liaojingwu20041031/electric-power-inspection-robot/docs/云平台连接运维.md

# Jetson 云平台连接运维

> Robot Platform Protocol v1 见 [协议文档](protocol/robot-platform-v1.md)。本文只覆盖 Jetson 部署、连接开关、观察、备份和回退，不授权任何实机运动。

## 1. 架构边界

网桥核心进程、本地 APP 服务和云平台连接是三个概念。核心进程同时承载 ROS、FastAPI
和 Cloud Client；本地 APP 开关只门控局域网手机接口；云平台开关只控制 Jetson 主动
发起的 HTTPS 连接。任一业务开关都不会停止核心进程。

Jetson 是公网连接的唯一发起方：

```text
Jetson mobile bridge -> HTTPS https://example.com/robot-api/v1
Robot Bridge          -X-> Jetson
```

Jetson 不需要公网 IP、端口映射或开放 8000。`/api/platform/v1` 只用于本机/可信局域网调试；配置 Cloud Link 后入站写控制默认关闭。

> 路由故障切换不等于 Wi-Fi 热点断线重连。`configure_dual_network.sh` 只管理有线/Wi-Fi
> 默认路由 metric；热点消失后重新关联和 DHCP 恢复由
> [热点断线自动重连运维](热点断线自动重连运维.md) 中的 NetworkManager 配置与 watchdog
> 负责。两套脚本互不修改对方字段。

### 1.1 单客户端双出口

本地 APP 的 Wi-Fi/有线地址是同时可访问的双入口；云平台不是双客户端并发。Cloud Link
只创建一个 `PlatformCloudClient`，保留唯一的 robotId、bootId、heartbeat、命令领取、
ACK 和事件上传状态，避免双客户端造成重复 heartbeat、重复 ACK、重复事件或重复命令。

公网出口由 Linux 系统路由决定，推荐 5G 有线默认路由 metric `100`，Wi-Fi 默认路由
metric `600`。有线接口 down、网线拔出或默认路由消失后，Cloud Client 的下一次正常
重试可由系统路由走 Wi-Fi。`cloud_status` 仅在本地增加 `networkMode=system-routing`、
`cloudEgress`、`alternateCloudRoutes`、`failoverAvailable` 和
`lastSuccessfulEgress` 诊断；这些字段不加入公网 heartbeat，平台协议无需同步修改。

接口断开和运营商 WAN 断开不同：若 5G CPE 网线仍连接、接口和默认路由仍存在，但 CPE
公网已经失效，单靠 route metric 不能保证主动切换。本轮不增加自动关网卡或动态改路由
守护程序。后续如需健康守护，应包含连续失败/成功阈值、最短保持时间、防抖和恢复逻辑。

### 1.2 NetworkManager 可逆配置

脚本只修改四个属性：IPv4/IPv6 的 `route-metric` 和 `never-default`，不修改地址、网关、
DNS、Wi-Fi 密码、自动连接、防火墙、SSH 或 NetworkManager 服务。

```bash
cd /home/nvidia/ros2_DL
YLHB_NETWORK_PRIMARY_CONNECTION='Wired connection 1' \
YLHB_NETWORK_SECONDARY_CONNECTION='xxfq1' \
./scripts/configure_dual_network.sh status

YLHB_NETWORK_PRIMARY_CONNECTION='Wired connection 1' \
YLHB_NETWORK_SECONDARY_CONNECTION='xxfq1' \
./scripts/configure_dual_network.sh dry-run
```

现场确认后才可执行 `apply`。脚本会先备份到
`~/.config/ylhb/dual_network_backup.json`，且不会自动 down/up 当前连接，以免立即中断
SSH；修改后由现场人员重新激活连接。恢复命令为：

```bash
./scripts/configure_dual_network.sh restore
```

若两个物理接口处于相同 IPv4 子网，脚本报告“网络子网冲突”并拒绝 apply；不要尝试自动
修复，应先调整热点或 5G CPE 的 LAN 网段。

## 2. `platform.env` 变量表

文件：`/home/nvidia/.config/ylhb/platform.env`，权限 `0600`。Token 不写 YAML、launch、仓库或日志。

| 变量 | 必填 | 示例 | 用途 | 敏感 | 修改后重启 |
| --- | --- | --- | --- | --- | --- |
| `YLHB_CLOUD_ENABLED` | 是 | `true` | systemd 启动后默认是否连接 | 否 | 是；UI override 可即时改变 |
| `YLHB_LOCAL_APP_ENABLED` | 否 | `true` | 本地 APP 服务默认是否开放 | 否 | 是；UI override 可即时改变 |
| `YLHB_CLOUD_BASE_URL` | 是 | `https://example.com` | 公网 Robot Bridge 根 URL；必须 HTTPS | 否 | 是 |
| `YLHB_CLOUD_ROBOT_TOKEN` | 是 | `token-placeholder` | robot-001 设备凭据 | 是 | 是 |
| `YLHB_CLOUD_CA_FILE` | 否 | `/etc/ssl/certs/private-ca.pem` | 私有 CA；公有 CA 留空 | 否 | 是 |
| `YLHB_CLOUD_REQUEST_TIMEOUT_SEC` | 否 | `10` | 单次 HTTP 超时 | 否 | 是 |
| `YLHB_CLOUD_IDLE_HEARTBEAT_SEC` | 否 | `3` | 空闲 fallback 心跳间隔 | 否 | 是 |
| `YLHB_CLOUD_ACTIVE_HEARTBEAT_SEC` | 否 | `1` | 活动 fallback 心跳间隔 | 否 | 是 |
| `YLHB_CLOUD_MAX_BACKOFF_SEC` | 否 | `30` | 最大退避 | 否 | 是 |
| `YLHB_MAP_UPLOAD_ENABLED` | 否 | `true` | 是否启动默认地图上传 worker | 否 | 是 |
| `YLHB_MAP_UPLOAD_CONNECT_TIMEOUT_SEC` | 否 | `10` | 地图上传连接超时 | 否 | 是 |
| `YLHB_MAP_UPLOAD_READ_TIMEOUT_SEC` | 否 | `60` | 地图上传响应读取超时 | 否 | 是 |
| `YLHB_MAP_UPLOAD_RETRY_BASE_SEC` | 否 | `2` | 地图上传指数退避初始秒数 | 否 | 是 |
| `YLHB_MAP_UPLOAD_RETRY_MAX_SEC` | 否 | `300` | 地图上传指数退避上限秒数 | 否 | 是 |
| `YLHB_MAP_UPLOAD_YAML_MAX_BYTES` | 否 | `1048576` | YAML 上限 1 MiB | 否 | 是 |
| `YLHB_MAP_UPLOAD_PGM_MAX_BYTES` | 否 | `104857600` | PGM 上限 100 MiB | 否 | 是 |
| `YLHB_MAP_UPLOAD_REQUEST_MAX_BYTES` | 否 | `115343360` | multipart 总上限 110 MiB | 否 | 是 |
| `YLHB_MAP_UPLOAD_SUCCESS_RETENTION_SEC` | 否 | `86400` | 成功快照保留时间 | 否 | 是 |
| `YLHB_MAP_UPLOAD_SUCCESS_KEEP` | 否 | `2` | 最多保留的成功快照数 | 否 | 是 |
| `YLHB_MAP_UPLOAD_SNAPSHOT_MAX_BYTES` | 否 | `1073741824` | 地图上传快照磁盘上限 | 否 | 是 |
| `YLHB_INSPECTION_IMAGE_UPLOAD_ENABLED` | 否 | `true` | 是否启用巡逻图片抓取和持久上传 | 否 | 是 |
| `YLHB_INSPECTION_IMAGE_UPLOAD_MAX_BYTES` | 否 | `20971520` | 单张图片上传上限 20 MiB | 否 | 是 |
| `YLHB_INSPECTION_IMAGE_UPLOAD_SNAPSHOT_MAX_BYTES` | 否 | `2147483648` | 图片快照磁盘上限 2 GiB | 否 | 是 |
| `YLHB_SOFTWARE_VERSION` | 否 | `79df249` | heartbeat 软件版本 | 否 | 是 |
| `YLHB_ROBOT_ID` | 是 | `robot-001` | 机器人身份 | 否 | 是 |
| `YLHB_PLATFORM_STORAGE_DIR` | 否 | `/home/nvidia/.local/share/ylhb/platform` | deployment、command、event SQLite 根目录 | 否 | 是 |
| `YLHB_PLATFORM_API_TOKEN` | 本地 API 启用时 | `token-placeholder` | `/api/platform/v1` 本地调试鉴权 | 是 | 是 |
| `YLHB_ALLOW_INBOUND_PLATFORM_CONTROL` | 否 | `false` | 是否允许本地入站写控制；生产保持 false | 否 | 是 |

受保护 env 示例仅使用占位值：

```dotenv
YLHB_CLOUD_ENABLED=true
YLHB_LOCAL_APP_ENABLED=true
YLHB_CLOUD_BASE_URL=https://example.com
YLHB_CLOUD_ROBOT_TOKEN=token-placeholder
YLHB_CLOUD_REQUEST_TIMEOUT_SEC=10
YLHB_CLOUD_IDLE_HEARTBEAT_SEC=3
YLHB_CLOUD_ACTIVE_HEARTBEAT_SEC=1
YLHB_CLOUD_MAX_BACKOFF_SEC=30
YLHB_MAP_UPLOAD_ENABLED=true
YLHB_MAP_UPLOAD_RETRY_BASE_SEC=2
YLHB_MAP_UPLOAD_RETRY_MAX_SEC=300
YLHB_INSPECTION_IMAGE_UPLOAD_ENABLED=true
YLHB_INSPECTION_IMAGE_UPLOAD_MAX_BYTES=20971520
YLHB_INSPECTION_IMAGE_UPLOAD_SNAPSHOT_MAX_BYTES=2147483648
YLHB_SOFTWARE_VERSION=79df249
YLHB_ROBOT_ID=robot-001
YLHB_PLATFORM_STORAGE_DIR=/home/nvidia/.local/share/ylhb/platform
YLHB_ALLOW_INBOUND_PLATFORM_CONTROL=false
```

不要提交该文件。公有 CA 场景不配置 `YLHB_CLOUD_CA_FILE`；禁止关闭 TLS 校验。

图片 worker 复用 Cloud URL、Token、CA、请求超时和最大退避。`401/403` 会停止新抓图；网络错误、`429/5xx` 使用原图片和原幂等键重试；最终失败图片保留作为证据，磁盘超限时只清理其中最旧的文件。

## 3. 安装与启动 systemd

```bash
cd /home/nvidia/ros2_DL
./scripts/install_platform_bridge_service.sh
sudo systemctl status ylhb-mobile-bridge --no-pager
sudo systemctl enable ylhb-mobile-bridge
sudo systemctl restart ylhb-mobile-bridge
```

生产 UI/Supervisor 必须传：

```text
mobile_bridge_managed_externally:=true
```

其配置语义是 `mobile_bridge_managed_externally=true`；ROS 2 launch 命令行使用 `:=true` 赋值语法。

仓库的 UI 自启动 wrapper 已传该参数。此时 Supervisor 不再启动、停止或重启 mobile bridge，只观察端口状态，避免双实例。

## 4. 确认只有一个 Mobile Bridge

```bash
systemctl is-active ylhb-mobile-bridge
pgrep -af 'ylhb_mobile_bridge mobile_bridge_server'
ros2 node list --no-daemon | grep mobile_bridge
ss -lntp | grep ':8000'
```

通过标准：

- systemd active；
- 只有一个 `mobile_bridge_server` 进程；
- 只有一个对应 ROS node；
- 8000 只有一个监听者。

若有第二个开发 launch，停止开发终端中的实例；不要 kill systemd 后让 Supervisor 接管生产进程。

## 5. Cloud status Topic

```bash
ros2 topic info /mobile_bridge/cloud_status -v --no-daemon
ros2 topic echo /mobile_bridge/cloud_status --once
```

主要字段：configured、desiredEnabled、connected、state、heartbeatInFlight、consecutiveFailures、serverBaseUrl、pendingEventCount、pendingCommandCount、lastReceivedCommandId、lastUploadedSequence、latestLocalEventSequence、activeExecutionId、activeDeploymentId、lastSuccessAt、lastError、nextHeartbeatSec、nextRetrySec。

`CONNECTED` 时下一轮 heartbeat 会保持连接状态，仅 `heartbeatInFlight=true`；`nextHeartbeatSec` 是正常心跳间隔。只有网络/HTTP 通信失败才进入 `BACKOFF`，此时 `nextRetrySec` 是退避重试时间。UI 主卡以 `connected=true` 为优先级，不把短暂 raw `CONNECTING` 显示为断线；raw state 保留在诊断区。

Topic 使用可靠、Transient Local QoS，UI 晚加入也能获得最近状态。

## 6. SetBool 连接开关

只控制 Cloud Link，不控制巡检：

```bash
ros2 service type /mobile_bridge/set_cloud_enabled
ros2 service call /mobile_bridge/set_cloud_enabled std_srvs/srv/SetBool '{data: false}'
ros2 service call /mobile_bridge/set_cloud_enabled std_srvs/srv/SetBool '{data: true}'
```

- false：持久化 override，进入 DISABLED，停止 heartbeat/领命令/上传事件。
- 关闭连接不会停止当前巡检，不会发布 pause/cancel/急停。
- true：进入 CONNECTING，成功后 CONNECTED，并从服务器连续游标补传积压事件。
- 配置缺失时开启返回失败，state 保持 UNCONFIGURED。

## 7. UI 开关与状态

本体 UI“连接与服务”页有两个独立 Switch：

- 本地 APP Switch 调用 `/mobile_bridge/set_local_app_enabled`；关闭不会改变
  `cloudStatus.desiredEnabled`，Cloud Client 继续 heartbeat 和事件补传。
- 云平台 Switch 调用 `/mobile_bridge/set_cloud_enabled`；关闭不会改变
  `localAppStatus.enabled`，手机仍可访问本地 API/WS。
- 两个 Switch 都不会调用 systemd、Shell 或核心进程启停命令。
- Service 成功只表示请求被接受；Switch 保持用户目标，直到状态 Topic 确认，5 秒无确认会提示而不伪造成功。

UI 不再用 Supervisor 的单个 process 字段全局锁死两张卡。每秒直接检查两个 SetBool Service 与两个状态 Topic publisher：本地 APP 开关只依赖本地 Service/状态，云开关只依赖 Cloud Service/状态和 `configured`。核心未启动、Topic 状态过期、Cloud 网络离线是三种不同状态；本地 APP 关闭也不会被解释为核心进程停止。兼容字段 `mobile_bridge_http` 实际是 8000 TCP 探测，新代码优先使用 `mobile_bridge_core_state` 与 `mobile_bridge_tcp`。

Cloud SetBool 成功或失败后都会立即发布一次 `/mobile_bridge/cloud_status`，无需等待 0.5 秒周期刷新；失败状态只记录脱敏异常类型。

云平台卡显示：

| 状态 | 含义 | 操作 |
| --- | --- | --- |
| `UNCONFIGURED` | URL/Token/CA 配置无效 | 修复 env，重启服务 |
| `DISABLED` | 用户或 env 关闭连接 | 可手动开启 |
| `CONNECTING` | 正在建立/恢复连接 | 等待或看日志 |
| `CONNECTED` | 最近心跳成功 | 正常 |
| `BACKOFF` | 网络/HTTP 失败，指数退避 | 看 lastError、TLS、DNS、服务状态 |

活动 execution 中关闭云开关必须确认，明确说明本地 APP 和当前巡检不会停止，积压事件
在重连后补传。关闭本地 APP 使用另一份确认文案，明确说明云平台连接和当前巡检不受影响。

本地 APP override 保存在 `bridge_settings.local_app_enabled_override`；云平台 override
仍保存在 `cloud_state.cloud_enabled_override`，两者不共享字段。

## 8. 入站控制默认关闭

生产保持：

```text
YLHB_ALLOW_INBOUND_PLATFORM_CONTROL=false
```

配置 Cloud Link 后，Jetson `/api/platform/v1` 的 deploy/start/pause/resume/takeover/cancel 写接口返回 `409 INBOUND_CONTROL_DISABLED`。暂停 Cloud Link 不会自动开放入站控制。

## 9. 日志与脱敏检查

```bash
sudo journalctl -u ylhb-mobile-bridge -n 200 --no-pager
sudo journalctl -u ylhb-mobile-bridge -f
```

Cloud Client 只应记录 HTTP 状态、异常类型和脱敏 URL。验证 Token 未打印时，不输出 Token 本身：

```bash
sudo journalctl -u ylhb-mobile-bridge --since today --no-pager \
  | grep -E 'Authorization:|Bearer |YLHB_CLOUD_ROBOT_TOKEN|token=' && echo '发现疑似敏感日志' || echo '未发现常见敏感模式'
```

还应人工确认 serverBaseUrl 不含 userinfo、query 或 fragment。

## 10. 备份 Robot 平台 SQLite

默认目录：

```text
~/.local/share/ylhb/platform/platform.db
~/.local/share/ylhb/platform/deployments/
```

在线备份：

```bash
mkdir -p /home/nvidia/backups/ylhb-platform
sqlite3 /home/nvidia/.local/share/ylhb/platform/platform.db \
  ".backup '/home/nvidia/backups/ylhb-platform/platform.db.backup'"
tar -C /home/nvidia/.local/share/ylhb/platform -czf \
  /home/nvidia/backups/ylhb-platform/deployments.backup.tgz deployments
```

备份文件必须限制权限，不上传公共位置。恢复前停止 systemd，保留故障副本，再同时恢复数据库和 deployment 文件。

## 11. 无运动连接验收

云连接显示 `CONNECTED` 只证明 Jetson 能持续 heartbeat；`READY_FOR_ROBOT` 只证明路线和地图已缓存。控制闭环还必须依次确认：Bridge command 出现并被 heartbeat 领取、Jetson 提交 ACK、ROS 收到命令、真实事件上传、Spring 消费事件并通过 STOMP 更新前端。

开发人员可执行只读检查：查看 cloud status、Bridge command/execution/event 表、ROS topic/node 信息和日志；不得据此代替现场路线运动验收。任何 START、恢复、Nav2 goal 或可能驱动底盘的操作均由现场用户确认安全后执行。

```bash
ros2 topic echo /mobile_bridge/cloud_status --once
sudo systemctl status ylhb-mobile-bridge --no-pager
```

通过标准：CONNECTED、pendingCommandCount=0、服务器 robot online=true、日志无 Token、只有一个 bridge。此步骤不创建 START，也不启动巡逻。

## 12. 回退到本地 auto 巡逻

回退只改变云连接来源，不代表授权机器人运动：

1. 通过 SetBool 关闭 Cloud Link，确认 DISABLED。
2. 保留 platform SQLite 与 pending event，不删除，便于恢复后补传。
3. 如需停止 systemd，仅在确认本地调试模式会单独启动 mobile bridge 时执行。
4. 本地路线使用仓库既有 `auto` 解析和正式路线文件，不使用云 deployment 路径。
5. 由现场用户确认急停、清场、传感器、TF、Nav2、地图和路线后，执行既有本地巡逻入口。

现场命令参考（仅用户授权后执行）：

```bash
./scripts/run_on_jetson.sh inspection
```

恢复云连接时重新启用 systemd/SetBool，等待 CONNECTED 和事件补传完成；不要在本地巡逻仍活动时领取新的 START。

## 13. 常见故障

| 症状 | 检查 |
| --- | --- |
| UNCONFIGURED | HTTPS URL、robot token、CA 文件、robotId |
| BACKOFF HTTP 401 | token 与服务器 robotId 映射；按轮换流程更新 |
| BACKOFF TLS | 域名、证书链、时间、CA 文件；禁止关闭校验 |
| CONNECTED 但 server offline | 对比服务器 lastSeen、代理路径、时间同步 |
| pendingEventCount 不下降 | accepted sequence、事件缺口、events batch 409 |
| command 长期 ACKED | ROS publish/Patrol event、system supervisor、commandId 绑定 |
| 双实例 | systemd + 开发 launch；确保 external managed=true |
| 入站接口 409 | 生产预期；不要为方便而打开入站控制 |
