liaojingwu20041031/electric-power-inspection-robot/docs/protocol/机器人平台协议-v1.md

# 协议文档路径已迁移

Robot Platform Protocol v1 的规范副本已迁移到 [robot-platform-v1.md](robot-platform-v1.md)。

平台仓库 `docs/protocol/robot-platform-v1.md` 是单一协议源；本仓库同名文件通过平台脚本同步并要求字节一致。请勿在此兼容入口继续维护协议正文。
