liaojingwu20041031/electric-power-inspection-robot/UI_sc/UI图标.png

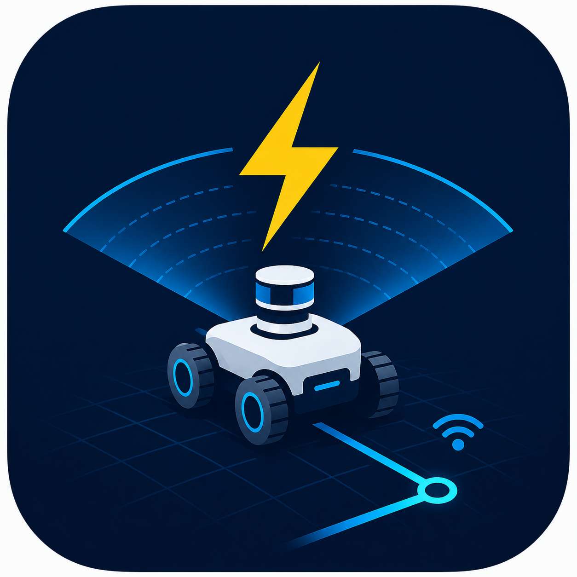
UI_sc/UI图标.png
