liaojingwu20041031/electric-power-inspection-robot/UI_sc/UI背景图1.png

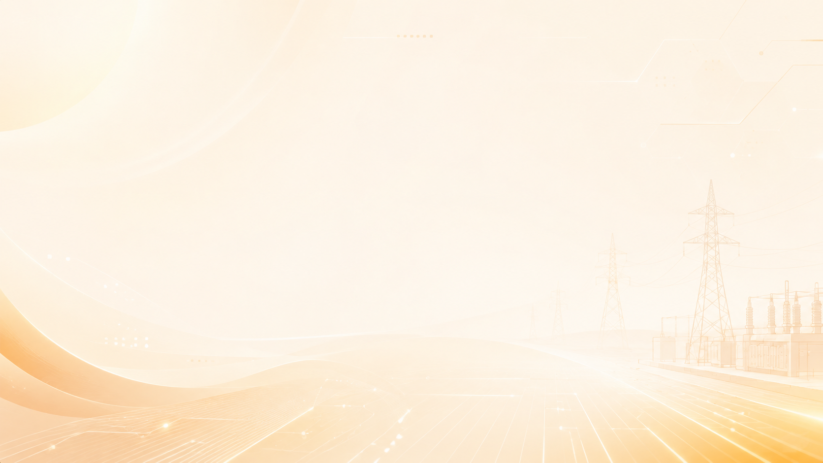
UI_sc/UI背景图1.png
