liaojingwu20041031/electric-power-inspection-robot/UI_sc/背景图2 (1).png

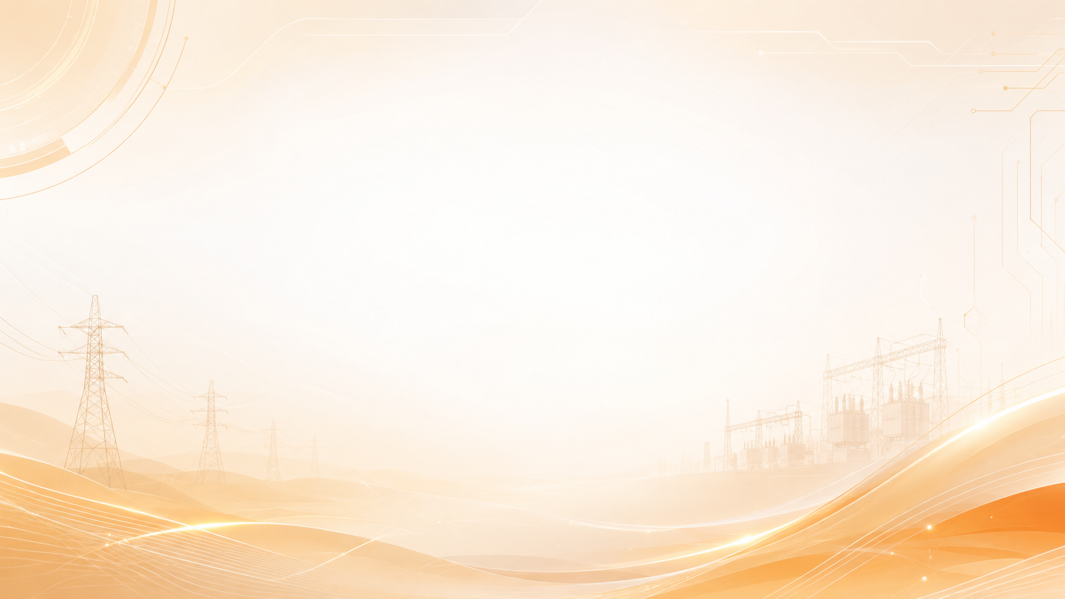
UI_sc/背景图2 (1).png
