liaojingwu20041031/electric-power-inspection-robot/UI_sc/背景图2 (4).png

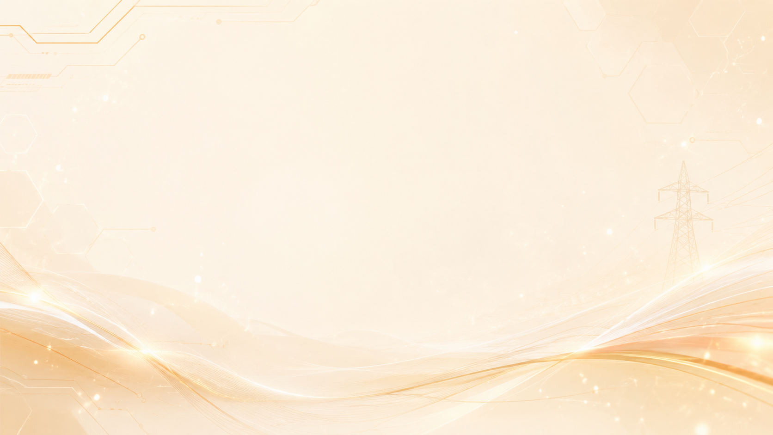
UI_sc/背景图2 (4).png
