liaojingwu20041031/electric-power-inspection-robot/记录照片/5D8596298CAE2FFCB6F57D26CB58A5C1.png

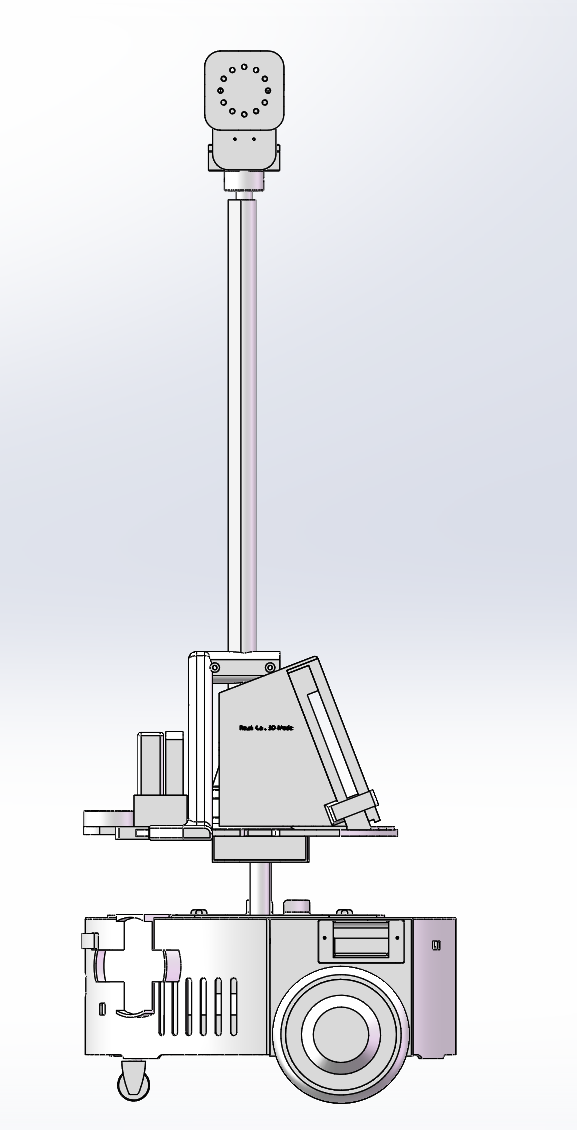
记录照片/5D8596298CAE2FFCB6F57D26CB58A5C1.png
