liaojingwu20041031/electric-power-inspection-robot/记录照片/23B6CF8AAC715B70C368A7C031887BE1.png

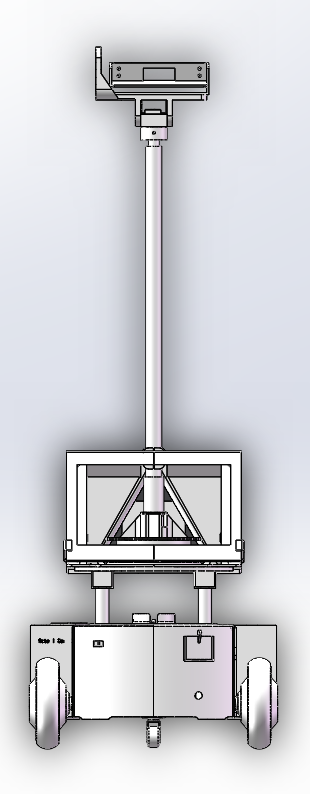
记录照片/23B6CF8AAC715B70C368A7C031887BE1.png
