liaojingwu20041031/electric-power-inspection-robot/记录照片/DE87C7969D653431019BBF287BD9881B.png

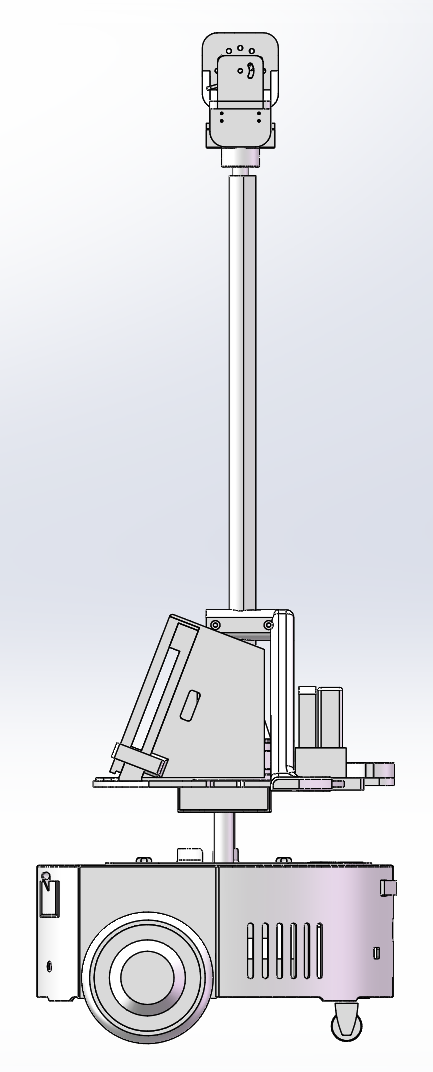
记录照片/DE87C7969D653431019BBF287BD9881B.png
