liaojingwu20041031/electric-power-inspection-robot/CAD/Retail-Cart-3D-Model/sldasm/万向轮.SLDASM

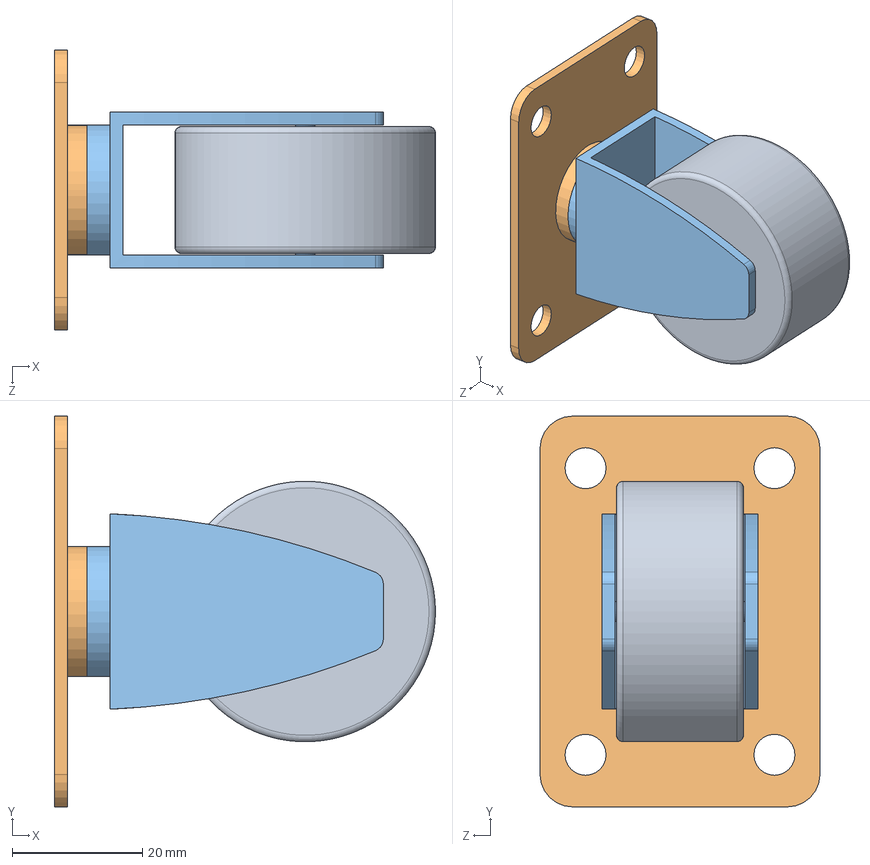
[picture p11: CAD file, 2026-06-11]
CAD/Retail-Cart-3D-Model/sldasm/万向轮.SLDASM
58.5 x 60.0 x 43.0 mm
万向轮
万向轮底座
万向轮支架
