liaojingwu20041031/electric-power-inspection-robot/CAD/Retail-Cart-3D-Model/sldasm/小车底盘.SLDASM

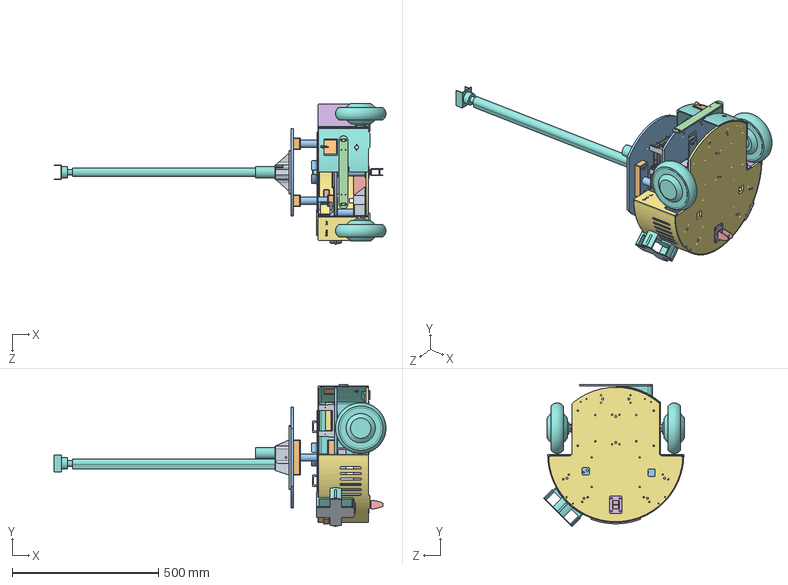
[picture p12: CAD file, 2026-06-11]
CAD/Retail-Cart-3D-Model/sldasm/小车底盘.SLDASM
1136.5 x 487.1 x 482.1 mm
底盘连接处支架X x 2
电机轮 x 2
人工智能小车底盘
万向轮底座
万向轮支架
固定盖 x 2
上底盘
螺母 x 2
驱动器
前半圆X
后半圆
后半圆X
电池
英伟达固定板X
工形柱 x 5
支架垫片 x 4
语音播报模块固定盖
语音播报模块外挂支架
电池固定
模块固定
后半圆固定架
双目垫板
第三层板
伸缩杆支架盖子
伸缩杆固定底座
伸缩杆
连接-固定件
前后半圆连接件 x 2
后半圆连接-固定件
盖板
激光雷达固定架
电池门
稳压板底座
