liaojingwu20041031/electric-power-inspection-robot/CAD/Retail-Cart-3D-Model/stp/伸缩柱.SLDPRT

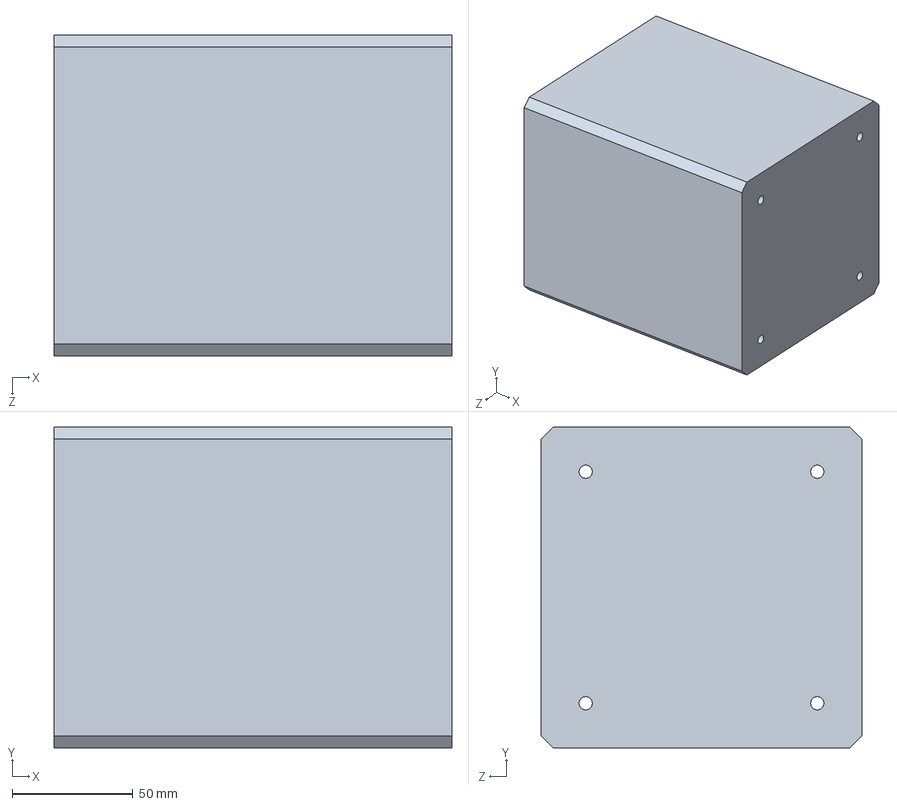
[picture p13: CAD file, 2026-06-11]
CAD/Retail-Cart-3D-Model/stp/伸缩柱.SLDPRT
165.0 x 133.0 x 133.0 mm
