liaojingwu20041031/electric-power-inspection-robot/CAD/Retail-Cart-3D-Model/stp/后半圆X.SLDPRT

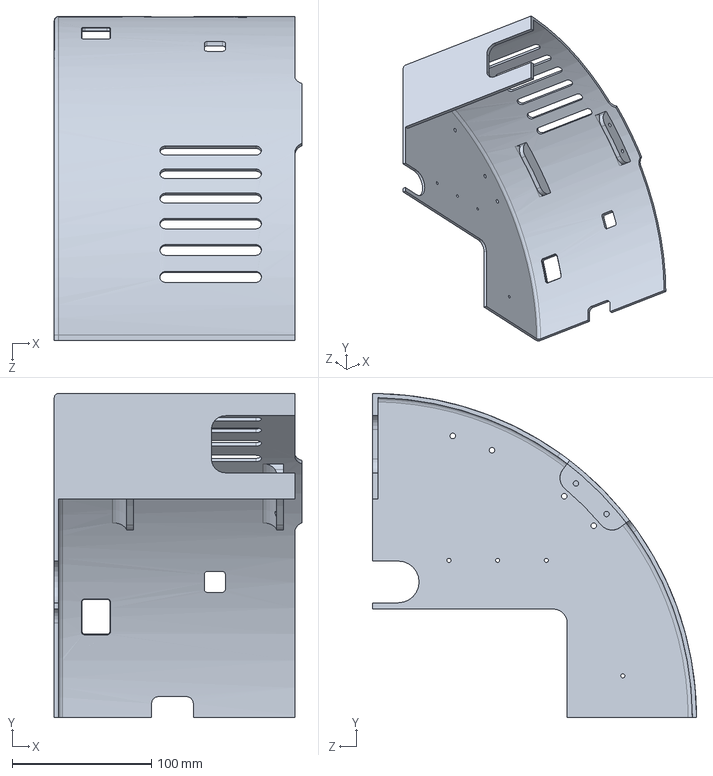
[picture p14: CAD file, 2026-06-11]
CAD/Retail-Cart-3D-Model/stp/后半圆X.SLDPRT
178.0 x 233.0 x 233.0 mm
