liaojingwu20041031/electric-power-inspection-robot/CAD/Retail-Cart-3D-Model/stp/万向轮支架.SLDPRT

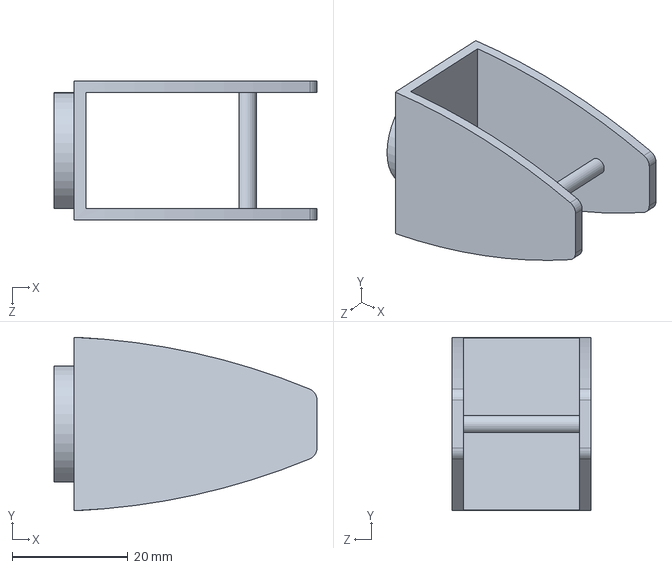
[picture p15: CAD file, 2026-06-11]
CAD/Retail-Cart-3D-Model/stp/万向轮支架.SLDPRT
45.5 x 30.0 x 24.0 mm
