liaojingwu20041031/electric-power-inspection-robot/CAD/Retail-Cart-3D-Model/stp/电池.SLDPRT

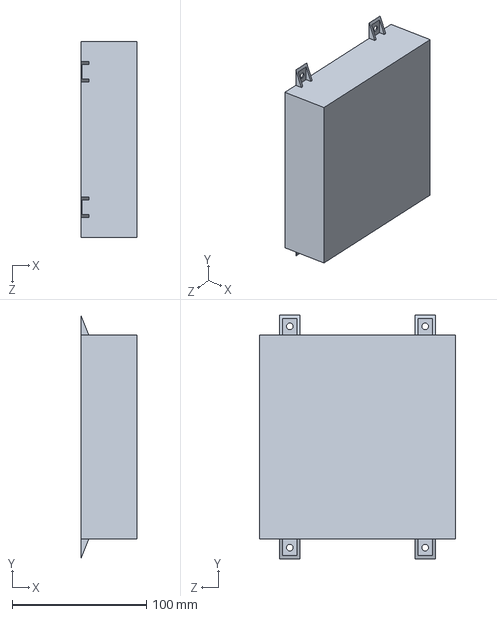
[picture p16: CAD file, 2026-06-11]
CAD/Retail-Cart-3D-Model/stp/电池.SLDPRT
42.0 x 182.0 x 146.0 mm
