liaojingwu20041031/electric-power-inspection-robot/CAD/Retail-Cart-3D-Model/stp/万向轮底座.SLDPRT

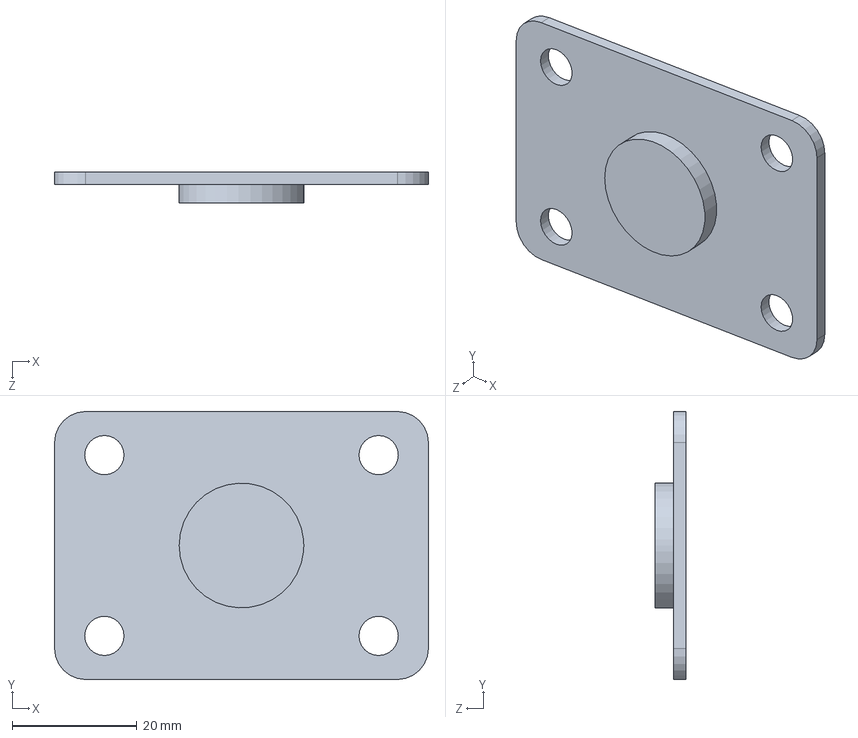
[picture p17: CAD file, 2026-06-11]
CAD/Retail-Cart-3D-Model/stp/万向轮底座.SLDPRT
60.0 x 43.0 x 5.00 mm
