liaojingwu20041031/electric-power-inspection-robot/CAD/Retail-Cart-3D-Model/stp/前半圆.SLDPRT

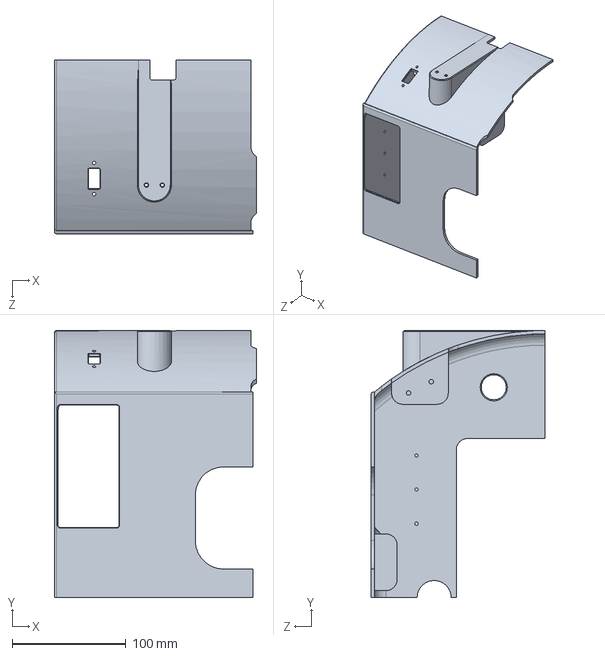
[picture p18: CAD file, 2026-06-11]
CAD/Retail-Cart-3D-Model/stp/前半圆.SLDPRT
178.0 x 235.0 x 153.0 mm
