liaojingwu20041031/electric-power-inspection-robot/CAD/Retail-Cart-3D-Model/stp/稳压板底座.SLDPRT

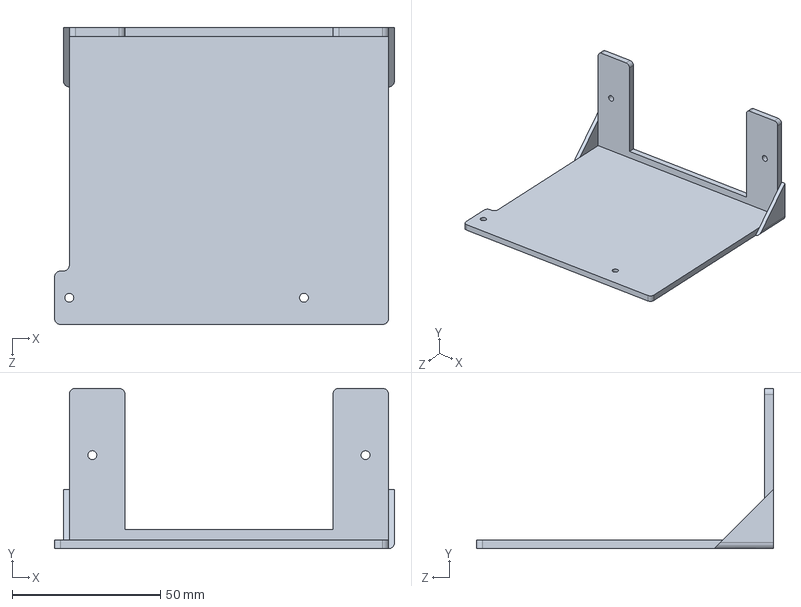
[picture p19: CAD file, 2026-06-11]
CAD/Retail-Cart-3D-Model/stp/稳压板底座.SLDPRT
114.5 x 54.0 x 100.0 mm
