liaojingwu20041031/electric-power-inspection-robot/CAD/Retail-Cart-3D-Model/stp/电机轮.SLDPRT

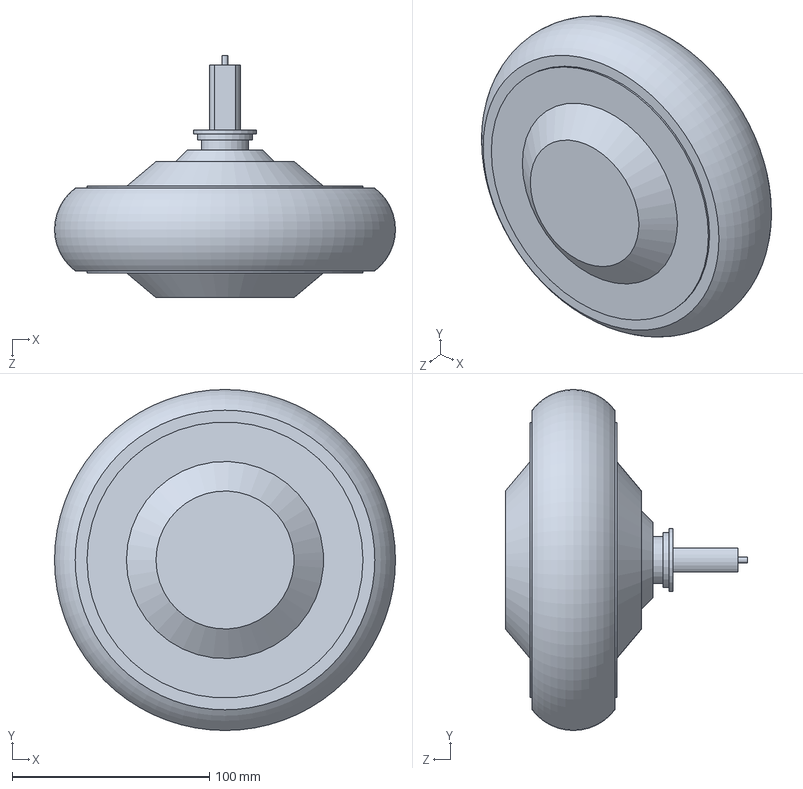
[picture p20: CAD file, 2026-06-11]
CAD/Retail-Cart-3D-Model/stp/电机轮.SLDPRT
173.0 x 173.0 x 123.0 mm
