liaojingwu20041031/electric-power-inspection-robot/CAD/Retail-Cart-3D-Model/stp/工形柱.SLDPRT

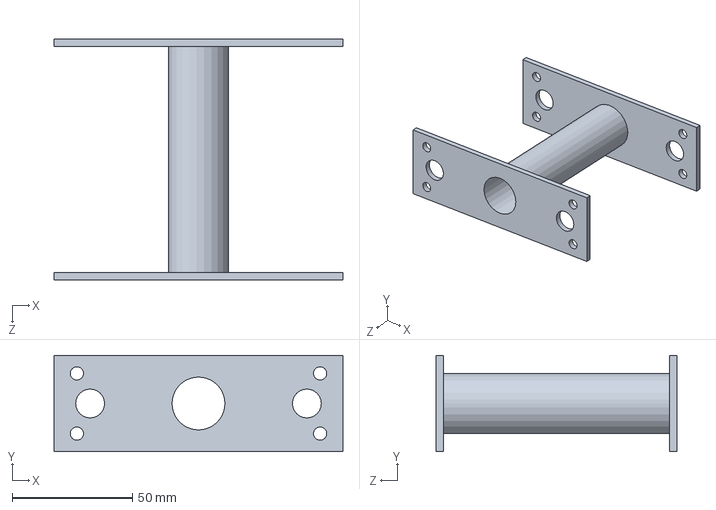
[picture p21: CAD file, 2026-06-11]
CAD/Retail-Cart-3D-Model/stp/工形柱.SLDPRT
120.0 x 40.0 x 100.0 mm
