liaojingwu20041031/electric-power-inspection-robot/CAD/Retail-Cart-3D-Model/stp/激光雷达支架.SLDPRT

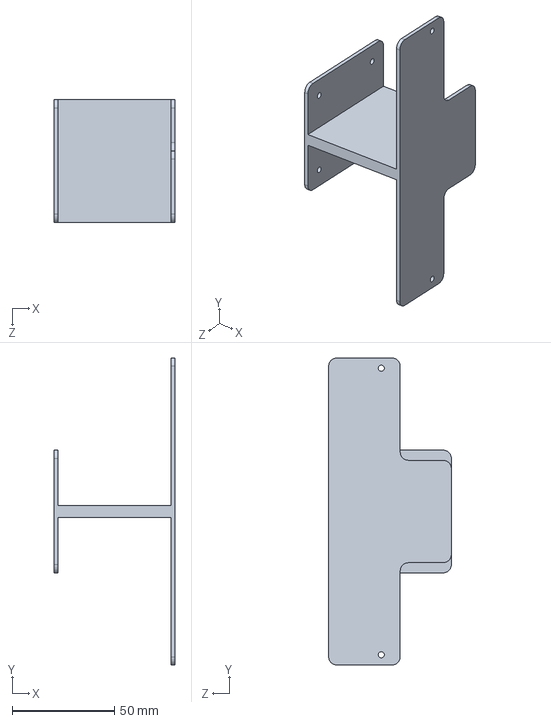
[picture p22: CAD file, 2026-06-11]
CAD/Retail-Cart-3D-Model/stp/激光雷达支架.SLDPRT
59.0 x 150.0 x 60.0 mm
