liaojingwu20041031/electric-power-inspection-robot/CAD/Retail-Cart-3D-Model/stp/英伟达固定板X.SLDPRT

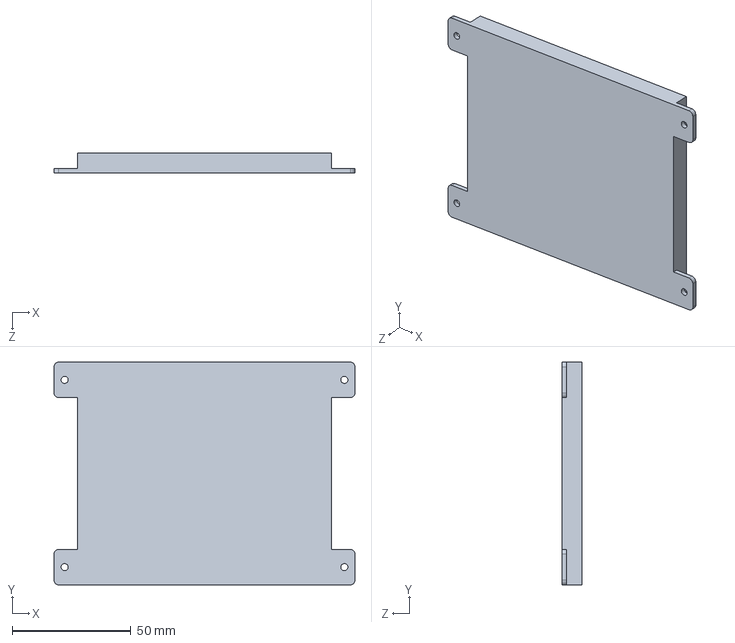
[picture p23: CAD file, 2026-06-11]
CAD/Retail-Cart-3D-Model/stp/英伟达固定板X.SLDPRT
127.0 x 94.0 x 8.50 mm
