liaojingwu20041031/electric-power-inspection-robot/CAD/Retail-Cart-3D-Model/stp/语音播报模块外挂支架.SLDPRT

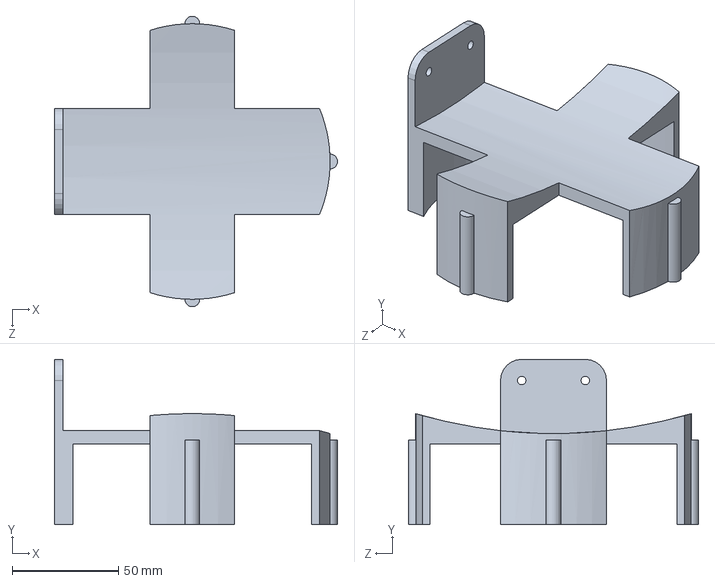
[picture p24: CAD file, 2026-06-11]
CAD/Retail-Cart-3D-Model/stp/语音播报模块外挂支架.SLDPRT
133.5 x 78.0 x 136.9 mm
