liaojingwu20041031/electric-power-inspection-robot/CAD/Retail-Cart-3D-Model/stp/前后半圆连接件.SLDPRT

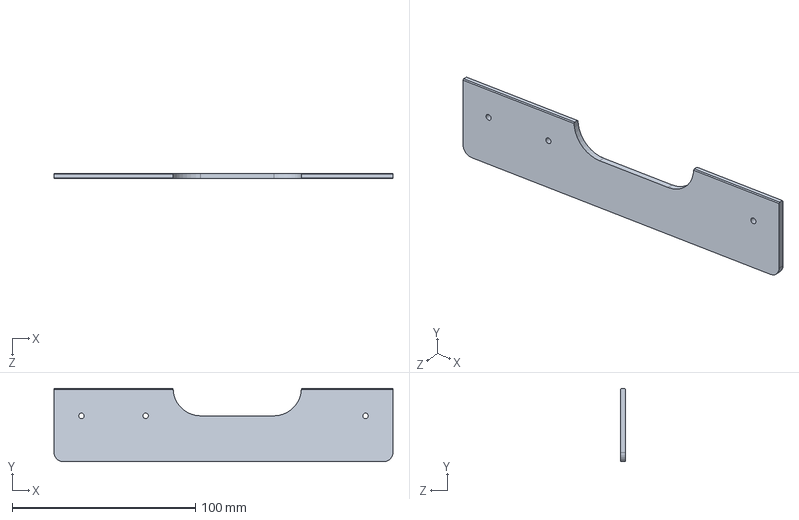
[picture p25: CAD file, 2026-06-11]
CAD/Retail-Cart-3D-Model/stp/前后半圆连接件.SLDPRT
185.0 x 40.0 x 3.00 mm
