liaojingwu20041031/electric-power-inspection-robot/CAD/Retail-Cart-3D-Model/stp/后半圆固定架.SLDPRT

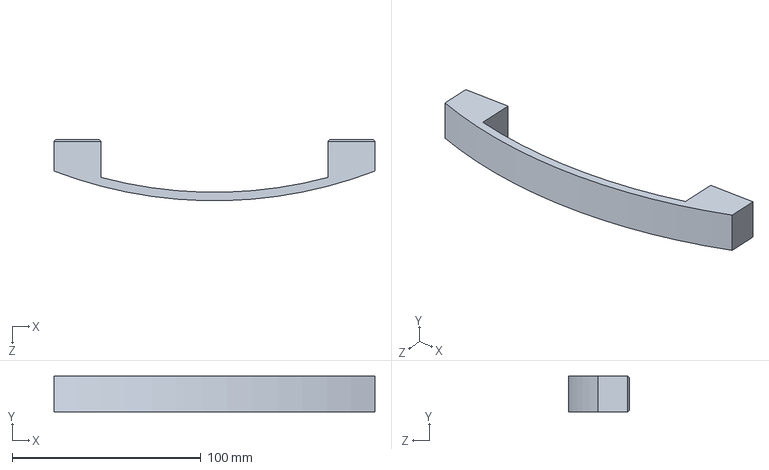
[picture p26: CAD file, 2026-06-11]
CAD/Retail-Cart-3D-Model/stp/后半圆固定架.SLDPRT
170.0 x 19.0 x 32.4 mm
