liaojingwu20041031/electric-power-inspection-robot/CAD/Retail-Cart-3D-Model/stp/第三层板.SLDPRT

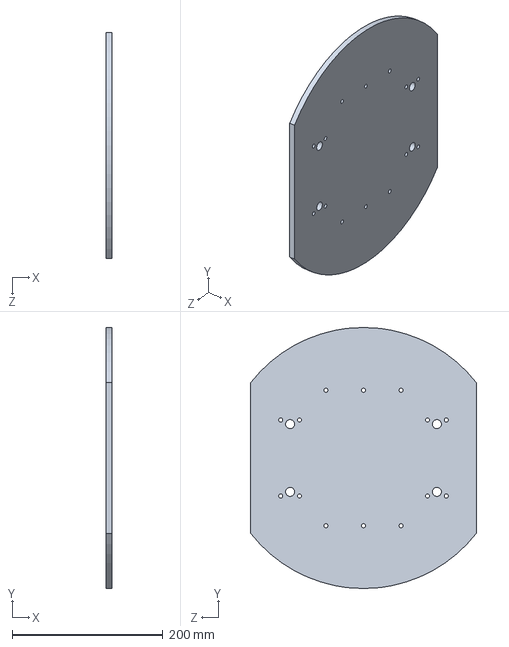
[picture p27: CAD file, 2026-06-11]
CAD/Retail-Cart-3D-Model/stp/第三层板.SLDPRT
8.00 x 346.8 x 300.0 mm
