liaojingwu20041031/electric-power-inspection-robot/CAD/Retail-Cart-3D-Model/stp/模块固定.SLDPRT

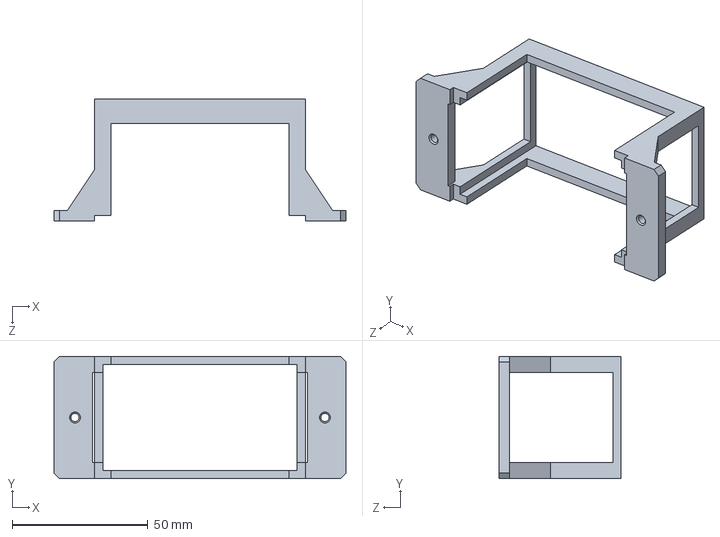
[picture p28: CAD file, 2026-06-11]
CAD/Retail-Cart-3D-Model/stp/模块固定.SLDPRT
107.5 x 45.0 x 45.0 mm
