liaojingwu20041031/electric-power-inspection-robot/CAD/Retail-Cart-3D-Model/stp/连接-固定件.SLDPRT

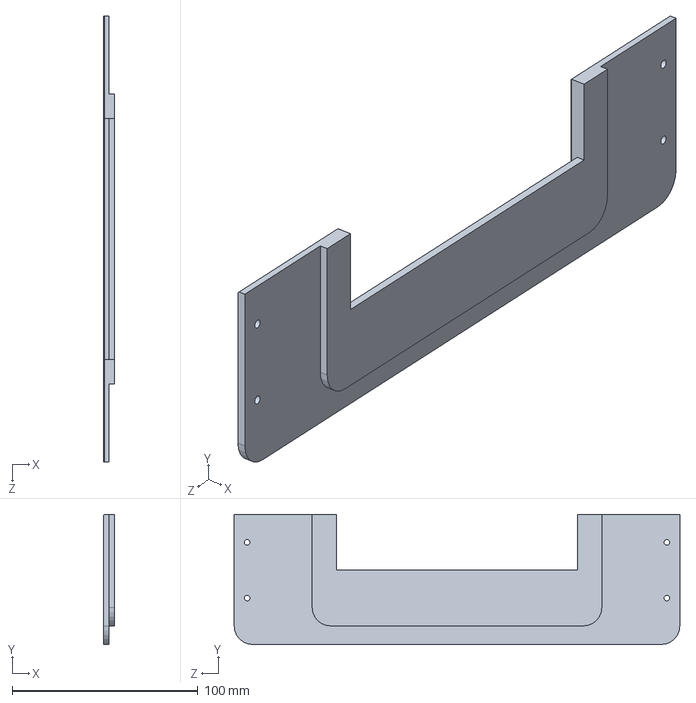
[picture p29: CAD file, 2026-06-11]
CAD/Retail-Cart-3D-Model/stp/连接-固定件.SLDPRT
6.00 x 70.0 x 240.0 mm
