liaojingwu20041031/electric-power-inspection-robot/CAD/Retail-Cart-3D-Model/stp/前半圆X.SLDPRT

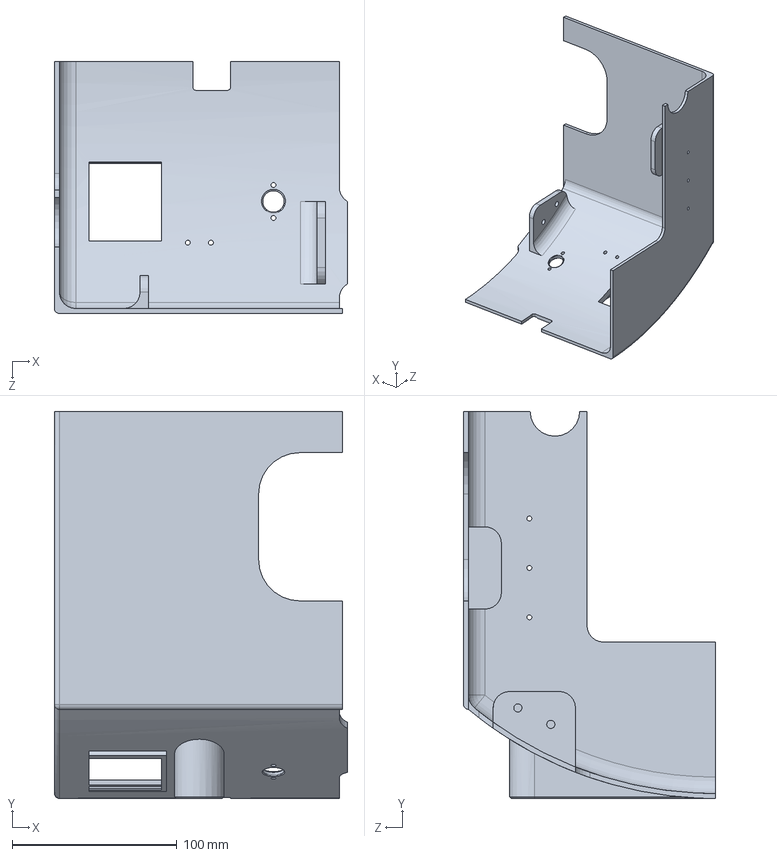
[picture p30: CAD file, 2026-06-11]
CAD/Retail-Cart-3D-Model/stp/前半圆X.SLDPRT
178.0 x 235.0 x 153.0 mm
