liaojingwu20041031/electric-power-inspection-robot/CAD/Retail-Cart-3D-Model/stp/电池门.SLDPRT

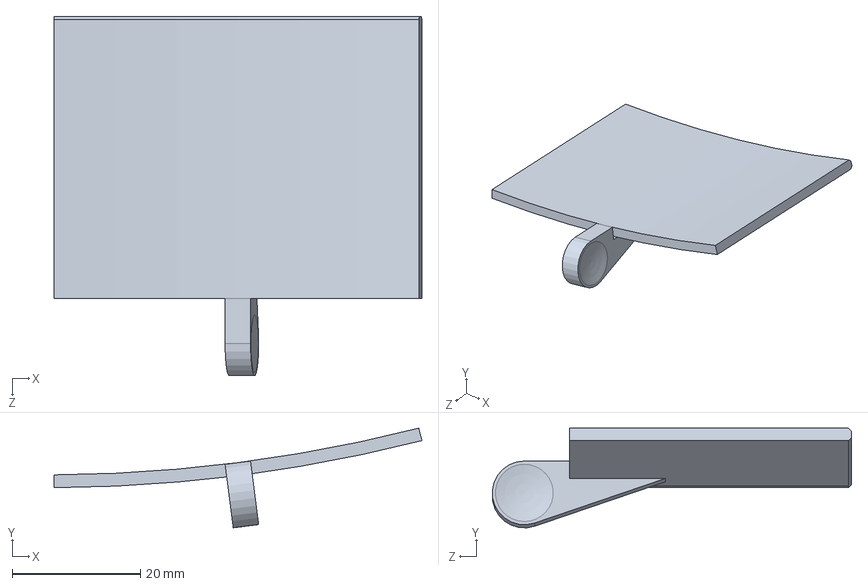
[picture p31: CAD file, 2026-06-11]
CAD/Retail-Cart-3D-Model/stp/电池门.SLDPRT
57.3 x 15.5 x 56.0 mm
