liaojingwu20041031/electric-power-inspection-robot/CAD/Retail-Cart-3D-Model/stp/驱动器.SLDPRT

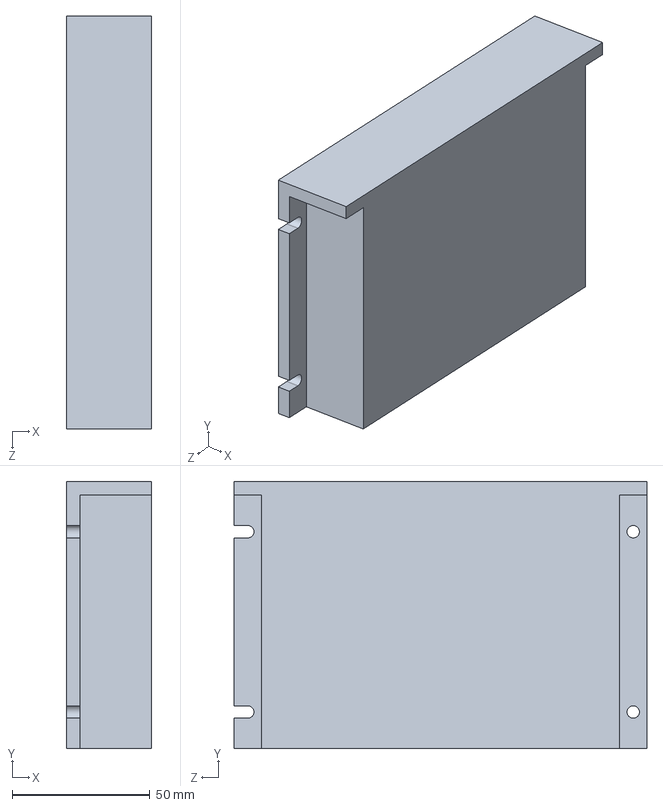
[picture p32: CAD file, 2026-06-11]
CAD/Retail-Cart-3D-Model/stp/驱动器.SLDPRT
31.0 x 97.0 x 150.0 mm
