liaojingwu20041031/electric-power-inspection-robot/CAD/Retail-Cart-3D-Model/stp/伸缩杆.SLDPRT

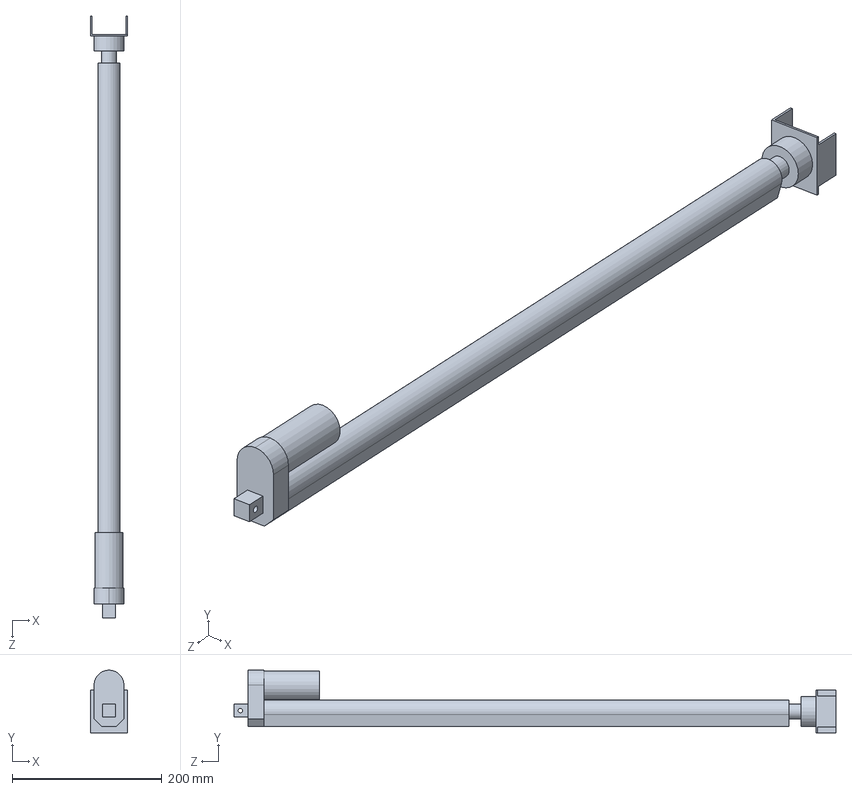
[picture p33: CAD file, 2026-06-11]
CAD/Retail-Cart-3D-Model/stp/伸缩杆.SLDPRT
50.0 x 83.8 x 803.0 mm
