liaojingwu20041031/electric-power-inspection-robot/CAD/Retail-Cart-3D-Model/stp/激光雷达固定架.SLDPRT

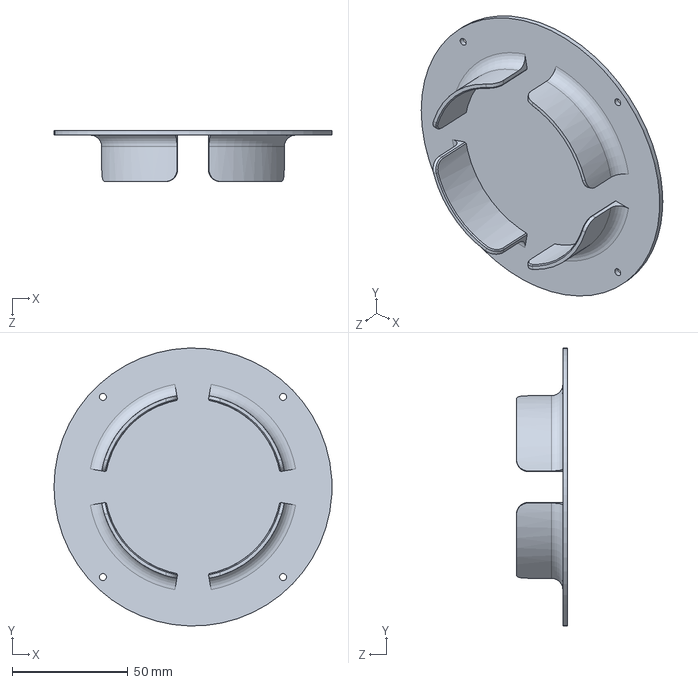
[picture p34: CAD file, 2026-06-11]
CAD/Retail-Cart-3D-Model/stp/激光雷达固定架.SLDPRT
120.0 x 119.9 x 22.0 mm
