liaojingwu20041031/electric-power-inspection-robot/CAD/Retail-Cart-3D-Model/stp/支架垫片.SLDPRT

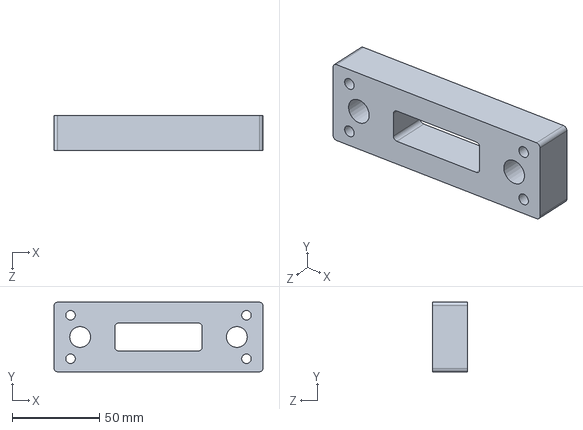
[picture p35: CAD file, 2026-06-11]
CAD/Retail-Cart-3D-Model/stp/支架垫片.SLDPRT
120.0 x 40.0 x 20.0 mm
