liaojingwu20041031/electric-power-inspection-robot/CAD/Retail-Cart-3D-Model/stp/电池固定.SLDPRT

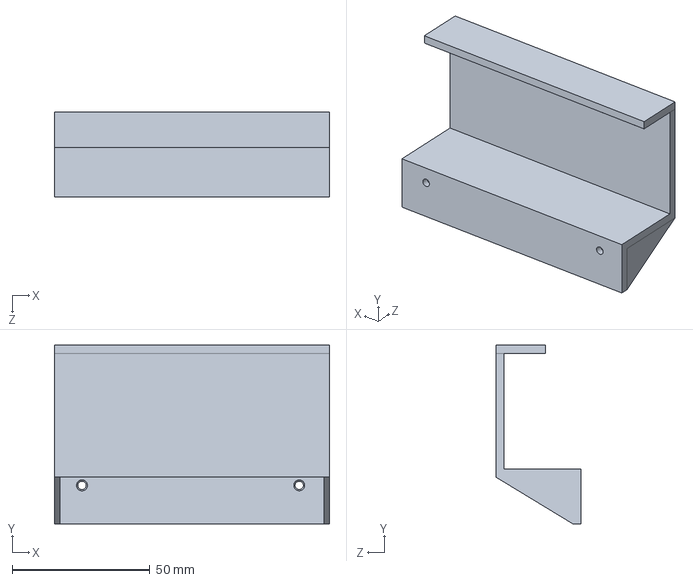
[picture p36: CAD file, 2026-06-11]
CAD/Retail-Cart-3D-Model/stp/电池固定.SLDPRT
100.0 x 65.0 x 31.0 mm
