liaojingwu20041031/electric-power-inspection-robot/CAD/Retail-Cart-3D-Model/stp/底盘连接处支架X.SLDPRT

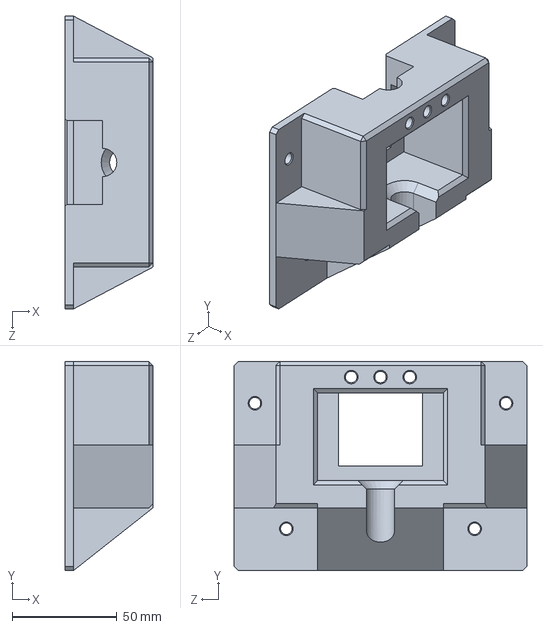
[picture p37: CAD file, 2026-06-11]
CAD/Retail-Cart-3D-Model/stp/底盘连接处支架X.SLDPRT
42.0 x 100.0 x 140.0 mm
