liaojingwu20041031/electric-power-inspection-robot/CAD/Retail-Cart-3D-Model/stp/模块固定盖.SLDPRT

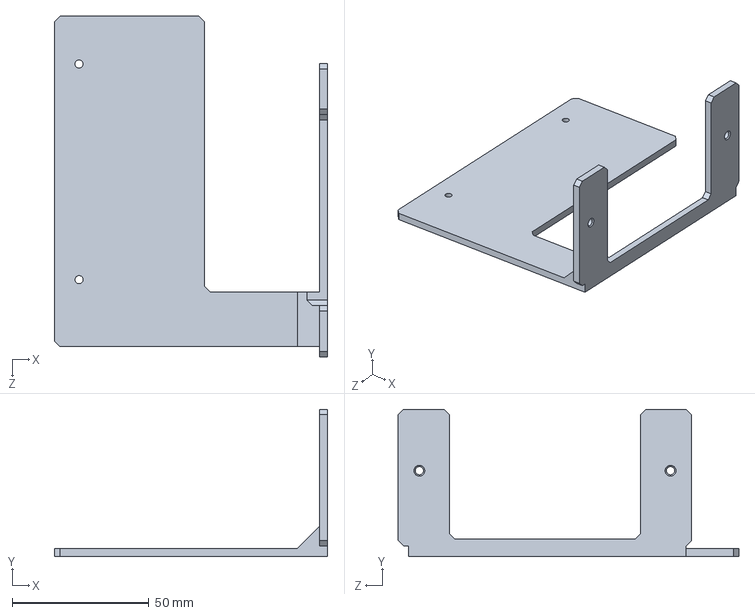
[picture p38: CAD file, 2026-06-11]
CAD/Retail-Cart-3D-Model/stp/模块固定盖.SLDPRT
100.0 x 54.0 x 124.8 mm
