liaojingwu20041031/electric-power-inspection-robot/CAD/Retail-Cart-3D-Model/stp/伸缩柱底座.SLDPRT

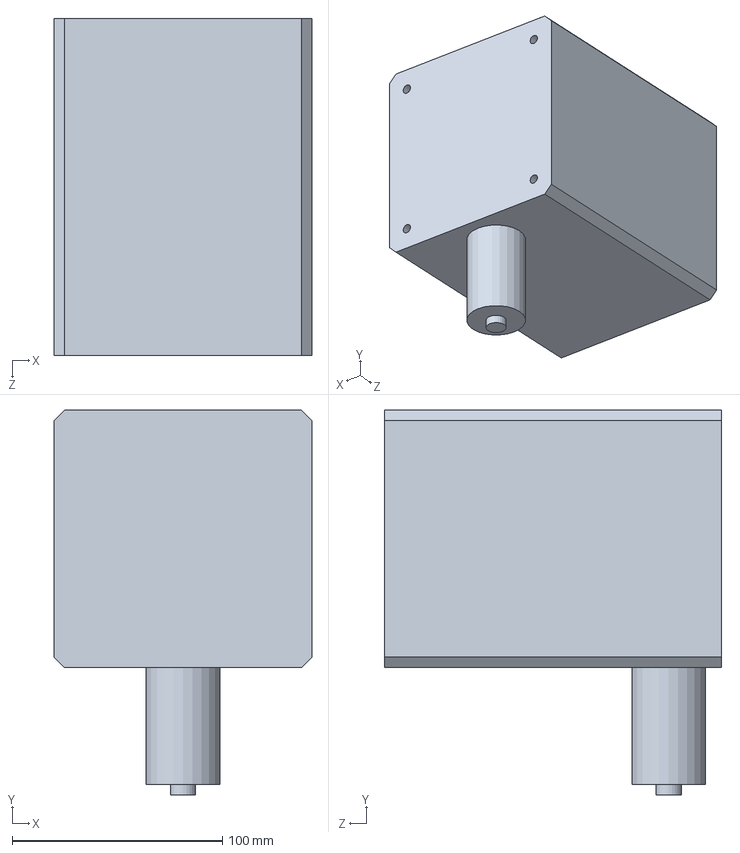
[picture p39: CAD file, 2026-06-11]
CAD/Retail-Cart-3D-Model/stp/伸缩柱底座.SLDPRT
122.5 x 183.0 x 160.0 mm
