liaojingwu20041031/electric-power-inspection-robot/CAD/Retail-Cart-3D-Model/stp/人工智能小车底盘.SLDPRT

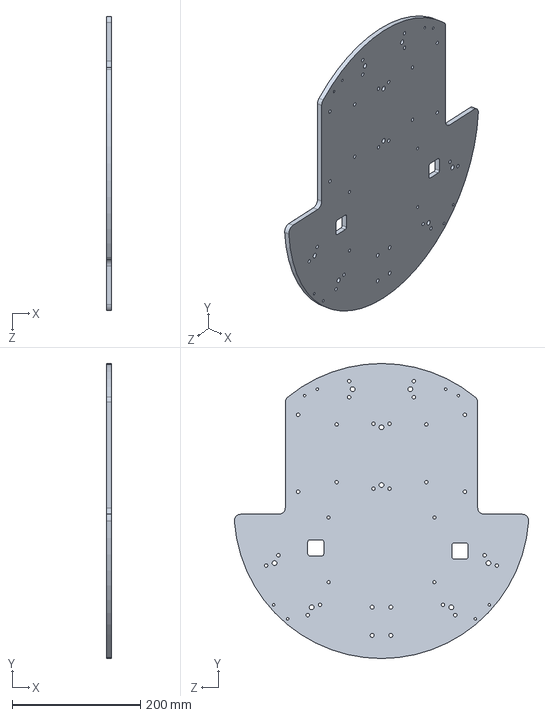
[picture p40: CAD file, 2026-06-11]
CAD/Retail-Cart-3D-Model/stp/人工智能小车底盘.SLDPRT
8.00 x 460.0 x 458.9 mm
