liaojingwu20041031/electric-power-inspection-robot/CAD/Retail-Cart-3D-Model/stp/语音播报模块固定盖.SLDPRT

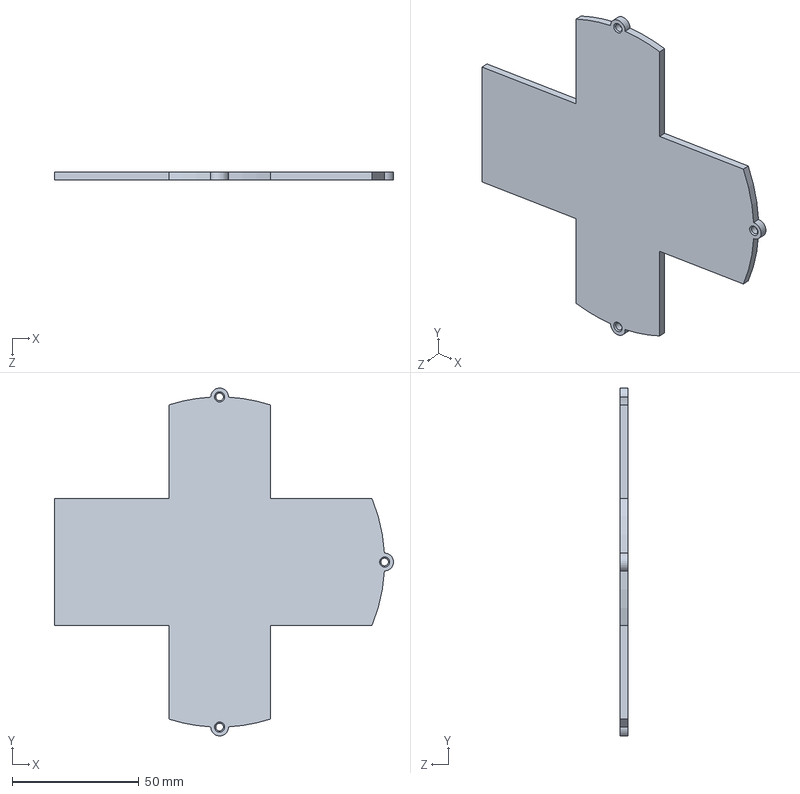
[picture p41: CAD file, 2026-06-11]
CAD/Retail-Cart-3D-Model/stp/语音播报模块固定盖.SLDPRT
133.5 x 136.9 x 3.00 mm
