liaojingwu20041031/electric-power-inspection-robot/CAD/Retail-Cart-3D-Model/stp/伸缩杆支架盖子.SLDPRT

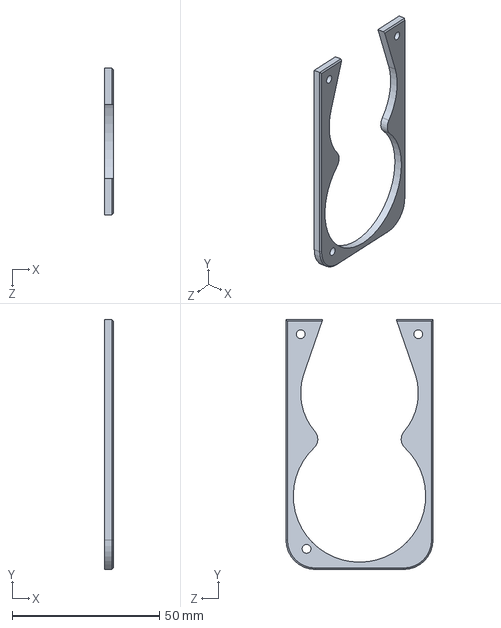
[picture p42: CAD file, 2026-06-11]
CAD/Retail-Cart-3D-Model/stp/伸缩杆支架盖子.SLDPRT
3.00 x 85.0 x 50.0 mm
