liaojingwu20041031/electric-power-inspection-robot/CAD/Retail-Cart-3D-Model/stp/前半圆固定架.SLDPRT

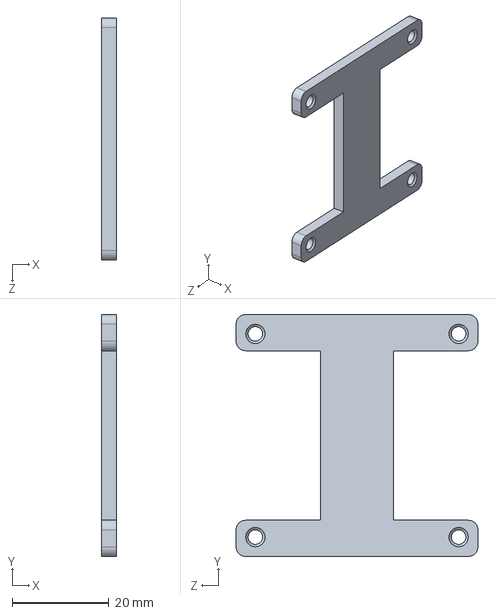
[picture p43: CAD file, 2026-06-11]
CAD/Retail-Cart-3D-Model/stp/前半圆固定架.SLDPRT
3.00 x 50.0 x 50.0 mm
