liaojingwu20041031/electric-power-inspection-robot/CAD/Retail-Cart-3D-Model/stp/伸缩杆固定底座.SLDPRT

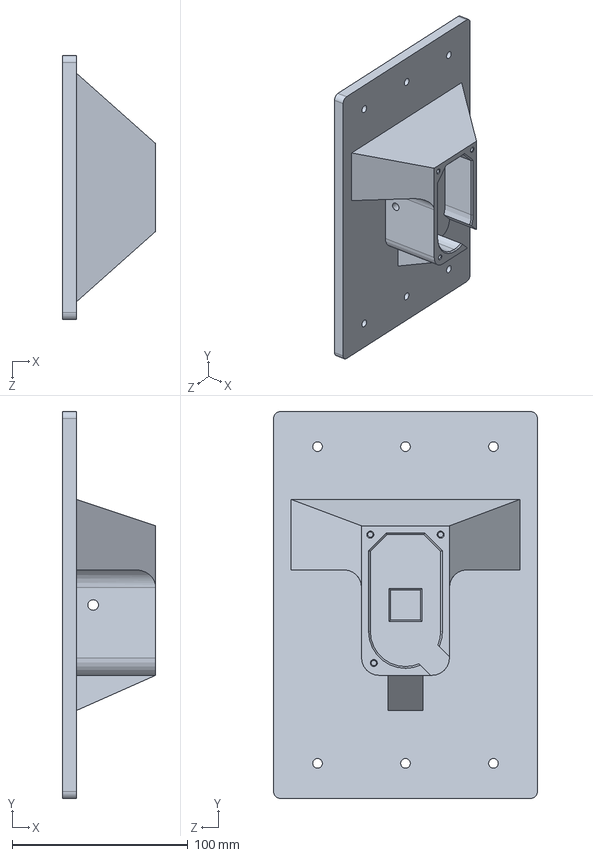
[picture p44: CAD file, 2026-06-11]
CAD/Retail-Cart-3D-Model/stp/伸缩杆固定底座.SLDPRT
53.0 x 220.0 x 150.0 mm
