liaojingwu20041031/electric-power-inspection-robot/CAD/Retail-Cart-3D-Model/stp/后半圆连接-固定件.SLDPRT

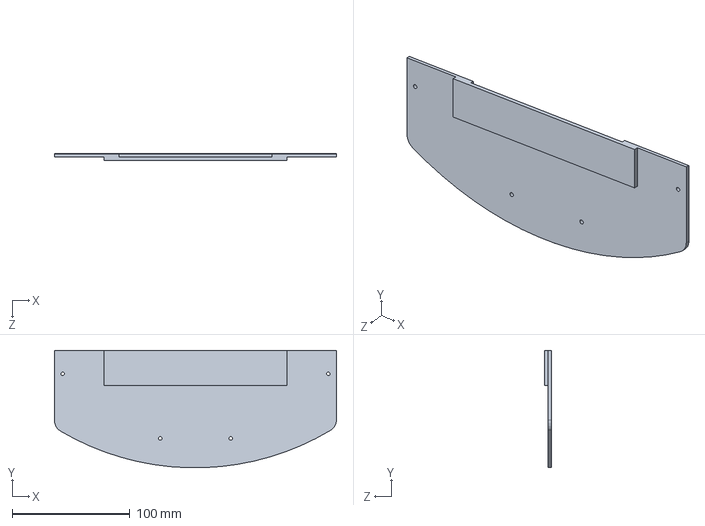
[picture p45: CAD file, 2026-06-11]
CAD/Retail-Cart-3D-Model/stp/后半圆连接-固定件.SLDPRT
240.0 x 99.9 x 6.00 mm
