liaojingwu20041031/electric-power-inspection-robot/CAD/Retail-Cart-3D-Model/stp/顶板.SLDPRT

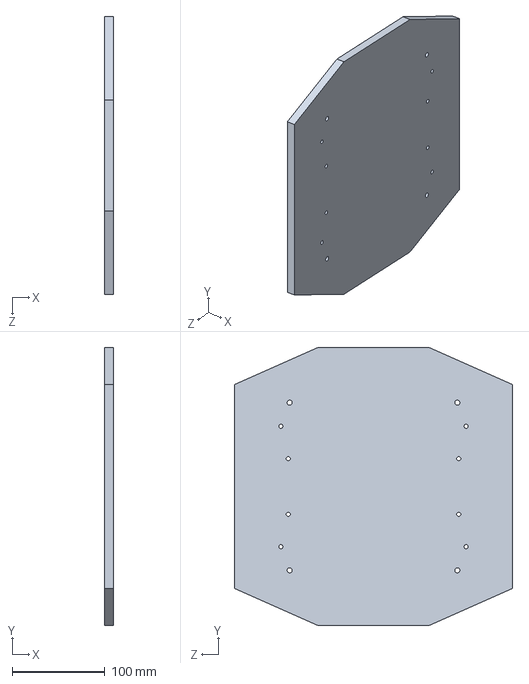
[picture p46: CAD file, 2026-06-11]
CAD/Retail-Cart-3D-Model/stp/顶板.SLDPRT
10.0 x 300.0 x 300.0 mm
