liaojingwu20041031/electric-power-inspection-robot/CAD/Retail-Cart-3D-Model/stp/螺母.SLDPRT

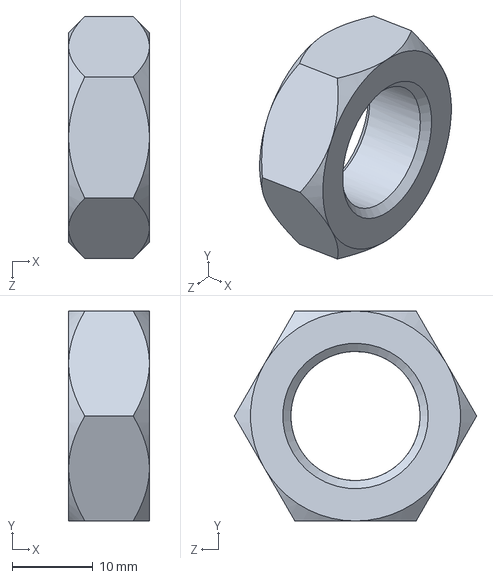
[picture p47: CAD file, 2026-06-11]
CAD/Retail-Cart-3D-Model/stp/螺母.SLDPRT
10.0 x 26.0 x 30.0 mm
