liaojingwu20041031/electric-power-inspection-robot/CAD/Retail-Cart-3D-Model/stp/双目垫板.SLDPRT

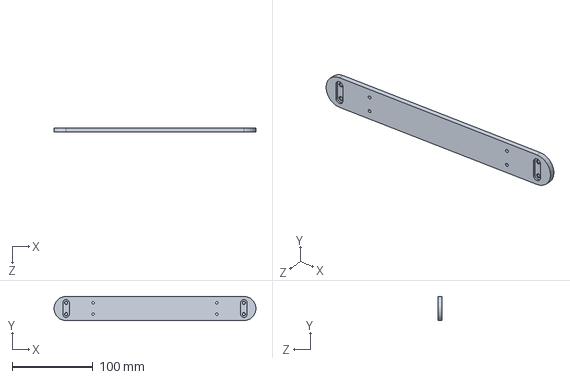
[picture p48: CAD file, 2026-06-11]
CAD/Retail-Cart-3D-Model/stp/双目垫板.SLDPRT
250.0 x 30.0 x 5.00 mm
