liaojingwu20041031/electric-power-inspection-robot/CAD/Retail-Cart-3D-Model/stp/盖板.SLDPRT

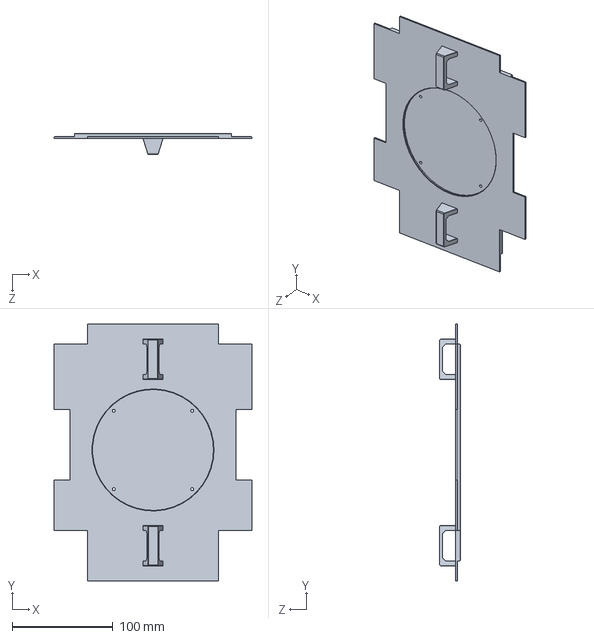
[picture p49: CAD file, 2026-06-11]
CAD/Retail-Cart-3D-Model/stp/盖板.SLDPRT
196.0 x 255.0 x 21.0 mm
