liaojingwu20041031/electric-power-inspection-robot/CAD/Retail-Cart-3D-Model/stp/固定盖.SLDPRT

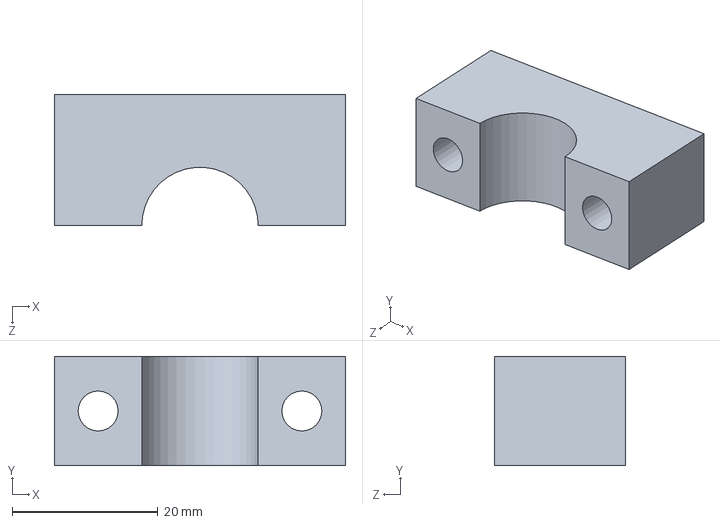
[picture p50: CAD file, 2026-06-11]
CAD/Retail-Cart-3D-Model/stp/固定盖.SLDPRT
40.0 x 15.0 x 18.0 mm
