liaojingwu20041031/electric-power-inspection-robot/(list of files, cad)

Other CAD files:
CAD/Retail-Cart-3D-Model/stp/上底盘.SLDPRT
CAD/Retail-Cart-3D-Model/stp/后半圆.SLDPRT
CAD/Retail-Cart-3D-Model/stl/伸缩杆固定底座.3MF
CAD/Retail-Cart-3D-Model/stl/伸缩杆支架盖子.3MF
CAD/Retail-Cart-3D-Model/stl/前半圆.3MF
CAD/Retail-Cart-3D-Model/stl/前半圆X.3MF
CAD/Retail-Cart-3D-Model/stl/前后半圆连接件.3MF
CAD/Retail-Cart-3D-Model/stl/双目垫板.3MF
CAD/Retail-Cart-3D-Model/stl/后半圆.3MF
CAD/Retail-Cart-3D-Model/stl/后半圆X.3MF
CAD/Retail-Cart-3D-Model/stl/后半圆固定架.3MF
CAD/Retail-Cart-3D-Model/stl/后半圆连接-固定件.3MF
CAD/Retail-Cart-3D-Model/stl/底盘连接处支架X.3MF
CAD/Retail-Cart-3D-Model/stl/支架垫片.3MF
CAD/Retail-Cart-3D-Model/stl/模块固定.3MF
CAD/Retail-Cart-3D-Model/stl/激光雷达固定架.3MF
CAD/Retail-Cart-3D-Model/stl/电池固定.3MF
CAD/Retail-Cart-3D-Model/stl/电池门.3MF
CAD/Retail-Cart-3D-Model/stl/盖板.3MF
CAD/Retail-Cart-3D-Model/stl/稳压板底座.3MF
CAD/Retail-Cart-3D-Model/stl/英伟达固定板X.3MF
CAD/Retail-Cart-3D-Model/stl/语音播报模块固定盖.3MF
CAD/Retail-Cart-3D-Model/stl/语音播报模块外挂支架.3MF
CAD/Retail-Cart-3D-Model/stl/连接-固定件.3MF
CAD/Retail-Cart-3D-Model/stp/万向轮.SLDPRT
