liaojingwu20041031/electric-power-inspection-robot/src/电力巡检机器人使用与调试手册.md

# 电力巡检机器人 ROS 2 项目使用与调试手册

平台规划：Jetson Orin Nano Super、Ubuntu 22.04、ROS 2 Humble
统一工作区：`~/ros2_DL`
当前定位：电力巡检机器人集成开发工作空间，覆盖底盘、雷达、IMU、WTRTK980 RTK/GNSS 数据接入、建图、导航、ZED 感知、语音/LLM 任务层、显示 UI 和 mobile bridge。

本文按实机调试顺序组织：先看系统能力边界，再按底层、控制、建图、导航、
巡逻、感知和任务层逐步联调。

> **安全提示**：`bringup`、`navigation`、巡逻和底盘控制命令可能使机器人运动。现场操作员应先确认场地、急停和设备状态；本文的静态检查、构建和协议说明不构成实机运动验收。

## 快速导航

| 你要完成的工作 | 推荐阅读 |
|---|---|
| 现场验收与排障 | [实机启动组合](#1-实机启动组合) → [硬件绑定与 CAN 检查](#7-硬件绑定与-can-检查) → [本地巡逻 Patrol 调试](#12-本地巡逻-patrol-调试) |
| 机器人功能开发 | [系统能力地图](#0-系统能力地图) → [ROS 包职责](#3-ros-包职责) → [数据流与修改入口](#4-数据流与修改入口) |
| 平台与移动端联调 | [AI 任务层与本体 UI 控制台](#14-ai-任务层与本体-ui-控制台) → [Mobile Bridge](#15-mobile-bridge) → [云平台连接运维](../docs/云平台连接运维.md) |

## 项目定位与交付

本项目面向电力实训和变电站巡检方向。导航巡逻已在 Jetson 实机形成稳定基线：普通路线、二值 Keepout 路线、自动 Profile 选择、路线安全检查、返航/循环和 UI 状态链路均已可用；检测服务、告警数据库和报告导出仍是独立的后续业务扩展。

当前交付：

- 仓库已迁移到 `liaojingwu20041031/electric-power-inspection-robot`。
- 文档入口已整理为中文命名，方便实训汇报和后续开发。
- LLM 层已从旧业务语义清理为巡检任务初始化框架。
- 默认任务话题切换为 `/inspection_ai/*`。
- 保留底盘、导航、感知、语音、移动端桥接等可复用 ROS 2 框架，并完成路线巡逻状态机与路线/地图安全边界。
- 新增 WTRTK980 RTK_4G 第一阶段数据接入，发布 `/gps/*` 话题用于验证和显示。
- 已实现巡逻启动、暂停、恢复、取消、检查点执行、返航与循环；未实现设备检测服务、告警数据库或巡检报告导出。
- Robot/Mobile Bridge 已具备公网 heartbeat、部署配置和平台协议文档；Spring Bridge 与 Web/小程序正式业务接线仍未完成。

### 技术栈概览

| 类型 | 技术/模块 |
|---|---|
| 系统 | Ubuntu 22.04、ROS 2 Humble |
| 计算平台 | Jetson Orin Nano Super，导航巡逻已完成实机验证 |
| 底盘 | ZLAC8015D V4、SocketCAN/CANopen |
| 导航 | RPLidar、IMU、WTRTK980 RTK 数据源、SLAM Toolbox、Nav2、AMCL、EKF |
| 感知 | ZED 2i、YOLO/TensorRT、OpenCV |
| LLM/语音 | DashScope/Qwen、ASR、TTS、语音路由 |
| UI/桥接 | PyQt5 QtQuick/QML 本体操控台、HTTP/WebSocket mobile bridge、Cloud heartbeat 基础设施 |
| 后续规划 | Spring Bridge、Web/小程序正式业务接线、LocateAnything-3B、LingBot-Map、巡检业务协议 |

### 初始化框架边界

当前提供可运行的机器人基础能力与导航巡逻闭环：

```text
底盘/传感器框架
  -> 建图与导航框架
  -> 感知输入框架
  -> LLM/语音/任务事件框架
  -> UI 与移动端巡逻状态刷新
  -> Robot/Mobile Bridge heartbeat 与平台协议基础设施
```

仍属于后续开发的正式电力巡检业务：

```text
站点/区域/路线/检查点建模
  -> 任务下发、暂停、恢复、取消、人工接管
  -> 路线级安全检测
  -> 检查点级设备检测
  -> 告警记录和巡检报告
  -> Spring Bridge 与 Web/小程序正式业务接线
```

### 后续扩展方向

- Nav2 升级后重新执行 normal/keepout 两条短距离现场验收；底盘、RTK、ZED 和语音链路按各自变更单独复验。
- 设计正式 `/inspection/*` 任务协议和巡检消息。
- 扩展站点、区域和检查点业务配置（路线 JSON 已支持相关透传字段）。
- 接入人员、安全帽、火源、烟雾、障碍物等路线级检测。
- 评估 LocateAnything-3B 用于开关状态、漏油、异物等检查点级定位。
- 评估 LingBot-Map 用于三维空间重建、巡检点位对齐和后台展示。

### 文档入口

- [项目展示封面](../README.md)
- [Robot Platform Protocol v1](../docs/protocol/robot-platform-v1.md)
- [Jetson 云平台连接运维](../docs/云平台连接运维.md)
- [本体 QML 操控台与生命周期](../docs/本体QML操控台.md)

## 0. 系统能力地图

当前系统按运行职责分为六层。阅读和排障时先确认自己正在处理哪一层，不要把
ROS 包名、launch 模式和业务功能混在一起看。

| 层级 | 当前能力 | 主要运行入口 | 关键输出 |
|---|---|---|---|
| 硬件与底盘 | USB 设备绑定、PCAN/SocketCAN、ZLAC8015D 或 STM32 底盘、IMU、RPLidar、WTRTK980 RTK、URDF、EKF | `./scripts/run_on_jetson.sh bringup` | `/odom`、`/scan`、`/imu/data`、`/gps/*`、TF、`/cmd_vel` 执行 |
| 建图定位 | SLAM Toolbox 建图、地图保存、AMCL 定位、Scan-to-Map 修正 | `mapping`、`navigation`、`scan_map_relocalization_node` | `/map`、`map -> odom`、`/initialpose` 修正 |
| 导航与巡逻 | Nav2 单点导航、本地路线巡逻、到点任务触发、返航、暂停/恢复/取消 | `navigation`、`patrol_executor.launch.py` | Nav2 action、`/patrol/status`、`/patrol/event` |
| 视觉感知 | ZED 2i 图像/深度、YOLO/TensorRT 检测、目标空间定位 | `zed`、`perception` | `/perception/detections`、`/perception/localized_objects` |
| 三维建模 | ZED SVO 现场采集，离线重建 PLY 点云；不作为 Nav2 地图 | `zed_3d_capture`、`zed_3d_reconstruct` | `runs/3d_capture/capture_*`、`runs/3d_reconstruct/reconstruct_*` |
| 任务与交互 | 文本/语音命令、任务事件、TTS、中文 QML 本体操控台、系统进程 supervisor | `llm`、`inspection` | `/inspection_ai/*`、短时 `/cmd_vel`、UI |
| 外部调试接口 | HTTP/WebSocket 调试、移动端状态查询、低速控制、系统启动/停止入口 | `mobile_bridge.launch.py` | Web API、WebSocket、ROS 话题转发 |

当前仓库已经包含机器人底层、导航、感知和交互框架；完整巡检业务闭环、检测服务 API、告警数据库、报告导出、LocateAnything-3B 推理和 LingBot-Map 实际接入仍属于后续扩展。

## 1. 实机启动组合

根目录脚本是实机使用入口。`scripts/run_on_jetson.sh` 会自动进入工作空间、
source ROS 环境和 install 环境，并把常用运行模式统一成固定命令。

| 要做什么 | 必须先启动 | 再启动 | 备注 |
|---|---|---|---|
| 台架底盘/传感器验收 | 无 | `bringup` | 先确认 CAN、IMU、雷达、TF 和 `/odom` |
| 手动遥控 | `bringup` | `teleop` | 低速确认方向、轮速、里程计和急停习惯 |
| 在线建图 | `bringup` | `mapping` | `mapping.launch.py` 不启动底盘、雷达或 EKF |
| 单点导航 | `bringup` | `navigation` | 启动后先发布 `map` frame 的 `/initialpose` |
| 本地巡逻 | `bringup`、`navigation` | `patrol_executor.launch.py` | 默认 `auto_start:=false`，先定位再发送 `start` |
| 视觉检测 | `zed` | `perception` | ZED wrapper 和 TensorRT 检测分开启动 |
| 三维建模 | 无；但不能同时运行 `zed`/ZED wrapper | `zed_3d_capture` 后 `zed_3d_reconstruct` | 输出 SVO/PLY，不写 `map.yaml/pgm` |
| 任务/语音/UI | 视任务需要启动底层或导航 | `inspection` 或 `llm` | `inspection` 是带 UI、语音和 supervisor 的组合模式 |
| 移动端调试 | 视接口需要启动底层或导航 | `mobile_bridge.launch.py` | 只做外部协议到 ROS 的转换 |

常用顺序：

```text
bringup -> teleop 验收
bringup -> mapping -> 保存地图
bringup -> navigation -> initialpose -> 单点导航
bringup -> navigation -> patrol_executor -> /patrol/command start
zed -> perception -> inspection
zed_3d_capture -> zed_3d_reconstruct
```

## 2. 项目结构总览

仓库按 ROS 2 工作空间组织。根目录负责部署、地图、文档和硬件资料；`src/` 下放 ROS 2 包和第三方驱动。

```text
~/ros2_DL
├── scripts/                  # Jetson 安装、构建、启动、CAN 和 PCAN 诊断脚本
├── maps/                     # 默认地图 my_map.yaml / my_map.pgm
├── CAD/                      # 底盘、支架、结构件 CAD/STL/3MF 文件
├── 官方通信协议/              # ZLAC8015D V4 官方手册和 CANopen/RS485 示例
└── src/
    ├── ylhb_base/            # 底盘、URDF、EKF、SLAM、Nav2、重定位
    ├── ylhb_interfaces/      # 巡检任务、状态和语音消息定义
    ├── ylhb_llm/             # 任务层、语音、显示 UI、系统 supervisor
    ├── ylhb_perception/      # ZED 图像、YOLO/TensorRT、深度定位
    ├── ylhb_3d_mapping/      # ZED SDK 三维点云/网格导出
    ├── ylhb_mobile_bridge/   # HTTP/WebSocket 与 ROS 2 桥接
    ├── hipnuc_imu/           # N300WP PRO/HiPNUC IMU 串口驱动
    ├── rplidar_ros-ros2/     # RPLidar ROS 2 驱动
    └── zed-ros2-wrapper/     # ZED 2i 官方 ROS 2 wrapper
```

容易混淆的边界：

- `scripts/` 是现场启动和诊断入口，不是 ROS 包。
- `maps/` 存放运行时地图和路线，`maps/my_map.*` 给 Nav2 使用，
  `maps/route_patrol_*.json` 给本地巡逻执行器使用。
- `ylhb_mobile_bridge` 同时包含 HTTP/WebSocket bridge 和本地巡逻执行器。
  前者服务手机/Web 调试，后者直接调用 Nav2；两者共享包但职责不同。
- `ylhb_llm` 是任务/语音/UI 层，不是底盘控制器。动态 Agent 只能调用
  高层工具：路线工具、基础运动技能、状态查询和系统命令；不能直接调用
  `/cmd_vel`、Nav2 goal、删图或改路线。本体 QML UI 只通过
  `/inspection_ai/system_command` 请求 supervisor 管理进程。

## 3. ROS 包职责

| ROS 包 | 运行类型 | 主要职责 | 不负责 |
|---|---|---|---|
| `ylhb_base` | C++/Python 节点、launch、配置 | 底盘后端、URDF/TF、EKF、RTK NMEA、SLAM、AMCL、Nav2、重定位辅助 | 业务巡检流程、语音/UI、Web API |
| `hipnuc_imu` | 传感器驱动包 | HiPNUC IMU 串口数据解析与发布 | EKF 参数、底盘控制 |
| `rplidar_ros-ros2` | 第三方雷达驱动 | Slamtec RPLidar `/scan` 发布 | 地图、导航策略 |
| `zed-ros2-wrapper` | 第三方相机 wrapper | ZED 2i 图像、深度、相机信息 | YOLO 业务检测 |
| `ylhb_perception` | 感知节点、launch、模型配置 | YOLO/TensorRT 检测、深度融合、目标定位输出 | 导航控制、任务调度 |
| `ylhb_3d_mapping` | Python 节点、launch、配置 | ZED SDK Spatial Mapping 点云/网格采集与导出 | Nav2 地图、底盘控制、YOLO 检测 |
| `ylhb_interfaces` | 消息定义 | 任务事件、任务状态、语音输出状态等自定义消息 | 运行节点 |
| `ylhb_llm` | Python 任务/语音/UI 节点 | 文本任务解析、语音输入输出、显示 UI、system supervisor、短时基础运动命令 | 底盘闭环、Nav2 算法、本地路线巡逻状态机 |
| `ylhb_mobile_bridge` | Python bridge 与巡逻执行器 | HTTP/WebSocket 调试入口、本地 Nav2 巡逻执行器、路线文件校验 | 感知算法、底盘驱动、Nav2 配置调优 |

常见 launch 与节点归属：

| 入口 | 来自 | 启动内容 |
|---|---|---|
| `ylhb_base bringup.launch.py` | `ylhb_base` | 底盘后端、IMU、RPLidar、可选 WTRTK980 RTK、robot_state_publisher、EKF |
| `ylhb_base mapping.launch.py` | `ylhb_base` | SLAM Toolbox 建图 |
| `ylhb_base navigation.launch.py` | `ylhb_base` | Nav2、map_server、AMCL |
| `ylhb_mobile_bridge patrol_executor.launch.py` | `ylhb_mobile_bridge` | 本地路线巡逻执行器 |
| `ylhb_mobile_bridge mobile_bridge.launch.py` | `ylhb_mobile_bridge` | HTTP/WebSocket mobile bridge |
| `ylhb_perception perception.launch.py` | `ylhb_perception` | YOLO 检测与深度目标定位 |
| `ylhb_3d_mapping zed_spatial_mapping.launch.py` | `ylhb_3d_mapping` | ZED SDK 三维点云/网格导出节点 |
| `ylhb_llm llm.launch.py` | `ylhb_llm` | 任务、语音、UI、system supervisor 的可选组合 |

## 4. 数据流与修改入口

### 4.1 底盘闭环

```text
Nav2 / teleop / UI / mobile bridge / patrol_executor
  -> /cmd_vel
  -> zlac8015d_canopen_controller 或 base_controller
  -> /odom
  -> robot_localization EKF
  -> odom -> base_footprint TF
  -> Nav2 controller / planner
```

`ylhb_base` 中两个底盘后端互斥启动：默认是 `zlac8015d_canopen_controller`，通过 SocketCAN `can1` 控制 ZLAC8015D；`base_controller` 是 STM32 串口回退方案。两者都不发布底盘 TF，`odom -> base_footprint` 统一交给 EKF，避免 TF 冲突。

### 4.2 建图链路

```text
/scan + /odom + TF
  -> slam_toolbox async_slam_toolbox_node
  -> /map
  -> nav2_map_server map_saver_cli
  -> maps/my_map.yaml + maps/my_map.pgm
```

建图必须先启动底层 bringup，因为 `mapping.launch.py` 只启动 `slam_toolbox`，不启动雷达、底盘或 EKF。保存地图时统一写入 `~/ros2_DL/maps/`，避免旧版本把地图散落到 `src/`。

### 4.3 定位与单点导航链路

```text
maps/my_map.yaml + /scan + /odom + TF
  -> Nav2 map_server + AMCL
  -> planner_server / controller_server
  -> /cmd_vel
  -> 底盘控制器
```

`navigation.launch.py` 只启动 Nav2，不启动 bringup。AMCL 不强制使用建图原点，现场需要先发布 `map` frame 的 `/initialpose`。`scan_map_relocalization_node` 在粗位姿附近做二维激光到地图匹配，质量达标后再发布修正位姿；`amcl_swing_relocalization_node` 只做小幅原地摆头帮助 AMCL 收敛。

### 4.4 巡逻执行链路

```text
平台 START (LOCAL_CONFIRM)
  -> mobile_bridge 校验部署、地图和路线
  -> SQLite 持久化为 ARMED
  -> 本体 UI 确认启动平台巡检
  -> /mobile_bridge/confirm_platform_start
  -> 复用云命令队列和 system_supervisor_node
  -> system_supervisor_node 启动/复用 bringup + navigation + patrol_executor
  -> /patrol/command start，可带 route_id
  -> 平台部署路线 route.json
  -> patrol_executor_node
  -> Nav2 NavigateToPose action
  -> /patrol/status + /patrol/event
  -> 到点后 /inspection_ai/text_command
```

本地巡逻执行器属于 `ylhb_mobile_bridge` 包，但它不是 Web bridge。
它读取地图坐标路线文件，按目标点顺序调用 Nav2，处理暂停、恢复、取消、返航、
循环和失败策略。它不修改 Nav2 配置、不清 costmap、不接管底盘驱动。
正式本体 UI 不再提供“本地一键巡逻”入口，也不调用
`UiBackend.startPatrolMode()`。生产入口只确认平台下发且已进入 `ARMED`
的任务，QML 不提交或修改 execution、deployment 和 command 身份。
`start_patrol_mode` 底层能力仍保留，仅供内部调试和 Agent 受控调用。
动态 Agent 的 `start_route(route_id)` 也走这条链路；未带 `route_id` 时，
巡逻执行器继续使用路线文件中的 `active_route_id`。`go_to_checkpoint(target_id)`
直接发布高层 `/patrol/command go_to_target`，由巡逻执行器从路线文件查找目标
位姿并构造单点临时路线，仍然不直接发 Nav2 goal。

### 4.5 视觉感知链路

```text
ZED 2i RGB 图像
  -> yolo_detector_node
  -> /perception/detections
  -> object_localizer_node + ZED 深度/内参
  -> /perception/target_pose
  -> /perception/localized_objects
```

`ylhb_perception` 默认使用 Jetson 上编译好的 TensorRT engine：`src/ylhb_perception/models/yolo26.engine`。C++ TensorRT 节点负责实时检测，Python `object_localizer_node.py` 根据深度图和相机内参估算目标 3D 坐标。调试图默认关闭，避免 DDS 图像链路拖慢推理。

### 4.6 任务、语音与 UI 链路

```text
文字 / 语音 / UI / mobile bridge
  -> /inspection_ai/text_command 或 /inspection_ai/system_command
  -> inspection_task_node / inspection_agent_node / system_supervisor_node
  -> /inspection_ai/task_event、/inspection_ai/say_text、高层工具命令或系统进程动作
```

`ylhb_llm` 不是底盘控制器本体，而是上层任务编排和交互层。旧的
`basic_motion_command_node` 继续保留给 UI/语音枚举短指令，把“前进、后退、
左转、右转、停止”等命令转换为限时 `/cmd_vel`；动态 Agent 不走这个底层
接口，而是通过 `robot_capabilities.yaml` 暴露的 `rotate_relative`、
`move_relative`、`stop_motion` 等基础运动技能发布
`/inspection_ai/base_skill_command`，由 `base_motion_skill_node` 在
`odom -> base_footprint` TF 可用时按相对位姿差闭环停车，TF 不可用时按超时
保守停车。`inspection_task_node` 把巡检文本解析成
`TaskEvent`；`system_supervisor_node` 负责启动/停止底层、建图、导航、感知和
mobile bridge 等系统进程；`inspection_display_ui_node` 提供本机中文 QML 操控台。

### 4.7 修改功能时看哪里

| 修改目标 | 优先查看 | 注意事项 |
|---|---|---|
| CAN 接口、轮径、轮距、速度限幅 | `src/ylhb_base/config/zlac8015d.yaml`、`base_kinematics.yaml` | 修改后先台架低速验收 `/cmd_vel`、`/odom`、方向 |
| 机器人外形、TF、雷达/IMU 安装位 | `src/ylhb_base/urdf/ylhb.urdf.xacro` | 改 URDF 后运行 `xacro`、`check_urdf` 和几何测试 |
| EKF 融合和 TF 发布 | `src/ylhb_base/config/ekf.yaml` | 保持 EKF 独占 `odom -> base_footprint` |
| SLAM 参数 | `src/ylhb_base/config/slam_toolbox_params.yaml` | 先确认 `/scan`、`/odom`、TF 正常再调参数 |
| Nav2 行为和 footprint | `src/ylhb_base/config/nav2_params.yaml` | 改 footprint、速度或恢复行为后运行导航配置测试 |
| RTK 数据接入 | `src/ylhb_base/src/wtrtk980_nmea_node.cpp`、`src/ylhb_base/include/ylhb_base/wtrtk980_nmea.hpp`、`src/bind_usb.sh` | 当前只发布 `/gps/*`，不改 AMCL/Nav2 融合 |
| 本地巡逻路线 | `maps/route_patrol_*.json` | 坐标必须是 `map` frame，`start_pose` 应是机器人真实起点 |
| 本地巡逻状态机 | `src/ylhb_mobile_bridge/ylhb_mobile_bridge/patrol_executor_node.py`、`patrol_route_store.py` | 改后运行 patrol executor 逻辑测试 |
| 巡逻启动编排 | `src/ylhb_llm/ylhb_llm/system_supervisor_node.py`、`src/ylhb_llm/ylhb_llm/ui_backend.py`、`src/ylhb_llm/qml/pages/PatrolPage.qml` | UI start 必须走 `/inspection_ai/system_command`，不要绕过 supervisor |
| 语音、UI、任务话题 | `src/ylhb_llm/config/llm.yaml` | `/inspection_ai/*` 是任务层主命名空间 |
| 感知模型和检测阈值 | `src/ylhb_perception/config/detector.yaml` | TensorRT engine 输入尺寸需与 `imgsz` 一致 |
| 手机/Web 调试入口 | `src/ylhb_mobile_bridge/config/mobile_bridge.yaml` | bridge 只做外部协议到 ROS 的转换 |
| 本体 QML 操控台 | `src/ylhb_llm/ylhb_llm/ui_backend.py`、`ui_ros_bridge.py`、`src/ylhb_llm/qml/` | UI 只发布 ROS 命令，不直接调用 mobile bridge HTTP API |
| 测试与回归 | `src/ylhb_base/test/`、`src/ylhb_mobile_bridge/test/`、`src/ylhb_llm/test/` | 配置或行为变更应同步更新对应测试 |

## 5. 工作空间规范

推荐工作空间固定为：

```bash
cd ~
git clone https://github.com/liaojingwu20041031/electric-power-inspection-robot.git ros2_DL
cd ~/ros2_DL
```

ROS 包应直接位于：

```text
~/ros2_DL/src/ylhb_base
~/ros2_DL/src/ylhb_interfaces
~/ros2_DL/src/ylhb_llm
~/ros2_DL/src/ylhb_mobile_bridge
~/ros2_DL/src/ylhb_perception
~/ros2_DL/src/ylhb_3d_mapping
~/ros2_DL/src/hipnuc_imu
~/ros2_DL/src/rplidar_ros-ros2
~/ros2_DL/src/zed-ros2-wrapper
```

如果临时放在其他目录，先设置：

```bash
export WS_DIR=/path/to/ros2_DL
```

后续地图统一保存到：

```text
~/ros2_DL/maps/my_map.yaml
~/ros2_DL/maps/my_map.pgm
```

`~/ros2_DL/src/my_map.yaml` 仅作为旧版本兼容地图，不作为推荐路径。

## 6. 依赖安装与编译

开发板首次部署：

```bash
cd ~/ros2_DL
source /opt/ros/humble/setup.bash
./scripts/install_jetson_dependencies.sh
colcon build --symlink-install
source ~/ros2_DL/install/setup.bash
```

日常重新编译：

```bash
cd ~/ros2_DL
source /opt/ros/humble/setup.bash
colcon build --symlink-install
source install/setup.bash
```

只编译自研包可用于快速检查：

```bash
colcon build --symlink-install \
  --packages-select ylhb_interfaces ylhb_base ylhb_llm ylhb_perception ylhb_mobile_bridge ylhb_3d_mapping
```

当前工作空间包含 12 个 ROS 2 包：8 个本项目/驱动包和 4 个 ZED wrapper 子包。`colcon test` 中 ZED 第三方包可能触发上游 lint/copyright 问题，且受限网络下 `xmllint` 可能无法下载 ROS schema；自研包问题应优先用 `--packages-select ylhb_base ylhb_llm ylhb_perception ylhb_mobile_bridge ylhb_interfaces ylhb_3d_mapping` 单独验证。

## 7. 硬件绑定与 CAN 检查

Jetson 实机建议先执行一次 USB/CAN 绑定：

```bash
cd ~/ros2_DL
sudo ./src/bind_usb.sh
```

目标设备约定：

```text
/dev/robot_lidar -> RPLidar A2M8，CP210x，10c4:ea60
/dev/robot_imu   -> N300WP PRO / HiPNUC IMU，CH9102，1a86:55d4
/dev/rtk_4g      -> WTRTK980 RTK_4G，BYD/AirM2M 19d1:0001，interface 06
can1             -> PEAK PCAN-USB，0c72:000c，500000 bit/s
```

验收命令：

```bash
systemctl status robot-hardware-guard.service --no-pager
tail -n 120 /var/log/robot-hardware-guard.log
lsusb
ls -l /dev/robot_lidar /dev/robot_imu /dev/rtk_4g /dev/ttyUSB* /dev/ttyACM* /dev/ttyCH343USB*
ip -details link show can1
```

如果只想手动配置 CAN：

```bash
cd ~/ros2_DL
./scripts/setup_zlac_can.sh can1 500000
ip -br link show can1
candump -tz can1
```

只有 `can1` 存在且 `candump -tz can1` 能看到或至少不报接口错误时，再继续底盘 bringup。

## 8. 底层 Bringup

终端 1 启动底层系统：

```bash
cd ~/ros2_DL
source /opt/ros/humble/setup.bash
source install/setup.bash
ros2 launch ylhb_base bringup.launch.py
```

等价脚本：

```bash
./scripts/run_on_jetson.sh bringup
```

默认底盘后端是 ZLAC8015D SocketCAN：

```bash
ros2 launch ylhb_base bringup.launch.py base_backend:=zlac
```

无 USB-CAN 或需要旧底盘板时使用 STM32 串口回退：

```bash
ros2 launch ylhb_base bringup.launch.py base_backend:=stm32 base_port:=/dev/ttyS1
```

台架调试时可临时关闭 IMU，但实机建图和导航不推荐：

```bash
ros2 launch ylhb_base bringup.launch.py enable_imu:=false
```

RTK 默认关闭，避免影响非 RTK 场景。需要验证 WTRTK980 时显式打开：

```bash
ros2 launch ylhb_base bringup.launch.py enable_rtk:=true
```

相关启动参数：

```text
enable_rtk:=false
rtk_port:=/dev/rtk_4g
rtk_baud:=115200
rtk_frame_id:=gps_link
```

Bringup 会启动：

```text
zlac8015d_canopen_controller 或 base_controller
imu_driver
rplidar_node
robot_state_publisher
ekf_filter_node
wtrtk980_nmea_node（enable_rtk:=true 时）
```

底层验收：

```bash
ros2 node list
ros2 topic echo /odom --once
ros2 topic echo /imu/data --once
ros2 topic echo /scan --once
ros2 topic echo /zlac8015d/status --once
ros2 topic echo /zlac8015d/fault --once
ros2 topic hz /scan
ros2 run tf2_tools view_frames
```

RPLidar A2M8 默认 `115200` 波特率，frame 为 `laser_link`。如果 `/dev/robot_lidar` 不存在，launch 会尝试按 USB ID 查找 CP2102 `/dev/ttyUSB*`；长期修复仍应使用 `sudo ./src/bind_usb.sh`。

IMU 默认 `/dev/robot_imu`、`115200` 波特率。N300WP PRO 枚举但没有串口时，先检查：

```bash
lsusb | grep -i '1a86:55d4'
systemctl status ModemManager --no-pager
sudo ./src/bind_usb.sh
ls -l /dev/robot_imu /dev/ttyACM* /dev/ttyCH343USB* /dev/ttyUSB*
```

### 8.1 WTRTK980 RTK 验证

RTK_4G 板会枚举多个 `/dev/ttyACM*`，当前 NMEA GGA 数据接口为 USB
`bInterfaceNumber=06`。`sudo ./src/bind_usb.sh` 会创建稳定别名
`/dev/rtk_4g`，实测指向 `/dev/ttyACM4`。

快速冒烟测试：

```bash
cd ~/ros2_DL
./scripts/rtk_smoke_test.sh
```

手动验证：

```bash
cd ~/ros2_DL
source /opt/ros/humble/setup.bash
source install/setup.bash

ros2 launch ylhb_base bringup.launch.py enable_rtk:=true
```

另开终端：

```bash
source /opt/ros/humble/setup.bash
source ~/ros2_DL/install/setup.bash
ros2 topic echo /gps/fix --once
ros2 topic echo /gps/nmea_sentence --once
ros2 topic echo /gps/rtk_status --once
```

RTK 节点公开接口：

| 话题 | 类型 | 含义 |
|---|---|---|
| `/gps/fix` | `sensor_msgs/NavSatFix` | GGA 经纬度、高程和定位状态 |
| `/gps/nmea_sentence` | `nmea_msgs/Sentence` | 通过校验和验证的原始 GGA 语句 |
| `/gps/rtk_status` | `diagnostic_msgs/DiagnosticArray` | RTK 质量、卫星数、HDOP、差分龄期和基站 ID |

`/gps/rtk_status` 中的 GGA quality 含义：

```text
0：无定位
1：单点定位
2：DGPS
4：RTK fixed
5：RTK float
```

如果看到 `quality=0`、`satellites=0`、`latitude=.nan`，说明串口和 ROS
链路已打通，但当前没有有效 GNSS 定位。应把天线放到室外开阔处，并确认 4G
差分服务在线。第一阶段 RTK 只做数据验证和状态显示，不修改 AMCL、Nav2、
`map -> odom`、巡逻路线 JSON 或巡逻执行器行为。

## 9. 底盘控制

底层 bringup 正常后，在终端 2 做键盘控制：

```bash
cd ~/ros2_DL
source /opt/ros/humble/setup.bash
source install/setup.bash
ros2 run teleop_twist_keyboard teleop_twist_keyboard
```

等价脚本：

```bash
./scripts/run_on_jetson.sh teleop
```

### 9.1 键盘速度参数调节

`teleop_twist_keyboard` 发布 `/cmd_vel` 时，`speed` 控制线速度 `linear.x`，单位 `m/s`；`turn` 控制角速度 `angular.z`，单位 `rad/s`。可以启动时直接指定：

```bash
ros2 run teleop_twist_keyboard teleop_twist_keyboard \
  --ros-args -p speed:=0.10 -p turn:=0.30
```

使用脚本时，把参数接在 `teleop` 后面：

```bash
./scripts/run_on_jetson.sh teleop --ros-args -p speed:=0.10 -p turn:=0.30
```

键盘控制运行后也可以临时调节当前速度：

```text
q / z：线速度和角速度同时增加 / 减小 10%
w / x：只增加 / 减小线速度 speed
e / c：只增加 / 减小角速度 turn
k 或其他非运动按键：停止
```

屏幕上的 `currently: speed ... turn ...` 会显示当前线速度和角速度。建议实机先用 `speed:=0.10`、`turn:=0.30` 低速测试，再逐步增加。

注意：键盘发布的速度仍受底盘最终限幅限制。实机底盘限幅在 `src/ylhb_base/config/base_kinematics.yaml`：

```yaml
zlac8015d_canopen_controller:
  ros__parameters:
    # 最大线速度，单位 m/s。调大前先确认场地、电机和急停安全。
    max_linear_speed: 0.35
    # 最大角速度，单位 rad/s。数值越大，原地转向越快。
    max_angular_speed: 0.55
```

这两个参数会限制 `/cmd_vel` 输入，超过后由底盘控制器自动限幅。修改后重新启动 bringup 生效：

```bash
ros2 launch ylhb_base bringup.launch.py
```

如果调的是 Nav2 自动导航速度，而不是键盘控制速度，还需要同步修改 `src/ylhb_base/config/nav2_params.yaml`：

```yaml
controller_server:
  ros__parameters:
    FollowPath:
      # Nav2 输出线速度上限，单位 m/s。
      max_vel_x: 0.15
      max_speed_xy: 0.15
      # Nav2 输出角速度上限，单位 rad/s。
      max_vel_theta: 0.35

velocity_smoother:
  ros__parameters:
    # 平滑器最终输出上限：[x, y, theta]。
    max_velocity: [0.15, 0.0, 0.35]
    min_velocity: [-0.05, 0.0, -0.35]
```

建议先小幅调节：线速度每次增加 `0.05 m/s`，角速度每次增加 `0.05 rad/s` 到 `0.10 rad/s`。Nav2 的 `max_vel_x`、`max_speed_xy`、`velocity_smoother.max_velocity[0]` 应保持一致；`max_vel_theta` 与 `velocity_smoother.max_velocity[2]` 应保持一致。

也可以直接发布速度指令：

```bash
# 前进 0.10 m/s，持续发布时机器人会运动
ros2 topic pub /cmd_vel geometry_msgs/msg/Twist \
  "{linear: {x: 0.10}, angular: {z: 0.0}}"

# 停车
ros2 topic pub --once /cmd_vel geometry_msgs/msg/Twist \
  "{linear: {x: 0.0}, angular: {z: 0.0}}"
```

检查订阅链路：

```bash
ros2 topic info /cmd_vel -v
ros2 topic echo /odom
ros2 topic echo /zlac8015d/status
```

方向验收：

```text
linear.x > 0：机器人应向前。
angular.z > 0：机器人应按 ROS 约定左转。
/odom 中 x、yaw 应与实际运动方向一致。
松开键盘或停止发布后，cmd_vel 超时保护应停车。
```

语音/文字基础动作入口由 `basic_motion_command_node` 处理：

```bash
ros2 launch ylhb_llm llm.launch.py enable_voice:=false enable_tts:=false enable_display_ui:=false
ros2 topic pub --once /inspection_ai/text_command std_msgs/msg/String "{data: '前进'}"
ros2 topic pub --once /inspection_ai/text_command std_msgs/msg/String "{data: '停止'}"
```

默认要求底盘状态在线；如果只是离线调试任务层，需要在配置里临时关闭 `require_chassis_online`，不要在实机运行时关闭安全检查。

## 10. 建图 Mapping

建图需要先保持终端 1 的 bringup 运行，再开终端 2：

```bash
cd ~/ros2_DL
source /opt/ros/humble/setup.bash
source install/setup.bash
ros2 launch ylhb_base mapping.launch.py
```

等价脚本：

```bash
./scripts/run_on_jetson.sh mapping
```

终端 3 用键盘慢速遥控机器人覆盖场地：

```bash
ros2 run teleop_twist_keyboard teleop_twist_keyboard
```

建图过程检查：

```bash
ros2 node list | grep slam
ros2 topic echo /map --once --field info
ros2 topic hz /scan
ros2 topic echo /odom --once
```

保存地图到推荐路径：

```bash
mkdir -p ~/ros2_DL/maps
ros2 run nav2_map_server map_saver_cli -f ~/ros2_DL/maps/my_map \
  --ros-args -p save_map_timeout:=10.0
```

保存后检查：

```bash
ls -lh ~/ros2_DL/maps/my_map.yaml ~/ros2_DL/maps/my_map.pgm
```

地图保存失败时优先检查 `/map` 是否存在、`slam_toolbox` 是否运行，以及当前终端是否已 source 工作空间环境。

## 11. 导航 Navigation

导航需要已有地图，并且必须先启动底层 bringup。`navigation.launch.py` 只启动
Nav2，不启动雷达、底盘、IMU 或 EKF。推荐终端顺序：

```bash
# 终端 1：底层
cd ~/ros2_DL
source /opt/ros/humble/setup.bash
source install/setup.bash
ros2 launch ylhb_base bringup.launch.py

# 终端 2：导航
cd ~/ros2_DL
source /opt/ros/humble/setup.bash
source install/setup.bash
ros2 launch ylhb_base navigation.launch.py map:=$HOME/ros2_DL/maps/my_map.yaml

# 终端 3：等待人工粗定位并做局部 Scan-to-Map 修正
cd ~/ros2_DL
source /opt/ros/humble/setup.bash
source install/setup.bash
ros2 run ylhb_base scan_map_relocalization_node
```

等价脚本：

```bash
./scripts/run_on_jetson.sh navigation map:=$HOME/ros2_DL/maps/my_map.yaml
```

`navigation.launch.py` 默认优先读取 `~/ros2_DL/maps/my_map.yaml`；如果缺失，会回退到旧兼容路径 `~/ros2_DL/src/my_map.yaml` 并打印 warning。

先启动 Scan-to-Map 节点，再从 RViz/Foxglove 发布 2D Pose Estimate。因为
`/initialpose` 通常不是持久化话题，先点击再启动节点可能收不到粗位姿。
粗位姿的 `header.frame_id` 必须是 `map`；`odom`、`base_link` 或空 frame
会被拒绝。该节点只在粗位姿附近做二维局部搜索，不是全局自动定位，也不使用
3D 点云。

导航与定位启动检查：

```bash
ros2 node list | grep -E 'amcl|planner|controller|bt_navigator|map_server'
ros2 lifecycle nodes
ros2 topic echo /amcl_pose --once
ros2 topic echo /scan_match_pose --once
ros2 topic echo /cmd_vel
ros2 action list | grep navigate
```

AMCL 不再默认强制使用建图原点。应在 RViz/Foxglove 中把 Fixed Frame 设为
`map`，发布粗略的 2D Pose Estimate。Scan-to-Map 质量达标时会发布修正后的
`/initialpose` 和 `/scan_match_pose`；质量不达标时只打印
`score`、`mean_distance`、`inlier_ratio`，不会发布错误位姿。
命令行粗位姿示例：

```bash
ros2 topic pub --once /initialpose geometry_msgs/msg/PoseWithCovarianceStamped \
  "{header: {frame_id: map}, pose: {pose: {position: {x: 0.0, y: 0.0, z: 0.0}, orientation: {w: 1.0}}, covariance: [0.25, 0, 0, 0, 0, 0, 0, 0.25, 0, 0, 0, 0, 0, 0, 0, 0, 0, 0, 0, 0, 0, 0, 0, 0, 0, 0, 0, 0, 0, 0, 0, 0, 0, 0, 0, 0.0685]}}"
```

如果粗定位后激光与地图仍有小幅偏差，可在周围无人员、线缆和低矮障碍时运行：

```bash
ros2 run ylhb_base amcl_swing_relocalization_node
```

该节点仅按 `/odom` 闭环小幅左右摆头，默认执行两轮“左 10°、右 20°、
左 10°”，`linear.x/y` 始终为 0，不前进后退、不做 360° 旋转。超时、
异常、Ctrl+C 和正常退出都会发布零速度。需要调整时使用 ROS 参数，例如：

```bash
ros2 run ylhb_base amcl_swing_relocalization_node --ros-args \
  -p cycles:=1 -p angular_speed:=0.15
```

只有在 RViz/Foxglove 中 `/scan` 与静态地图轮廓贴合、`map -> odom ->
base_footprint` 连续稳定后再发送导航目标。

发送一个简单导航目标：

```bash
ros2 action send_goal /navigate_to_pose nav2_msgs/action/NavigateToPose \
  "{pose: {header: {frame_id: map}, pose: {position: {x: 1.0, y: 0.0, z: 0.0}, orientation: {w: 1.0}}}}"
```

导航不动时按顺序检查：

```text
1. /scan 是否有频率。
2. /odom 是否更新。
3. TF 是否有 map -> odom -> base_footprint/base_link -> laser_link。
4. /initialpose 是否已设置到地图中的正确位置。
5. Scan-to-Map 是否报告质量达标，/scan 与地图是否贴合。
6. local/global costmap 是否都能看到 /scan 动态障碍。
7. controller_server 是否在输出 /cmd_vel。
8. 底盘节点是否订阅 /cmd_vel 且 ZLAC 状态在线。
```

动态避障验收时先使用低速短距离目标，在 local/global costmap 中观察人员或
纸箱等障碍是否被标记。机器人应减速、绕行或停止；如果路径仍穿过障碍、
障碍层不清除、定位跳变或持续原地转向，应立即取消目标并停车，不要通过提高
速度或关闭障碍层绕过问题。

## 12. 本地巡逻 Patrol 调试

本地巡逻功能位于 `ylhb_mobile_bridge` 包内，只通过标准 ROS 接口调用现有
Nav2，不修改 `ylhb_base` 的 Nav2 配置、DWB、costmap、footprint、机器人模型
或底盘控制代码。它的核心输入是地图坐标路线文件，核心输出是
`/patrol/status`、`/patrol/event` 和到点后的
`/inspection_ai/text_command`。

### 12.0 当前完成状态与稳定基线

导航巡逻稳定基线为 `84cdc20bacfcf3fbbf9f145f346a2246e7bda2e3`
（`fix(nav2): restore binary keepout layers`）。已完成普通无禁行区巡逻、
带 `hard_keepout` 禁行区巡逻、自动 Profile 选择、二值虚拟墙膨胀、路线地图绑定、
路线安全检查、启动/暂停/恢复/取消/返航/循环，以及 UI 状态刷新。

```text
route JSON
  ↓
地图绑定检查
  ↓
路线安全检查
  ↓
是否存在 enabled hard_keepout
  ├─ 否 → normal Profile
  └─ 是 → binary mask 生成与检查
             ↓
          keepout Profile
             ↓
          KeepoutFilter
             ↓
          InflationLayer
             ↓
          SmacPlanner2D + DWB
  ↓
patrol executor
  ↓
检查点 → 返航 → 下一轮
```

#### normal / keepout 双 Profile

`system_supervisor_node` 读取路线后，只有存在 `enabled=true` 且
`type=hard_keepout` 的禁区才选 keepout Profile；否则选 normal Profile。normal
Profile 使用 `navigation.launch.py` 与 `nav2_params.yaml`。keepout Profile 使用
`navigation_keepout.launch.py`、`nav2_params_keepout.yaml` 和 global/local mask。
Profile 为 `normal` 时不得忽略启用禁区；强制 keepout 时必须具备 keepout 能力。

Keepout 是二值虚拟墙，不使用 weighted mask、soft radius 或人工 1--99 衰减。
同一语义的 global/local binary mask 先由 KeepoutFilter 写入 costmap，再交给
InflationLayer；过滤层必须在 InflationLayer 前，才能让虚拟墙和真实墙以相同方式
膨胀。保持现有 `cost_scaling_factor: 6.0`、`inflation_radius: 0.35`；DWB 与
normal Profile 完全一致，SmacPlanner2D、footprint、AMCL、TF、行为树与 lifecycle
顺序不因路线切换而调参。

`mask_padding_m` 只补偿 polygon 栅格化边界。v3 缺省时取 `map.resolution`，当前
地图为 `0.025m`，并且不得大于该 resolution；它不是机器人半径或最终避障距离。

#### Supervisor 准备链与定位

supervisor 的巡逻准备链依次执行：读取路线、v3 地图身份绑定、路线安全检查、
Profile 选择；keepout 路线再生成并运行 `check_keepout_setup.py` 检查 mask 和
metadata，日志出现 `keepout masks ready` 后才进入 keepout 导航。运行中仍需先有
`/odom`、`/scan`、`map -> odom -> base_footprint` TF；AMCL 使用路线
`start_pose` 发布/确认初始位姿并等待新的 `/amcl_pose`，不强制地图原点。

keepout 的 `lifecycle_manager_keepout` 管理四个节点：

- `keepout_global_mask_server`
- `keepout_global_filter_info_server`
- `keepout_local_mask_server`
- `keepout_local_filter_info_server`

随后确认 Nav2 controller/planner lifecycle active。RViz 应能同时观察原始 mask 和
膨胀后的 global/local costmap。

#### 巡逻状态、返航与 UI

执行器按 `routes[].target_ids` 发送 NavigateToPose；到点等待
`task_duration_sec`。`return_to_start` 决定完成或失败策略是否返航，`loop` 决定
下一轮等待和次数。UI 与 system command 只经 supervisor 转发 `start`、`pause`、
`resume`、`cancel` 和 reload；取消不会把旧路线静默改成返航。`/patrol/status` 与
`/patrol/event` 是 UI 的实时业务状态来源。

#### 故障分类、回滚与升级复验

- 路线/地图绑定失败：重新在当前 YAML/PGM 上绘制路线，不能绕过 SHA-256、尺寸、origin 或 resolution 检查。
- 路线 unsafe：修正点位或禁区，不改 footprint、速度或 Nav2 参数迁就路线。
- mask/checker 失败：先检查 JSON 契约、输出目录和 binary metadata。
- lifecycle/定位失败：先确认四个 keepout 节点、`/amcl_pose`、`map -> odom` 和 planner/controller。
- 进程异常退出：由 supervisor 状态处理，不以 UI 文案或 mock 顺序判断已恢复。

回滚时切回稳定基线 `84cdc20`，重新生成 `maps/keepout` 并运行 checker；不要只回滚
某一个导航配置文件。任何 Nav2 升级后，必须由现场人员重新完成 normal 与 keepout
两条短距离烟雾验收：Profile 选择、路径、虚拟墙膨胀、暂停/恢复/取消与返航均需复验。

### 12.1 路线准备

路线生成工具的正式输出目录是 `~/ros2_DL/maps/`，文件名使用
`route_patrol_*.json`。当前实测默认路线为：

```bash
ls -lh ~/ros2_DL/maps/route_patrol_001.json
```

`route_file_path:=auto` 会扫描该目录。存在多个文件时优先选择文件名中编号
最大的路线，例如 `route_patrol_010.json` 优先于 `route_patrol_002.json`；
文件名编号都无法解析时，按修改时间选择最新文件。临时测试可用绝对路径覆盖：

```bash
ros2 launch ylhb_mobile_bridge patrol_executor.launch.py \
  route_file_path:=/home/nvidia/ros2_DL/maps/route_patrol_001.json
```

路线文件必须满足以下约束：

- 顶层 `version` 支持 `2` 和 `3`，`frame_id` 为 `map`。当前正式路线
  `route_patrol_001.json` 为 v3，带完整地图身份；`site`、`areas`、路线/目标
  aliases、`area_id` 和 `inspection_items` 会校验后透传。
- `active_route_id` 指定默认路线。
- `start_pose.pose` 使用机器人真实起点的 `x`、`y`、`yaw`，也是返航位姿。
- `start_pose.publish_initial_pose=true` 时，执行器启动后发布 `/initialpose`。
- `targets` 定义巡检点和 `task_duration_sec`，`routes[].target_ids` 定义执行顺序。
- `return_to_start` 控制完成后是否返航；`failure_policy` 支持 `abort` 和
  `abort_and_return_home`。
- 路线内部循环由 `loop` 控制；自动定时当前只支持 `schedules` 中的 `interval`。
- `daily` 不是静默预留：当前会明确报错 `daily schedule is not implemented; use interval or remove this schedule`。
- 每个 v3 `hard_keepout` 的 `mask_padding_m` 缺省为地图 resolution；当前正式值为 `0.025`，其含义只是二值虚拟墙边界补偿。

修改后可以用纯 Python 校验路线文件：

```bash
python3 - <<'PY'
import sys
sys.path.insert(0, "src/ylhb_mobile_bridge")
from ylhb_mobile_bridge.patrol_route_store import load_route_file

route = load_route_file("/home/nvidia/ros2_DL/maps/route_patrol_001.json")
print(route["active_route_id"], len(route["targets"]), len(route["routes"]))
PY
```

Agent 侧不会在 `agent_intents.yaml` 或 prompt 中硬编码路线业务语义。启动时
`inspection_agent_node` 读取路线文件，构建 `RouteCatalog`，再由
`RouteToolPack` 动态生成 `route_id` 和 `target_id` 枚举；例如“巡检点3”
通过目标名称解析为 `target_003`。路线/检查点查询只读路线文件，执行动作只
能走 `start_route(route_id)` 或 `go_to_checkpoint(target_id)`。

### 12.2 正式平台任务启动与持久化

正式本体 UI 推荐直接启动 `inspection` 模式：

```bash
cd ~/ros2_DL
./scripts/run_on_jetson.sh inspection
```

UI 默认进入“巡逻模式”页。平台以 `LOCAL_CONFIRM` 下发 `START`
后，bridge 先完成部署、地图和路线校验，再将命令持久化为 `ARMED`。
此时机器人不会启动，页面主按钮显示“确认启动平台巡检”；没有
待确认任务时显示“等待平台任务”并禁用。

```text
platform START startMode=LOCAL_CONFIRM
  -> ACKED -> ARMED
  -> cloud_status.pendingPlatformStart
  -> PatrolPage.qml 显示任务名和路线名
  -> UiBackend.confirmPlatformPatrolStart()
  -> Trigger /mobile_bridge/confirm_platform_start
  -> ARMED -> ACKED
  -> 现有云命令队列 -> system_supervisor_node
  -> /inspection_ai/system_command start_platform_patrol
  -> start/reuse bringup + navigation + patrol_executor
  -> /patrol/command start
  -> patrol_executor_node
```

确认前会上报 `start_waiting_local_confirmation`，触摸屏确认后上报
`local_start_confirmed`；只有执行器真正开始路线后的 `route_started`
才表示已进入巡检。平台未显式提供 `startMode` 时按
`REMOTE_IMMEDIATE` 处理，不等待本地确认。

#### 路线持久化与任务一次性

| 对象 | 存储与生命周期 | 能否直接重复启动 |
|---|---|---|
| 部署地图和路线 | 下载到本地 deployment 目录，重启 UI/bridge 不会删除 | 可被后续新任务复用 |
| `START commandId` | 记录在 `processed_commands` SQLite 表中，按 commandId 幂等 | 不能；同一命令只执行一次 |
| `ARMED` 待确认任务 | 未超时、未取消时可在 bridge 重启后恢复到 UI | 可确认一次 |
| 已完成/失败/取消的 execution | 保留审计状态，不再显示为待确认 | 需平台下发新 `START` |

因此，“路线文件还在”不等于“昨天的 `START` 今天仍可再点一次”。
若要重跑同一条路线，平台应复用已部署的路线资产，但创建新的
execution 并下发新 commandId。这能避免 UI 重启、心跳重试或重复响应
导致机器人意外再次启动。

#### 重启、取消和超时

- 只重启 UI：不改变 bridge SQLite 中的 `ARMED` 状态，UI 重新订阅
  `cloud_status.pendingPlatformStart` 后应恢复任务卡片。
- 重启 bridge：未超时的 `ARMED` 从 SQLite 恢复，但不会自动启动机器人。
- 确认前收到同 execution 的 `CANCEL`：待确认任务被清除，不启动巡逻。
- 本地确认默认超时为 1800 秒，由 `YLHB_CLOUD_LOCAL_CONFIRM_TIMEOUT_SEC`
  调整。超时后状态为 `FAILED / LOCAL_CONFIRM_TIMEOUT`，UI 按钮失效；
  最终任务状态以平台为准。
- 已确认的命令进入原有 `ACKED` 恢复和派发机制；确认后进程异常
  不需要用户再点第二次。

编译新代码不会自动替换已运行的 systemd 进程。若 bridge 由 systemd
管理，由现场人员重启服务后再重开 UI：

```bash
systemctl status ylhb-mobile-bridge.service --no-pager
sudo systemctl restart ylhb-mobile-bridge.service
ros2 topic echo --once --field data /mobile_bridge/cloud_status std_msgs/msg/String
```

上述 `restart` 会中断 bridge 的短时通信，应在机器人静止且无巡逻运行时
由现场人员执行。如果 `pendingPlatformStart` 为空，先检查任务是否已超时、
被取消、已完成，或 bridge 是否仍在运行旧版本；不要从本地重新构造任务身份。

#### 循环规则

`loop.enabled` 是循环总开关。只有 `enabled=true` 时，`max_cycles=0`
才表示无限循环；`enabled=false` 时，无论 `max_cycles` 是多少都只执行
一轮。本次排查时已下载的平台路线为 `enabled=false`、`max_cycles=0`、
`wait_sec=600`、`return_to_start=true`，所以其含义是“完成一轮检查点并
返回起点后结束”，不是无限循环；此时 `wait_sec` 不生效。

`system_supervisor_node` 启动巡逻执行器时固定使用：

```text
auto_start:=false publish_initial_pose_on_startup:=true
```

也就是说，`patrol_executor` 本身不会因为进程启动而自动开车；只有平台
命令完成本地确认并由 supervisor 派发后才进入巡逻。UI 的暂停、继续、取消和重载路线
按钮也都先发布 `/inspection_ai/system_command`，由 supervisor 转发到
`/patrol/command`。`cancel_patrol` 只取消当前巡逻，不停止 Nav2，也不杀
`patrol_executor`；需要停止执行器进程时使用 `stop_patrol_mode`。

### 12.3 手动调试启动顺序

如果不启动 UI，可按终端手动拆分调试。终端 1 启动底层：

```bash
cd ~/ros2_DL
source /opt/ros/humble/setup.bash
source install/setup.bash
ros2 launch ylhb_base bringup.launch.py
```

终端 2 启动导航：

```bash
cd ~/ros2_DL
source /opt/ros/humble/setup.bash
source install/setup.bash
ros2 launch ylhb_base navigation.launch.py map:=$HOME/ros2_DL/maps/my_map.yaml
```

终端 3 可选启动 scan-to-map 修正：

```bash
cd ~/ros2_DL
source /opt/ros/humble/setup.bash
source install/setup.bash
ros2 run ylhb_base scan_map_relocalization_node
```

终端 4 启动巡逻执行器：

```bash
cd ~/ros2_DL
source /opt/ros/humble/setup.bash
source install/setup.bash
ros2 launch ylhb_mobile_bridge patrol_executor.launch.py \
  auto_start:=false \
  publish_initial_pose_on_startup:=true
```

注意：上面的命令只启动巡逻执行器、加载路线并发布初始位姿。因为显式设置了
`auto_start:=false`，节点会保持运行并停在 `idle` 状态等待人工确认，机器人
不会自动开始移动。这是正常行为，不是节点卡死。

如果路线文件里 `start_pose.publish_initial_pose=true`，节点会向 `/initialpose`
发布 3 次粗位姿。日志应显示实际加载的
`/home/nvidia/ros2_DL/maps/route_patrol_*.json`。可以在另一个终端检查状态：

```bash
source /opt/ros/humble/setup.bash
source ~/ros2_DL/install/setup.bash
ros2 topic echo /patrol/status --once
ros2 topic echo /amcl_pose --once
```

确认 AMCL 定位稳定、机器人周围安全后，发送开始命令：

```bash
ros2 topic pub --once /patrol/command std_msgs/msg/String "{data: start}"
```

此后 `/patrol/status` 应从 `idle` 进入 `running`，Nav2 开始执行路线。如果希望
巡逻执行器发布完初始位姿后直接开始巡逻，可以把启动参数改为
`auto_start:=true`；实机首次调试仍建议使用 `false`，确认定位后再手动启动。

### 12.4 状态观察

开一个观察终端：

```bash
cd ~/ros2_DL
source /opt/ros/humble/setup.bash
source install/setup.bash

ros2 topic echo /patrol/status
ros2 topic echo /patrol/event
ros2 topic echo /inspection_ai/text_command
```

另一个终端检查 Nav2、TF 和动作接口：

```bash
ros2 action list | grep navigate
ros2 topic echo /amcl_pose --once
ros2 topic echo /cmd_vel
ros2 run tf2_ros tf2_echo map base_footprint
```

`/patrol/status` 常见状态：

```text
idle                空闲
waiting_schedule    等待 interval 定时触发
running             正在前往巡检点
paused              已暂停，当前 Nav2 goal 已取消
waiting_loop        已回到起点，等待下一轮循环
canceling           正在取消
canceled            已取消，不返航
returning_home      正在返回 start_pose.pose
succeeded           巡逻成功
failed              巡逻失败
```

`/patrol/status` 还包含用于 UI 展示的字段：

```text
target_name             当前真实路线目标名称
navigation_phase        target / return_home / waiting_next_cycle / canceled / failed / succeeded
current_target_label    优先展示的中文进度文案
target_count            来自路线文件展开后的真实目标数量
```

`/patrol/event` 常见事件：

```text
initial_pose_published
route_started
target_reached
target_task_finished
return_home_started
route_finished
route_failed
```

### 12.5 开始、暂停、恢复和取消

正式 UI/系统命令入口：

```bash
ros2 topic pub --once /inspection_ai/system_command std_msgs/msg/String \
  "{data: '{\"command\":\"start_patrol_mode\",\"profile\":\"navigation\"}'}"

ros2 topic pub --once /inspection_ai/system_command std_msgs/msg/String \
  "{data: '{\"command\":\"pause_patrol\"}'}"

ros2 topic pub --once /inspection_ai/system_command std_msgs/msg/String \
  "{data: '{\"command\":\"resume_patrol\"}'}"

ros2 topic pub --once /inspection_ai/system_command std_msgs/msg/String \
  "{data: '{\"command\":\"cancel_patrol\"}'}"

ros2 topic pub --once /inspection_ai/system_command std_msgs/msg/String \
  "{data: '{\"command\":\"reload_patrol_route\"}'}"
```

手动调试时也可以直接向 `/patrol/command` 发命令。命令既可使用纯文本，
也可使用 JSON。启动当前 `active_route_id`：

```bash
ros2 topic pub --once /patrol/command std_msgs/msg/String "{data: start}"
```

指定路线启动：

```bash
ros2 topic pub --once /patrol/command std_msgs/msg/String \
  "{data: '{\"command\":\"start\",\"route_id\":\"route_patrol_001\"}'}"
```

暂停、恢复、取消：

```bash
ros2 topic pub --once /patrol/command std_msgs/msg/String \
  "{data: '{\"command\":\"pause\"}'}"

ros2 topic pub --once /patrol/command std_msgs/msg/String \
  "{data: '{\"command\":\"resume\"}'}"

ros2 topic pub --once /patrol/command std_msgs/msg/String \
  "{data: '{\"command\":\"cancel\"}'}"
```

重新加载路线文件：

```bash
ros2 topic pub --once /patrol/command std_msgs/msg/String \
  "{data: '{\"command\":\"reload\"}'}"
```

重新发布初始位姿：

```bash
ros2 topic pub --once /patrol/command std_msgs/msg/String \
  "{data: '{\"command\":\"initialize\"}'}"
```

注意：`initialize` 和 `relocalize` 只允许在 `idle`、`waiting_schedule`、
`failed`、`succeeded`、`canceled` 状态执行；巡逻运行、暂停、返航或取消中会
被拒绝，避免重置定位导致 Nav2 跳变。

### 12.6 验收

按顺序验收：

```text
1. route 文件校验通过。
2. patrol_executor 启动后发布 initial_pose_published。
3. /scan、/odom、map -> odom -> base_footprint TF 稳定。
4. UI 或 system command 发出 start_patrol_mode 后，supervisor 启动/复用 bringup、navigation 和 patrol_executor。
5. supervisor 发布 /patrol/command start 后，/patrol/status 进入 running。
6. Nav2 action /navigate_to_pose 有目标执行。
7. 到达每个 target 后发布 target_reached。
8. /inspection_ai/text_command 收到“已到达xxx，开始执行任务”。
9. 等待 task_duration_sec 后发布 target_task_finished。
10. return_to_start=true 时最后进入 returning_home 并返回 start_pose.pose。
11. 全部完成后发布 route_finished，状态进入 succeeded。
12. pause 会取消当前 Nav2 goal 并发布零速度。
13. resume 会从当前 target 或循环等待阶段恢复。
14. cancel 会取消当前 goal、发布零速度，不返航，且不停止 navigation/patrol_executor 进程。
15. 单点失败会按 max_retries_per_checkpoint 重试。
16. abort_and_return_home 失败策略会尝试返回 start_pose.pose，最终状态为 failed。
```

路线存储逻辑变更后的开发者检查：

```bash
colcon build --symlink-install --packages-select ylhb_base ylhb_mobile_bridge
```

### 12.7 常见问题

启动后直接 `failed`：

```text
多半是 route 文件无效，或 start_pose 与机器人实际放置位置不一致。
不要把 start_pose 写成默认 0,0,0；必须按真实地图坐标设置起点。
```

只发布了 `/initialpose`，没有自动巡逻：

```text
auto_start 默认为 false。手动发送 start，或启动时设置 auto_start:=true。
auto_start:=true 时会等 start_pose 初始位姿发布序列完成后再启动路线。
```

发送 `initialize` 被拒绝：

```text
说明当前处于 running、paused、returning_home 或 canceling。
先 cancel 或等待任务结束，再重新发布 start_pose 初始位姿。
```

到点没有触发文字任务：

```bash
ros2 topic echo /inspection_ai/text_command
ros2 topic echo /patrol/event
```

如果有 `target_reached` 但没有文字，检查 `text_command_topic` 参数是否仍为
`/inspection_ai/text_command`。

机器人导航行为异常：

```text
先按第 11 章检查 Nav2、定位、costmap 和底盘链路。
本地巡逻节点不清 costmap、不 reset Nav2 lifecycle、不修改 AMCL 或 DWB 参数。
```

## 13. ZED 与感知

启动 ZED 2i：

```bash
cd ~/ros2_DL
source /opt/ros/humble/setup.bash
source install/setup.bash
ros2 launch zed_wrapper zed_camera.launch.py camera_model:=zed2i
```

等价脚本：

```bash
./scripts/run_on_jetson.sh zed
```

启动 YOLO/TensorRT 感知：

```bash
ros2 launch ylhb_perception perception.launch.py \
  model_path:=$HOME/ros2_DL/src/ylhb_perception/models/yolo26.engine \
  backend:=tensorrt \
  confidence_threshold:=0.35 \
  imgsz:=960 \
  max_det:=20 \
  half:=true \
  publish_debug_image:=false \
  show_debug_window:=false
```

调试时打开本地 OpenCV 窗口：

```bash
ros2 launch ylhb_perception perception.launch.py \
  model_path:=$HOME/ros2_DL/src/ylhb_perception/models/yolo26.engine \
  backend:=tensorrt \
  show_debug_window:=true \
  debug_window_max_hz:=15.0
```

检查话题：

```bash
ros2 topic list | grep zed
ros2 topic echo /perception/detections
ros2 topic echo /perception/localized_objects
```

模型推荐路径：

```text
~/ros2_DL/src/ylhb_perception/models/yolo26.onnx
~/ros2_DL/src/ylhb_perception/models/yolo26.engine
```

### 13.1 ZED SDK 三维建模

ZED SDK 三维建模走“双阶段”流程：现场只录制 ZED SVO，离线再从 SVO 重建 PLY 点云。
它适合扫一段设备、柜体或通道，用于巡检记录和复核；它不是二维导航地图，不会写入
`maps/my_map.yaml` 或 `maps/my_map.pgm`，也不参与 Nav2 定位导航。

这条入口不经过 `zed_wrapper`、`ylhb_perception` 或 Nav2。ZED 2i 通常只能被一个
SDK 客户端占用，所以采集前先确认没有其他 ZED 进程：

```bash
ps -ef | grep -E 'zed_wrapper|zed_camera|zed_spatial_mapping' | grep -v grep
```

如果已经运行 `./scripts/run_on_jetson.sh zed`、`zed_wrapper` 或感知链路，先停止它们。

步骤 1：现场录制 ZED SVO。当前 Orin Nano 8GB 正式流程不实时输出精品点云，
避免现场 OOM 和卡顿：

```bash
cd ~/ros2_DL
source /opt/ros/humble/setup.bash
source install/setup.bash
./scripts/run_on_jetson.sh zed_3d_capture duration_sec:=0
```

`duration_sec:=0` 表示持续录制，直到 UI 点击停止、进程收到 SIGINT/SIGTERM，
或 supervisor 执行 `stop_3d_mapping`。

输出目录类似：

```text
~/ros2_DL/runs/3d_capture/latest.json
~/ros2_DL/runs/3d_capture/index.json
~/ros2_DL/runs/3d_capture/capture_20260706_153000/
├── capture.svo2
├── metadata.json
└── status.json
```

采集时慢速移动相机或机器人，同一区域多角度扫几遍。三维建模流程不会发布 `/cmd_vel`，不会自动控制底盘。

步骤 2：采集结束后，离线重建 PLY：

```bash
./scripts/run_on_jetson.sh zed_3d_reconstruct latest
./scripts/run_on_jetson.sh zed_3d_reconstruct input:=latest profile:=quality_safe
./scripts/run_on_jetson.sh zed_3d_reconstruct session:=capture_20260706_153000
```

离线输出目录类似：

```text
~/ros2_DL/runs/3d_reconstruct/latest.json
~/ros2_DL/runs/3d_reconstruct/index.json
~/ros2_DL/runs/3d_reconstruct/reconstruct_20260706_153500/
├── metadata.json
├── status.json
└── pointcloud.ply
```

`latest.json` 和 `index.json` 解决时间戳目录每次变化的问题。`latest.json`
固定记录最新 `session_id`、`output_dir`、`svo_file`、`metadata_file`、
`status_file`、`created_at` 和 `svo_frame_count`；重建结果还会记录
`output_file`、`export_point_count`、`reconstruct_profile` 和来源 SVO。

查看最近一次输出：

```bash
cat ~/ros2_DL/runs/3d_capture/latest.json
cat ~/ros2_DL/runs/3d_reconstruct/latest.json
ls -lh ~/ros2_DL/runs/3d_reconstruct/reconstruct_*/pointcloud.ply
```

PLY 可用 CloudCompare、MeshLab 或支持点云的三维查看器打开。快速检查 SVO 是否可用时，用低负载档：

```bash
./scripts/run_on_jetson.sh zed_3d_reconstruct input:=latest profile:=fast_check
```

默认档是 `quality_safe`。机器负载低时可以尝试 `profile:=quality_plus`；如果出现
`exit code -9` 或 OOM 记录，改回默认档。

本体 UI 的“三维建模”页按同一流程工作：开始现场采集、停止并保存 SVO、
再执行快速或高质量离线重建。没有最新 SVO 时，重建按钮会禁用；绕过 UI 直接
发 supervisor 重建命令时，也会返回“请先完成一次现场采集”。

常见失败：

- `pyzed.sl import failed`：ZED SDK Python API 未安装，或当前终端没有 source 正确环境。
- `Camera.open failed`：相机未连接、权限不足，或已被 `zed_wrapper` / 其他 ZED 程序占用。
- 采集目录没有生成 `capture.svo2`：先检查 USB 连接、电源和 `dmesg`，再确认没有多个 ZED 进程。
- 离线点云形状差：先用 ZED Depth Viewer / Explorer 检查 SVO 原始图像、曝光和深度质量。

完整说明见 [ZED 3D 双阶段建模流程](../docs/三维建图工作流程.md) 和
[ZED Spatial Mapping 集成说明](../docs/ZED三维建模集成说明.md)。

## 14. AI 任务层与本体 UI 控制台

`inspection` 是机器人本体的正式 UI 控制台入口。它固定启动 QML 显示 UI、
系统 supervisor、内嵌 AI 任务层、连续语音会话和 TTS：

```bash
cd ~/ros2_DL
export DISPLAY=:1
./scripts/run_on_jetson.sh inspection
```

正式 UI 控制台启动时，`enable_display_ui`、`enable_system_supervisor`、
`enable_voice`、`enable_voice_session` 和 `enable_tts` 必须同步开启。
`inspection` 模式会拒绝 `enable_voice:=false`、`enable_voice_session:=false`
或 `enable_tts:=false`。`enable_capture_voice:=false` 是默认值，只表示不启用
一次性录音识别服务，不等同于关闭连续语音会话。

`llm.launch.py` 和 `./scripts/run_on_jetson.sh llm` 是任务层/离线调试入口。
文字调试或无屏调试可以关闭 UI、语音或 TTS：

```bash
cd ~/ros2_DL
source /opt/ros/humble/setup.bash
source install/setup.bash
ros2 launch ylhb_llm llm.launch.py \
  enable_voice:=false \
  enable_tts:=false \
  enable_display_ui:=false
```

发送巡检文字命令：

```bash
ros2 topic pub --once /inspection_ai/text_command std_msgs/msg/String \
  "{data: '{\"source\":\"cli\",\"text\":\"开始巡检任务\"}'}"
```

查看任务链路：

```bash
ros2 topic echo /inspection_ai/task_event
ros2 topic echo /inspection_ai/task_status
ros2 topic echo /inspection_ai/say_text
ros2 topic echo /inspection_ai/task_context_status
```

当前任务层主要接口：

| 话题 | 类型 | 当前含义 |
|---|---|---|
| `/inspection_ai/text_command` | `std_msgs/String` | UI、CLI、语音路由或 mobile bridge 的文本任务入口 |
| `/inspection_ai/task_event` | `ylhb_interfaces/TaskEvent` | 初始化阶段的通用巡检任务事件 |
| `/inspection_ai/task_status` | `ylhb_interfaces/TaskStatus` | 后续执行层回传状态的占位接口 |
| `/inspection_ai/say_text` | `ylhb_interfaces/SayText` | TTS 语音播报请求 |
| `/inspection_ai/voice_status` | `ylhb_interfaces/VoiceStatus` | TTS 或语音链路状态 |
| `/inspection_ai/task_context_status` | `std_msgs/String` | LLM 任务上下文 JSON |
| `/inspection_ai/system_command` | `std_msgs/String` | UI 发出的系统控制命令 JSON |
| `/inspection_ai/system_status` | `std_msgs/String` | system supervisor 状态 JSON |
| `/inspection_ai/system_mode` | `std_msgs/String` | `ready`、`mapping`、`fault` 等系统模式 |
| `/inspection_ai/agent_request` | `std_msgs/String` | 动态 Agent 文本请求 JSON |
| `/inspection_ai/agent_event` | `std_msgs/String` | Agent 工具调用、安全拒绝和结果事件 |
| `/inspection_ai/base_skill_command` | `std_msgs/String` | Agent 发出的基础运动技能命令，不直接暴露 `/cmd_vel` |
| `/inspection_ai/base_skill_status` | `std_msgs/String` | 基础运动技能执行状态 |

在 **Supervisor 内部所有权** 下，mobile bridge 进程控制命令为
`start_mobile_bridge`、`stop_mobile_bridge` 和 `restart_mobile_bridge`；这些命令由
`system_supervisor_node` 执行，restart 明确先停止再启动。本体 UI 不直接调用 bridge 的
HTTP 启动接口。在 **systemd 外部所有权** 下，Supervisor 不创建、停止或重启 bridge，
UI 只显示只读排障提示，由现场人员使用 systemd 管理服务。
三维建模在 UI 中仍以 `3d_mapping` 作为功能总称；进程模型拆成
`3d_capture` 和动态 `3d_reconstruct`。`start_3d_mapping` 启动现场 SVO 采集，
`stop_3d_mapping` 停止采集并依赖采集节点写入 `latest.json`；离线重建命令为
`reconstruct_latest_3d_map`、`reconstruct_fast_3d_map` 和
`reconstruct_quality_3d_map`。`export_3d_map` 只保留旧入口提示，不再作为正式导出路径。

`/inspection_ai/system_status` 保留既有字段，并增加：

| 字段 | 含义 |
|---|---|
| `mobile_bridge` | 兼容核心服务摘要；systemd 所有权时以 8000 TCP 探测为准 |
| `mobile_bridge_owner` | `systemd` 或 `supervisor`，由 `YLHB_MOBILE_BRIDGE_OWNER=auto` 或显式设置解析 |
| `mobile_bridge_core_state` | `starting`、`running`、`stopped`、`unreachable` 或 `ownership_conflict` |
| `mobile_bridge_tcp` | `tcp_ok`、`tcp_error` 或 `stopped`；旧 `mobile_bridge_http` 字段同为兼容 TCP 探测 |
| `mobile_bridge_last_error` | 最近一次所有权、启动或 TCP 检测错误 |
| `mobile_bridge_started_by_supervisor` | 是否由当前 Supervisor 实例启动，决定关闭时是否清理该子进程 |
| `3d_mapping` | 三维建模功能兼容状态，采集或重建运行时为 `running` |
| `3d_capture` | 现场 SVO 采集进程状态，`running` 或 `stopped` |
| `3d_reconstruct` | 离线点云重建进程状态，`running` 或 `stopped` |
| `mobile_bridge_http` | 兼容字段，当前表示本机 TCP 探测，不代表独立 HTTP 认证结果 |
| `mobile_bridge_url` | 手机 APP 使用的 `http://<Jetson_IP>:8000` |
| `jetson_ip` | supervisor 自动探测的 Jetson 局域网 IP |
| `patrol_mode_state` | supervisor 侧巡逻模式状态，常见为 `idle`、`starting`、`running` |
| `startup_step` / `startup_step_label` | UI 显示的巡逻启动阶段和中文标签 |
| `patrol_error` | 巡逻启动或诊断错误文本 |
| `patrol_readiness` | bringup、navigation、executor、route_file、odom、scan、tf、map、initialpose、Nav2 action 等诊断状态；其中 Nav2 action 只作诊断，不阻塞 UI 发起启动 |
| `last_patrol_status` | 最近一次 `/patrol/status` 原始 JSON |
| `patrol_diagnostics` | 最近巡逻事件和初始位姿事件等诊断信息 |
| `latest_3d_capture` | `runs/3d_capture/latest.json` 的最新采集记录 |
| `latest_3d_reconstruct` | `runs/3d_reconstruct/latest.json` 的最新重建记录 |

正式 `/inspection/*` 任务、告警和巡检记录协议尚未实现。当前不要把
`/inspection_ai/*` 占位接口描述为已经完成的正式业务协议。

`inspection` 模式会启动显示 UI、系统 supervisor、内嵌 AI 任务层、连续语音会话和 TTS。UI 可以发出启动/停止底层、建图、导航、感知、三维建模和 mobile bridge 等系统命令；核心 ROS 节点仍以各自 launch 管理。本机状态页包含“三维建模”卡片，读取 `system_status["3d_mapping"]`。专用“三维建模”页显示最新 SVO、最新 PLY 模型、采集帧数和重建点数，并通过 backend slots 调 supervisor 命令，不在 QML 中拼 JSON 命令字符串。

本体 UI 保留 `inspection_display_ui_node` 入口和 `enable_display_ui`、
`enable_system_supervisor`、`fullscreen`、`display`、`force_local_display`
launch 参数。`enable_display_ui:=false` 表示不启动本体 QML UI，只适合
`llm` 开发/离线调试入口，不是正式机器人控制台启动方式。UI 默认进入
“巡逻模式”页，页面包括 APP 桥接、巡逻模式、三维建模、本机状态、语音与 AI 和日志。
巡逻页顶部显示全宽路线预览图，启动按钮不依赖路线预览图是否生成，也不把
Nav2 action 就绪作为硬阻塞条件。运动控制默认锁定，10 秒无操作自动重新锁定；
急停始终发布零速度和 `emergency_stop`。

### UI 生命周期与显示会话

本体 UI 是完整 inspection 栈的生命周期锚点，而不是可单独常驻的显示进程：

```text
inspection_display_ui_node 退出
  -> OnProcessExit
  -> Shutdown 完整 inspection 栈
  -> Agent、语音、Supervisor 等节点一并退出
```

这是防止后台节点残留的有意设计。不得给 UI 设置单节点 respawn；桌面自动启动场景只在
旧节点完全退出、DISPLAY 恢复且通过 crash-loop 限制后重新启动**完整** inspection 栈。
手工 `./scripts/run_on_jetson.sh inspection` 不自动重启。显示会话与 kiosk 的设置、锁屏/解锁
现场验收见 [本体 QML 操控台](../docs/本体QML操控台.md)。

QtQuick/QML 依赖：

```bash
sudo apt install python3-pyqt5.qtquick qml-module-qtquick2 \
  qml-module-qtquick-window2 qml-module-qtquick-controls2 \
  qml-module-qtquick-layouts qml-module-qtqml-models2
```

详细设计见 [本体 QML 操控台](../docs/本体QML操控台.md)。

如需 DashScope：

```bash
export DASHSCOPE_API_KEY=你的DashScope_API_Key
ros2 launch ylhb_llm llm.launch.py enable_llm_parse:=true enable_voice:=false enable_tts:=false
```

## 15. Mobile Bridge

`ylhb_mobile_bridge` 同时承载两类职责：HTTP/WebSocket 部分是 ROS 2 与
移动端调试 APP 之间的**低速底盘控制、建图、导航现场调试入口**；
Cloud Client、Platform Store 和 ROS 命令队列则承载正式平台命令、任务身份、
部署资产、本地确认和事件上报。调试端 APP 仓库为
`liaojingwu20041031/ylhb-robot-mobile`（Expo React Native），仅用于局域网调试，
不是正式平台任务入口。

### 15.0 核心服务所有权与三层状态

`YLHB_MOBILE_BRIDGE_OWNER=auto` 是默认所有权策略：systemd 服务 active 时由 systemd
独占；unit 不存在时由 Supervisor 内部托管；unit 已启用但 inactive/failed 时仍保持
systemd 所有权并报告异常，避免抢占 8000 或生成第二个 bridge。显式 launch 参数
`mobile_bridge_managed_externally:=true|false` 优先于自动判断。

页面和排障需要把三层状态分开看：

| 层级 | 代表什么 | 主要依据 |
|---|---|---|
| 网桥核心服务 | ROS bridge、HTTP/WebSocket、Cloud Client 进程是否可用 | 状态 Topic、SetBool Service、8000 TCP、Supervisor 摘要 |
| 本地 APP 服务 | 手机 HTTP/WS 是否开放 | `/mobile_bridge/local_app_status` 与本地控制 Service |
| 云平台连接 | 主动 HTTPS heartbeat/事件/命令链路是否可用 | `/mobile_bridge/cloud_status` 与云控制 Service |

关闭本地 APP 不会停止核心服务或云连接；关闭云连接也不会停止本地 APP。生产 UI 不执行
`sudo systemctl`：systemd 异常时由现场人员按页面提示处理。更多字段语义见
[云平台连接运维](../docs/云平台连接运维.md) 和 [本体 QML 操控台](../docs/本体QML操控台.md)。

### 15.1 启动桥接

终端 N（先启动 bridge，随后可由 APP 启动底盘和建图）：

```bash
cd ~/ros2_DL
source /opt/ros/humble/setup.bash
source install/setup.bash
ros2 launch ylhb_mobile_bridge mobile_bridge.launch.py
```

这是手工调试入口。正式 inspection 与桌面自启动统一经
`scripts/run_on_jetson.sh` 解析所有权；不要在 systemd 已运行时再手工启动第二个
mobile bridge。只读排障可使用：

```bash
systemctl is-active ylhb-mobile-bridge.service
ss -lntp | grep ':8000'
ros2 node list | grep mobile_bridge
ros2 service list | grep '/mobile_bridge/set_.*_enabled'
```

默认监听 `0.0.0.0:8000`，默认地图前缀 `/home/nvidia/ros2_DL/maps/my_map`。配置文件在 `src/ylhb_mobile_bridge/config/mobile_bridge.yaml`，可改 `host`、`port`、话题名、状态/地图推送频率、地图快照尺寸、token 鉴权和速度限幅。

启动后先在 Jetson 本机验证服务是否起来：

```bash
curl http://localhost:8000/api/status
```

返回统一 JSON 信封且 `data.online: true` 即正常。bridge 可以单独启动，也可以
在本体 QML 操控台的“APP 桥接”页面通过 `system_supervisor_node` 启动、停止或重启。
该路径只发布 `/inspection_ai/system_command`，不直接调用 bridge 的 HTTP 调试 API。

本地巡逻执行器也在 `ylhb_mobile_bridge` 包中，但它不是 HTTP/WebSocket 服务，两者共享包但职责不同：

```bash
ros2 launch ylhb_mobile_bridge patrol_executor.launch.py
```

### 15.2 调试端 APP 连接

APP 默认保留一个手工地址，升级后不会清空旧 `baseUrl`。bridge 默认监听
`0.0.0.0:8000`；Wi-Fi 和 5G 有线网卡同时有有效 IPv4 时，`/api/status` 会报告多个
`appEndpoints`，它们是同一个 bridge 的 Active-Active 双入口。手机只能访问当前手机
网络可达的地址，设置页由用户确认后导入机器人发现的地址，不自动覆盖手工地址或首选
地址。连接步骤：

1. 确认 Jetson 与手机处于同一局域网（建议使用 Jetson 的有线/无线 LAN IP，不要用 USB 网络共享地址）。
2. 在 Jetson 上查看实际 IP：

   ```bash
   ip -br addr show
   ```

3. 在手机上安装调试端 APP（Expo Go 扫码或构建 APK），打开设置页。
4. 添加一个或多个 `http://<Jetson_IP>:8000`，可选择自动探测或手动固定；兼容字段
   `baseUrl` 始终等于当前活动地址。
5. 关闭 `Mock Mode`（默认开启，开启时 APP 不发任何网络请求，仅用内置模拟数据）。
6. 首页点"测试 HTTP 连接"，成功后 `connectionState` 显示 `connected`。

自动选择只探测 `GET /api/status`。方向控制、驱动启停、建图、地图修改、初始位姿和导航
等状态修改请求失败后不得跨地址自动重发，避免重复执行。地址切换期间所有运动按钮禁用，
Status/Map WebSocket 用 generation 忽略旧连接回调；急停是安全且幂等的例外，会并行
发送到全部启用地址，任一成功即提示已送达。

云平台使用 Active-Standby 双出口而不是两个 Cloud Client：Linux 默认路由 metric 决定
每次 HTTPS 请求走 5G 有线还是 Wi-Fi，保持唯一 heartbeat、ACK、事件和命令循环。接口
down 或路由消失可触发后续请求改走备用路由；接口仍 up 但 5G CPE 的 WAN 失效不在本轮
自动切换范围。同子网会产生路由歧义，系统只告警，不自动修复。配置、备份和恢复方式见
[云平台连接运维](../docs/云平台连接运维.md)。

### 15.3 WebSocket 实时状态

APP 设置页打开 `WebSocket` 开关后，dashboard 页会连接 `ws://<robot_ip>:8000/ws/status`，服务端按 `status_rate_hz` 推送一次统一信封，`data` 内是 `RobotStatus`。WebSocket 打开后无需手动刷新；关闭时回退到手动"刷新状态"按钮。

地图预览使用 `ws://<robot_ip>:8000/ws/map?downsample=1`，按 `map_stream_rate_hz` 推送 `png_base64` 与原始地图元信息。WebSocket 仅服务端→客户端单向推送，APP 不向服务端发任何帧，也不做自动重连。断连后服务端会发布零速度。

### 15.4 调试 API 概览

APP 当前使用的端点：

| 分类 | 方法 | 路径 | 用途 |
|---|---|---|---|
| 状态 | GET | `/api/status` | 机器人基础状态、健康检查 |
| 控制 | POST | `/api/cmd_vel` | 短时 `/cmd_vel`，限速限时长 |
| 控制 | POST | `/api/stop` | 急停：零速度 + 停止任务文本 |
| 任务 | POST | `/api/text_command` | 文本命令到 `/inspection_ai/text_command` |
| 底盘测试 | POST | `/api/debug/chassis/test` | 低速底盘动作测试 |
| 底盘测试 | POST | `/api/debug/chassis/stop` | 停止底盘测试 |
| 建图 | GET | `/api/debug/mapping/status` | 建图依赖检查 |
| 建图 | GET | `/api/debug/mapping/map_snapshot?downsample=1` | 最新 `/map` PNG 快照 |
| 建图 | POST | `/api/debug/mapping/start` | 启动建图进程 |
| 建图 | POST | `/api/debug/mapping/save` | 保存地图 |
| 建图 | POST | `/api/debug/mapping/stop` | 停止建图进程 |
| 系统 | GET | `/api/debug/system/status` | 查询 bridge 管理的 `bringup`、`mapping` 进程 |
| 系统 | POST | `/api/debug/system/start/{mode}` | 启动 `bringup`/`mapping`/`navigation` |
| 系统 | POST | `/api/debug/system/stop/{mode}` | 停止 bridge 启动的进程 |
| 导航 | GET | `/api/debug/navigation/status` | 导航依赖检查 |
| 导航 | POST | `/api/debug/navigation/start` | 启动 Nav2 |
| 导航 | POST | `/api/debug/navigation/set_initial_pose` | 发布 `/initialpose` |
| 导航 | POST | `/api/debug/navigation/goal` | 发送单点目标 |
| 导航 | POST | `/api/debug/navigation/cancel` | 取消当前目标 |
| 实时 | WS | `/ws/status` | 推送状态，默认约 2Hz |
| 实时 | WS | `/ws/map?downsample=1` | 推送地图 PNG 快照 |

统一响应信封：

```json
{ "ok": true, "message": "...", "data": {...}, "error": null, "timestamp": 1710000000.0 }
```

失败时 `ok: false`，`error` 取值包括 `invalid_request`、`validation_error`、`ros_unavailable`、`process_error`、`no_map`、`unauthorized`、`internal_error`。开启 `require_token=true` 后，HTTP 支持 `Authorization: Bearer <token>` 或 `X-API-Token: <token>`；WebSocket 使用 `?token=<token>`。

### 15.5 状态字段说明

`/api/status` 与 `/api/debug/status` 返回的字段对接调试端 APP：

- `system_mode`：来自 `/inspection_ai/system_mode`，取 `ready`/`mapping`/`fault`/`sleep` 等，TRANSIENT_LOCAL QoS。
- `last_map_age_sec`：`/map` 话题最近一次发布距今秒数，建图调试时判断地图是否在持续生成。
- `map_meta`：最新 `/map` 原始元信息，包含 `frame_id`、`timestamp`、`resolution`、`width`、`height`、`origin`。
- `pose` / `velocity`：来自 `/odom`，`pose={frame,x,y,yaw}`，`velocity={linear_x,angular_z}`。
- `scan_range_min` / `scan_range_max`：`/scan` 最近一帧测距范围（米），确认雷达数据质量。
- `last_odom_age_sec` / `last_scan_age_sec` / `last_imu_age_sec`：里程计、雷达、IMU 数据新鲜度，APP 可用 >3s 判定为 stale。
- `task_status`：回显最后一次通过 bridge 下发的文本命令，不订阅正式任务状态。
- `zlac_status`：底盘状态，正常为 `online`，故障为 `fault: <详情>`。
- `mapping_status` / `nav2_status`：`running` 或 `not_running`，按节点存在性判定。
- `battery_percent`：电量，当前由底盘侧提供；未提供时为空，APP 解析但不显示。

`DebugStatus.nodes` 检测键：`zlac8015d_canopen_controller`、`slam_toolbox`、`bt_navigator`、`controller_server`、`planner_server`、`amcl`、`map_server`、`bringup`（检测 `robot_state_publisher`）、`rplidar_node`、`imu`、`tf`（检测 `/tf` 话题是否有发布者）。

`/api/debug/system/status` 返回 `bringup` 和 `mapping` 两个进程对象，字段包括：

- `running`、`pid`、`returncode`：进程是否仍在运行、PID 和退出码。
- `managed_by_bridge`：是否由当前 bridge 启动。为 `false` 时停止接口不会查找或强杀手动 SSH 启动的 ROS 进程。
- `command`、`started_at`、`log_path`、`log_tail`：APP 可显示启动命令、启动时间和最近日志，方便现场判断失败原因。

`/api/debug/mapping/status` 额外返回：

- `bringup_ready`：`/odom`、`/scan`、`/imu/data` 和 TF 是否就绪。
- `map_available`：bridge 是否收到过 `/map`。
- `recommended_next_action`：`start_bringup`、`start_mapping`、`wait_for_map` 或 `continue_mapping_or_save`。

> 零售遗留字段 `salesDialogueStatus`、`cart` 在电力巡检机器人上不实现，APP 对缺失值显示"未知"，属预期行为。

### 15.6 调试流程

推荐手机端调试页面结构：

```text
连接状态：baseUrl、HTTP 测试、WebSocket 状态、鉴权错误
底盘控制：启动底盘、底盘前置状态、低速方向按钮、急停
建图控制：开始/停止建图、地图保存、建图状态和下一步提示
地图预览：/ws/map 或 map_snapshot PNG
日志/错误：bringup/mapping log_tail、process_error、no_map、validation_error
```

底盘测试：

```text
APP 启动 -> GET /api/debug/system/status
APP 控制页 -> 启动底盘 -> POST /api/debug/system/start/bringup
等待 /odom、/scan、/imu/data、TF 就绪
APP 控制页 -> 方向按钮 -> POST /api/cmd_vel (300ms, ±0.03 m/s, ±0.15 rad/s)
APP 急停按钮 -> POST /api/stop
```

建图：

```text
APP 建图面板 -> GET /api/debug/mapping/status
bringup_ready=false 时提示先启动底盘
APP 建图面板 -> 开始建图 -> POST /api/debug/system/start/mapping 或 /api/debug/mapping/start
遥控机器人覆盖场地
APP 建图面板 -> 地图预览 -> GET /api/debug/mapping/map_snapshot?downsample=1 或 WS /ws/map
APP 建图面板 -> 保存地图 -> POST /api/debug/mapping/save { map_name: "my_map" }
APP 建图面板 -> 停止建图 -> POST /api/debug/system/stop/mapping 或 /api/debug/mapping/stop
```

导航（需先启动 bringup）：

```text
APP 导航面板 -> 开始导航 -> POST /api/debug/navigation/start
APP 导航面板 -> 设置初始位姿 -> POST /api/debug/navigation/set_initial_pose
APP 导航面板 -> 发送目标点 -> POST /api/debug/navigation/goal
APP 导航面板 -> 取消 -> POST /api/debug/navigation/cancel
```

### 15.7 安全限制

- `/api/cmd_vel` 默认配置限幅为线速度 ≤ 0.30 m/s、角速度 ≤ 0.55 rad/s；后端安全硬上限为 0.35 m/s 和 0.55 rad/s，底盘控制器还会最终限幅。`duration_ms` 范围 50–3000ms，超时自动发布零速度。
- `/api/stop`、`/api/debug/chassis/stop`、`/ws/status` 断开、`/ws/map` 断开都会发布零速度。
- 进程管理只允许白名单命令（`bringup`、`mapping`、`navigation`），通过 argv list 和 `shell=False` 调用 `scripts/run_on_jetson.sh`。
- 长运行进程日志写入 `logs/mobile_bridge/<mode>.log`，避免 ROS launch 输出填满未消费 pipe 导致进程阻塞。
- 停止 `bringup` 前，APP 应先提示用户停止 `mapping`；服务端不会自动连带停止依赖进程。
- 保存地图的 `map_name` 只允许字母、数字、下划线和连字符，目标固定在 `maps/` 同级前缀下，禁止路径穿越。
- bridge 默认允许局域网跨域（CORS `*`），**仅用于局域网，不暴露公网**。
- 默认 `require_token=false`：依赖网络层隔离，不要把 8000 端口映射到公网或不可信网络。需要简单鉴权时设置 `require_token=true` 和 `api_token`。
- APP 侧额外节流：底盘命令 200ms 最小间隔，控制面板 10s 无操作自动锁定。

### 15.8 故障排查

APP 显示 `network_error`：

```text
1. 确认手机与 Jetson 同局域网。
2. 确认 baseUrl 的 IP 与 Jetson 实际 IP 一致，端口 8000。
3. Jetson 上 curl http://localhost:8000/api/status 验证服务已启动。
4. 确认 APP 的 Mock Mode 已关闭。
```

APP 连接成功但状态全灰：

```text
1. 调用 POST /api/debug/system/start/bringup 启动底盘，或确认 bringup 已在终端运行。
2. APP 调试页查看 nodes/topics 哪些为 false。
3. /odom、/scan、/imu/data 或 TF 未就绪时，不要解锁方向按钮。
4. last_odom_age_sec / last_scan_age_sec > 3s 表示传感器无数据。
```

WebSocket 连不上：

```text
1. 确认 APP 设置页 WebSocket 开关已打开。
2. 确认 baseUrl 协议与 WS 一致（http -> ws，https -> wss）。
3. 服务端按 `status_rate_hz` 推送，无消息说明服务端未启动或已退出。
4. 若开启 token，WS 地址需附加 `?token=<token>`。
```

建图/导航启动失败返回 `process_error`：

```text
1. 确认 scripts/run_on_jetson.sh 存在且可执行。
2. 确认 workspace_dir 参数指向正确的工作空间。
3. 调用 GET /api/debug/system/status 查看 returncode、log_path 和 log_tail。
4. 在 Jetson 上手动执行 ./scripts/run_on_jetson.sh mapping 验证脚本本身。
```

地图预览返回 `no_map`：

```text
1. 确认 mapping 或 map_server 已发布 /map。
2. ros2 topic echo /map --once 验证话题有数据。
3. APP 显示“等待 /map 数据”，继续轮询或等待 /ws/map。
4. 降低 downsample 或检查 map_max_size_px 配置。
```

停止接口返回“was not started by bridge”：

```text
1. 该进程不是当前 bridge 启动，managed_by_bridge=false 属预期。
2. 不要让 APP 强杀 SSH 手动启动的 ROS 进程。
3. 回到原终端停止，或重新通过 bridge 启动后再由 APP 管理。
```

## 16. 常用调试命令

```bash
ros2 node list
ros2 topic list
ros2 service list
ros2 action list
ros2 topic info /cmd_vel -v
ros2 topic hz /scan
ros2 topic echo /odom --once
ros2 topic echo /imu/data --once
ros2 topic echo /map --once --field info
ros2 lifecycle nodes
ros2 run tf2_tools view_frames
```

查看 launch 参数：

```bash
ros2 launch ylhb_base bringup.launch.py --show-args
ros2 launch ylhb_base navigation.launch.py --show-args
ros2 launch ylhb_mobile_bridge patrol_executor.launch.py --show-args
ros2 launch ylhb_llm llm.launch.py --show-args
ros2 launch ylhb_perception perception.launch.py --show-args
ros2 launch ylhb_3d_mapping zed_spatial_mapping.launch.py --show-args
```

脚本模式：

```bash
./scripts/run_on_jetson.sh bringup
./scripts/run_on_jetson.sh mapping
./scripts/run_on_jetson.sh navigation
./scripts/run_on_jetson.sh zed
./scripts/run_on_jetson.sh zed_3d_capture duration_sec:=0
./scripts/run_on_jetson.sh zed_3d_reconstruct latest
./scripts/run_on_jetson.sh zed_3d_reconstruct input:=latest profile:=quality_safe
./scripts/run_on_jetson.sh zed_3d_reconstruct session:=capture_YYYYmmdd_HHMMSS
./scripts/run_on_jetson.sh perception
./scripts/run_on_jetson.sh llm
./scripts/run_on_jetson.sh inspection
./scripts/run_on_jetson.sh teleop
```

## 16.1 智能运维助手

普通用户可直接在 APP、UI 或语音入口询问：

- “APP 怎么连接，机器人 IP 是多少？”：助手读取当前物理网卡地址、Mobile Bridge TCP 状态和本地 APP 开关，不返回固定示例 IP。
- “机器人现在能巡逻吗？”或“帮我检查一下机器人”：助手按当前模式检查 Supervisor、底盘、传感器、导航、感知、巡逻和语音状态。待机模式不会因为 AMCL、Nav2 或巡逻未启动而误报。
- “底盘为什么没有反应？”：助手依据 ZLAC 状态、心跳、反馈、故障和 `/odom` 新鲜度说明证据；供电或线路只能列为可能原因，需人工确认。
- “检查感知模块，能修就修”：助手先做新鲜诊断；只有 `perception` 被诊断为可恢复且没有活动巡逻时，才请求 Supervisor 重启并等待真实结果。

连接时手机必须与机器人处于可达网络，并使用助手返回的实时 URL。若本地 APP 接口被关闭，问题不是网络故障，不应重启 Bridge；若 Bridge 由 systemd 管理，Supervisor 会拒绝启动第二个实例。

只读观察：

```bash
ros2 topic echo /inspection_ai/health_status --once
ros2 topic echo /inspection_ai/diagnostic_event --once
ros2 topic echo /inspection_ai/system_status --once
```

自动恢复默认关闭。开启后也只允许恢复配置白名单中的 `perception` 和 Supervisor 管理的 `mobile_bridge`，每个故障最多尝试一次并受冷却时间限制。它不会启动 Nav2、巡逻、底盘或 CAN 恢复，也不会修改地图、路线和参数。

## 17. 常见问题

### 编译通过但测试不全绿

当前 ZED wrapper 第三方包存在 lint/copyright 测试失败，受限网络下 `xmllint` 也会因无法加载 `download.ros.org` schema 失败。这不影响 `colcon build` 生成运行文件。自研包问题应优先用 `--packages-select ylhb_base ylhb_llm ylhb_perception ylhb_mobile_bridge ylhb_interfaces ylhb_3d_mapping` 单独验证。

### CAN 不在线

- 检查 `ip -br link show can1`。
- 检查 `candump -tz can1`。
- 检查 `src/ylhb_base/config/zlac8015d.yaml` 中 `can_interface` 是否为实际接口。
- 不要在没有 SocketCAN 接口时修改 ROS 2 控制逻辑。

### 雷达无数据

- 检查 `/dev/robot_lidar`。
- 检查 launch 日志中的 `serial_baudrate` 是否为 `115200`。
- 执行 `ros2 topic hz /scan`。
- 不要把 N300WP PRO IMU 串口当作雷达端口。

### IMU 无数据

- 检查 `/dev/robot_imu`、`/dev/ttyACM*`、`/dev/ttyCH343USB*` 和 `/dev/ttyUSB*`。
- 检查 `lsusb | grep -i '1a86:55d4'`，确认 N300WP PRO 已枚举。
- 检查 ModemManager 是否抢占串口，必要时重新执行 `sudo ./src/bind_usb.sh`。
- 检查 `ros2 topic echo /imu/data --once`。
- 实机建图和导航不要长期使用 `enable_imu:=false`。

### 地图保存到了错误目录

推荐只使用：

```bash
~/ros2_DL/maps/my_map.yaml
~/ros2_DL/maps/my_map.pgm
```

如果发现 `~/ros2_DL/src/maps`，说明旧配置或旧进程仍在运行；停止相关节点，重新 source 并启动当前工作空间。

### Nav2 未启动或无法导航

- 先启动 bringup。
- 确认 `/odom`、`/scan`、TF 和地图存在。
- 先运行 `scan_map_relocalization_node`，再发布 `map` frame 的 `/initialpose`。
- 确认 `/scan_match_pose` 合理且 `/scan` 与地图轮廓贴合。
- 查看 `planner_server`、`controller_server`、`bt_navigator`、`amcl`。
- 查看 local/global costmap 的 `/scan` 障碍层是否更新。
- 查看 `/cmd_vel` 是否输出，以及底盘节点是否订阅。

### UI 不显示

- Jetson 物理屏幕使用 `DISPLAY=:0`。
- SSH X11 的 `localhost:10.0` 会显示到远程电脑，不适合现场屏幕。
- `./scripts/run_on_jetson.sh inspection` 会把 SSH 转发 DISPLAY 自动改成本机显示。
- `enable_display_ui:=false` 表示主动不启动 QML UI；确认当前是否误用了 `llm`
  调试入口或传入了关闭 UI 的 launch 参数。
- 如果日志出现 `BYTE_ARRAY`/`STRING_ARRAY` 参数类型错误，优先检查语音词表参数声明；
  这属于 ROS 2 Humble 空字符串数组参数类型问题，不是 QML 显示问题。
