liaojingwu20041031/electric-power-inspection-robot/docs/移动端桥接调试接口.md

# Mobile Bridge APP 调试接口

Base URL：`http://<robot_ip>:8000`

本文档覆盖当前 APP 需要的功能：状态查看、底盘低速控制、建图调试、巡逻调试。
APP 不直接接入导航、任务或感知内部接口。

机器人端需先启动 mobile bridge：

```bash
cd ~/ros2_DL
source /opt/ros/humble/setup.bash
source install/setup.bash
ros2 launch ylhb_mobile_bridge mobile_bridge.launch.py
```

Bridge 监听 `8000` 端口，只建议在可信局域网使用，不要映射到公网。
配置 `YLHB_CLOUD_BASE_URL` 和 `YLHB_CLOUD_ROBOT_TOKEN` 后，deploy/start/pause/resume/
takeover/cancel 旧入站接口默认返回 `409 INBOUND_CONTROL_DISABLED`；只读 health、events、
execution 仍保留。暂停云连接不会自动开放入站控制，调试时必须显式设置
`YLHB_ALLOW_INBOUND_PLATFORM_CONTROL=true`。

公网 Robot Bridge 与本地 Mobile Bridge 是两条不同链路：

- 公网主链路由 Jetson 主动访问 `https://example.com/robot-api/v1`；公网服务器不访问 Jetson。
- 本地 APP 使用本文 `/api/*`、`/api/debug/*` 和 WebSocket，仅限可信局域网。
- `/api/platform/v1` 仅作本机/可信局域网调试，不是 Spring Boot 的正式公网调用路径。
- 浏览器和平台前端不得持有 Robot Token 或 Bridge Admin Token。

Cloud Link 的 env、systemd、状态 Topic、SetBool 开关、日志和备份见 [Jetson 云平台连接运维](云平台连接运维.md)；协议字段见 [Robot Platform Protocol v1](protocol/robot-platform-v1.md)。

## 三层服务与本地 APP 开关

- 网桥核心进程：承载 ROS、FastAPI 和 Cloud Client，生产由 systemd 自动维护。
- 本地 APP 服务：`/mobile_bridge/local_app_status` 与
  `/mobile_bridge/set_local_app_enabled`，只控制手机接口。
- 云平台连接：`/mobile_bridge/cloud_status` 与
  `/mobile_bridge/set_cloud_enabled`，只控制主动 HTTPS Cloud Link。

默认值为 `YLHB_LOCAL_APP_ENABLED=true`，UI 设置会持久化为
`bridge_settings.local_app_enabled_override`。关闭本地 APP 不停止核心进程，不影响当前
巡检、ROS 通信、本地事件持久化、`/api/platform/v1/**`、云 heartbeat 或事件补传。

关闭后，以下手机接口返回 HTTP 503：`/api/status`、`/api/cmd_vel`、
`/api/text_command`、`/api/task`、`/api/stop`、`/api/debug/**`。

```json
{
  "ok": false,
  "error": "local_app_disabled",
  "message": "本地 APP 服务已关闭"
}
```

503 表示服务被用户关闭，不是鉴权失败，不能改用 401。新的 `/ws/status`、`/ws/map`
连接会被拒绝；已连接客户端会在下一次状态周期（最多约 1 秒）由服务端主动关闭。
关闭云平台连接不会触发上述行为，本地 APP 仍可继续使用。

## 重要约定

- APP 只允许通过系统进程端口启动/停止 `bringup` 和 `mapping`；该接口优先转发给
  `system_supervisor_node`，supervisor 未在线时返回 `supervisor_unavailable`。
- `POST /api/debug/system/start/navigation` 和
  `POST /api/debug/system/stop/navigation` 返回 HTTP `404`，APP 不应调用。
- 建图预览和保存只接受 SLAM Toolbox 当前发布的 `/map`。旧的导航静态地图
  `map_server` 不会被当作建图结果返回给 APP。
- 检测到 `map_server` 与 SLAM Toolbox 同时运行时，bridge 拒绝缓存、预览和
  保存 `/map`，避免无法区分静态地图与实时地图；应先停止外部导航进程。
- 每次开始或停止建图时，bridge 会清空上一次缓存的地图，避免 APP 看到旧图。
- 无请求体的 `POST` 不需要发送 `{}`。
- JSON 请求建议发送 `Content-Type: application/json`。

## 双网络访问与安全切换

本地 APP 和云平台使用不同的双网络语义：

- 本地 APP 是 Active-Active 双入口。bridge 监听 `0.0.0.0:8000` 时，Wi-Fi 和
  5G 有线网卡的有效 IPv4 地址可同时访问同一个 Mobile Bridge。
- 云平台是 Active-Standby 双出口。系统中始终只有一个 `PlatformCloudClient`、一个
  heartbeat 循环和一套事件/命令队列；Linux 根据默认路由 metric 为每次 HTTPS 请求
  选择一个出口，主接口路由消失后，后续重试才走备用接口。

`GET /api/status` 的 `data.network` 是可选兼容字段，旧 APP 可以忽略：

```json
{
  "appEndpoints": [
    {"interface": "wlan0", "type": "wifi", "label": "Wi-Fi 网络", "url": "http://192.168.137.100:8000", "available": true},
    {"interface": "eth0", "type": "ethernet", "label": "5G 有线网络", "url": "http://192.168.8.20:8000", "available": true}
  ],
  "interfaces": [],
  "preferredAppEndpoint": null,
  "warnings": []
}
```

手机只能使用当前手机网络可达的地址。移动端只用 `GET /api/status` 探测和切换地址；
调试状态接口失败不等于网络不可达。`POST /api/cmd_vel`、驱动启停、建图、地图修改、
初始位姿和导航等状态修改请求只发送到当前活动地址，超时后不得换地址透明重发，避免
无法确认第一次请求是否已执行而产生重复动作。急停 `POST /api/stop` 是安全且幂等的，
可以用 `Promise.allSettled` 同时发送到全部启用地址，任一成功即视为已送达。

Status/Map WebSocket 切换地址时必须递增各自 generation；旧连接的延迟
`onclose`、`onerror`、`onmessage` 不得修改新连接状态。若 Wi-Fi 和有线地址落在同一
IPv4 子网，bridge 只报告 `OVERLAPPING_SUBNET` 警告，不自动改路由。

## 统一响应

HTTP 响应和 WebSocket 数据帧使用统一信封：

```ts
type ApiResponse<T> = {
  ok: boolean;
  message: string | null;
  data: T | null;
  error: string | null;
  timestamp: number;
};
```

成功示例：

```json
{
  "ok": true,
  "message": "bringup started pid=12345",
  "data": null,
  "error": null,
  "timestamp": 1710000000.0
}
```

失败示例：

```json
{
  "ok": false,
  "message": "no current SLAM map has been received",
  "data": null,
  "error": "no_map",
  "timestamp": 1710000000.0
}
```

APP 判断业务结果必须看 `ok`，不能只看 HTTP 状态码：

| 场景 | HTTP | `ok` | `error` |
|---|---:|---|---|
| 正常成功 | 200 | `true` | `null` |
| 无当前建图地图 | 200 | `false` | `no_map` |
| 进程启动/保存失败 | 200 | `false` | `process_error` |
| 请求体字段错误 | 422 | `false` | `validation_error` |
| token 缺失或错误 | 401 | `false` | `unauthorized` |
| 不支持的系统 mode | 404 | `false` | `not_found` |

默认配置 `require_token=false`。启用 token 后：

- HTTP：`Authorization: Bearer <token>` 或 `X-API-Token: <token>`
- WebSocket：`ws://<robot_ip>:8000/ws/status?token=<token>`
- WebSocket token 错误时直接关闭，关闭码为 `1008`

## 页面一：连接和状态

### GET `/api/status`

用途：轻量连接检查和基础状态展示。

请求体：无。

返回 `data`：

```ts
type RobotStatus = {
  online: boolean;
  can_status: "online" | "unknown";
  zlac_status: string;
  task_status: string;
  system_mode: string;
  mapping_status: "running" | "not_running";
  nav2_status: "running" | "not_running";
  last_odom_age_sec: number | null;
  last_scan_age_sec: number | null;
  pose: { frame: string; x: number; y: number; yaw: number } | null;
  velocity: { linear_x: number; angular_z: number } | null;
  network?: {
    appEndpoints?: Array<{ interface: string; type: string; label: string; url: string; available: boolean }>;
    interfaces?: unknown[];
    preferredAppEndpoint?: { interface: string; type: string; label: string; url: string; available: boolean } | null;
    warnings?: Array<{ code: string; message: string }>;
  };
  timestamp: number;
};
```

说明：

- `online=true` 只表示 bridge 进程可响应。
- `nav2_status` 可能存在于返回中，但本阶段 APP 不使用。
- `data.timestamp` 是状态生成时间；外层 `ApiResponse.timestamp` 是响应生成时间。

### GET `/api/debug/status`

用途：底盘页和建图页的详细状态源。

请求体：无。

返回 `data`：

```ts
type DebugStatus = {
  online: boolean;
  topics: {
    "/cmd_vel": boolean;
    "/odom": boolean;
    "/scan": boolean;
    "/map": boolean;
    "/imu/data": boolean;
  };
  nodes: {
    zlac8015d_canopen_controller: boolean;
    slam_toolbox: boolean;
    bringup: boolean;
    rplidar_node: boolean;
    imu: boolean;
    tf: boolean;

    // 后端可能返回以下导航相关字段，APP 本阶段忽略。
    bt_navigator?: boolean;
    controller_server?: boolean;
    planner_server?: boolean;
    amcl?: boolean;
    map_server?: boolean;
  };
  last_odom_age_sec: number | null;
  last_scan_age_sec: number | null;
  last_map_age_sec: number | null;
  last_imu_age_sec: number | null;
  scan_range_min: number | null;
  scan_range_max: number | null;
  zlac_status: string;
  mapping_status: "running" | "not_running";
  nav2_status: "running" | "not_running";
  task_status: string;
  system_mode: string;
  pose: { frame: string; x: number; y: number; yaw: number } | null;
  velocity: { linear_x: number; angular_z: number } | null;
  map_meta: MapMeta | null;
};
```

APP 判断底盘是否可调试，建议使用：

- `topics["/odom"] === true`
- `topics["/scan"] === true`
- `topics["/imu/data"] === true`
- `nodes.tf === true`
- `last_odom_age_sec`、`last_scan_age_sec`、`last_imu_age_sec` 都不为 `null`
  且小于 APP 新鲜度阈值，例如 3 秒

### GET `/api/debug/system/status`

用途：查看系统 supervisor 发布的进程状态；supervisor 未在线时回退为 bridge
兼容进程状态。

请求体：无。

返回 `data`：

```ts
type SystemStatus = {
  bringup: ProcessStatus | "running" | "stopped";
  mapping: ProcessStatus | "running" | "stopped";
  patrol_executor?: "running" | "stopped";
  mobile_bridge_http?: "tcp_ok" | "tcp_error" | "stopped";
  mobile_bridge_url?: string;
  jetson_ip?: string;
};

type ProcessStatus = {
  mode: "bringup" | "mapping";
  command: string[] | null;
  pid: number | null;
  started_at: number | null;
  running: boolean;
  returncode: number | null;
  log_path: string | null;
  log_tail: string;
  managed_by_bridge: boolean;
};
```

兼容进程状态字段说明：

- `managed_by_bridge=true`：该进程由当前 bridge 实例启动，可通过停止接口停止。
- `managed_by_bridge=false`：bridge 没有该进程记录，停止接口不会查找或强杀
  SSH 手动启动的 ROS 进程。
- `running=false` 且 `returncode !== null`：进程已经退出，APP 应展示
  `log_tail`。
- `log_tail` 最多读取日志文件末尾约 8 KiB。

示例：

```json
{
  "bringup": {
    "mode": "bringup",
    "command": ["/home/nvidia/ros2_DL/scripts/run_on_jetson.sh", "bringup"],
    "pid": 12345,
    "started_at": 1710000000.0,
    "running": true,
    "returncode": null,
    "log_path": "/home/nvidia/ros2_DL/logs/mobile_bridge/bringup.log",
    "log_tail": "...",
    "managed_by_bridge": true
  },
  "mapping": {
    "mode": "mapping",
    "command": null,
    "pid": null,
    "started_at": null,
    "running": false,
    "returncode": null,
    "log_path": null,
    "log_tail": "",
    "managed_by_bridge": false
  }
}
```

## 页面二：底盘低速控制

### POST `/api/debug/system/start/bringup`

用途：启动底盘基础 bringup，包括底盘、雷达、IMU、TF 等底层链路。

请求体：无。

成功响应：

```json
{
  "ok": true,
  "message": "system command sent: start_bringup",
  "data": null,
  "error": null,
  "timestamp": 1710000000.0
}
```

supervisor 未在线时返回：

```json
{
  "ok": false,
  "message": "system supervisor is not online",
  "data": null,
  "error": "supervisor_unavailable",
  "timestamp": 1710000000.0
}
```

### POST `/api/debug/system/stop/bringup`

用途：通过 supervisor 停止 bringup。

请求体：无。

注意：

- 停止 `bringup` 前，APP 应先停止 `mapping`。
- 服务端不会自动连带停止 `mapping`。
- supervisor 未在线时返回 `ok=false,error=supervisor_unavailable`。

### POST `/api/cmd_vel`

用途：底盘低速点动控制。

请求体：

```ts
type VelocityCommand = {
  linear_x?: number;    // 默认 0.0，单位 m/s
  angular_z?: number;   // 默认 0.0，单位 rad/s
  duration_ms?: number; // 默认 300，范围 50..3000
};
```

示例：

```json
{ "linear_x": 0.03, "angular_z": 0.0, "duration_ms": 300 }
```

服务端规则：

- `linear_x` 会按配置限幅，默认最大绝对值 `0.30 m/s`；后端安全上限为
  `0.35 m/s`，底盘控制器还会按自身配置做最终限幅。
- `angular_z` 会按配置限幅，默认最大绝对值 `0.55 rad/s`；后端安全上限为
  `0.55 rad/s`，底盘控制器还会按自身配置做最终限幅。
- `duration_ms` 越界返回 HTTP `422`，不会自动限幅。
- 每次请求到期后，bridge 会自动发布一次零速度。

推荐 APP 按住按钮时每 200 到 300 ms 重发一次，松手、离开页面、网络异常时调用
急停接口。

### POST `/api/debug/chassis/test`

用途：底盘调试页可选接口，行为等同 `/api/cmd_vel`，多一个 UI 用的 `mode` 字段。

请求体：

```ts
type ChassisTestRequest = VelocityCommand & {
  mode: string;
};
```

示例：

```json
{
  "mode": "forward",
  "linear_x": 0.03,
  "angular_z": 0.0,
  "duration_ms": 300
}
```

`mode` 只用于响应文案，不参与运动计算。

### POST `/api/stop`

用途：总急停。底盘页建议优先使用此接口。

请求体：无。

行为：

- 立即发布零速度。
- 同时向任务话题发布停止文本，方便上层任务停止。
- 停止文本做 2 秒去重；零速度仍会立即发布。

### POST `/api/debug/chassis/stop`

用途：仅底盘急停。

请求体：无。

行为：立即发布零速度，不发布任务停止文本。

## 页面三：建图调试

建图页必须先确认底盘就绪，再启动 mapping。`mapping.launch.py` 只启动
SLAM Toolbox，不启动底盘、雷达或 IMU。

### GET `/api/debug/mapping/status`

用途：建图页主状态接口。

请求体：无。

返回 `data`：

```ts
type MappingStatus = {
  mapping_status: "running" | "not_running";
  bringup_ready: boolean;
  map_available: boolean;
  recommended_next_action:
    | "start_bringup"
    | "start_mapping"
    | "wait_for_map"
    | "continue_mapping_or_save";
  last_map_age_sec: number | null;
  map_meta: MapMeta | null;
  process: ProcessStatus | null;
};
```

字段说明：

- `mapping_status`：根据 SLAM Toolbox 节点是否存在判断。
- `bringup_ready`：只检查 `/odom`、`/scan`、`/imu/data` 和 `/tf` 是否存在；
  它不代表数据一定新鲜，APP 仍应参考 `/api/debug/status` 中的 age 字段。
- `map_available=true`：bridge 已收到当前 SLAM Toolbox 发布的 `/map`。
- 若 `nodes.map_server=true`，bridge 不接受 `/map`，APP 应提示用户先停止
  外部启动的导航或静态地图服务。
- `last_map_age_sec=null`：还没有收到当前建图地图，或 SLAM Toolbox 已停止。
- `map_meta=null`：同上。
- `process`：bridge 管理的 mapping 进程状态。

推荐 UI 逻辑：

| 条件 | APP 显示/动作 |
|---|---|
| `recommended_next_action="start_bringup"` | 提示先启动底盘 |
| `recommended_next_action="start_mapping"` | 允许点击开始建图 |
| `recommended_next_action="wait_for_map"` | 显示“建图启动中，等待地图数据” |
| `recommended_next_action="continue_mapping_or_save"` | 显示实时地图，允许保存 |

### POST `/api/debug/system/start/mapping`

用途：启动建图。

请求体：无。

行为：

- 启动前清空 bridge 中缓存的旧地图。
- 发布 `start_mapping` 到 `/inspection_ai/system_command`，由 supervisor 启动。

成功响应示例：

```json
{
  "ok": true,
  "message": "system command sent: start_mapping",
  "data": null,
  "error": null,
  "timestamp": 1710000000.0
}
```

兼容入口：`POST /api/debug/mapping/start`，新 APP 建议使用
`/api/debug/system/start/mapping`。

### GET `/api/debug/mapping/map_snapshot?downsample=1`

用途：HTTP 拉取当前建图 PNG 快照。

请求体：无。

Query：

- `downsample`：整数 `1..16`，默认 `1`。HTTP 越界返回 `422`。

成功返回 `data`：

```ts
type MapSnapshot = {
  map_meta: MapMeta;
  png_base64: string;
};

type MapMeta = {
  frame_id: string;
  timestamp: number;
  resolution: number;
  width: number;
  height: number;
  origin: {
    position: { x: number; y: number; z: number };
    orientation: { x: number; y: number; z: number; w: number };
  };
};
```

APP 显示图片：

```ts
const uri = `data:image/png;base64,${snapshot.png_base64}`;
```

无当前 SLAM 地图时返回：

```json
{
  "ok": false,
  "message": "no map has been received",
  "data": null,
  "error": "no_map",
  "timestamp": 1710000000.0
}
```

`no_map` 的常见原因：

- 刚启动建图，SLAM Toolbox 还没有发布 `/map`。
- 底盘、雷达、TF 未就绪。
- 建图进程已停止。
- 只有旧的导航静态地图存在，但没有当前 SLAM Toolbox 地图。
- SLAM Toolbox 与 `map_server` 同时运行，bridge 为避免地图来源混淆而拒绝
  返回地图。

### WS `/ws/map?downsample=1`

用途：实时推送当前建图 PNG 快照，默认约 1 Hz。

Query：

- `downsample`：无法解析时回退为 `1`，超出范围会截断到 `1..16`。

数据帧同 `ApiResponse<MapSnapshot>`。没有当前地图时，连接不会关闭，会持续推送
`ok=false,error=no_map`。

### POST `/api/debug/mapping/save`

用途：保存当前 SLAM Toolbox 地图。

请求体：

```ts
type MappingSaveRequest = {
  map_name?: string; // 默认 my_map，只允许 A-Z a-z 0-9 _ -
};
```

示例：

```json
{ "map_name": "my_map" }
```

调用条件：

- `GET /api/debug/mapping/status` 中 `map_available=true`。
- 建议保存按钮进入 loading，避免重复点击。

无当前 SLAM 地图时不会调用 `map_saver_cli`，直接返回：

```json
{
  "ok": false,
  "message": "no current SLAM map has been received",
  "data": null,
  "error": "no_map",
  "timestamp": 1710000000.0
}
```

成功返回 `data`：

```ts
type SavedMap = {
  yaml_path: string;
  pgm_path: string;
  output: string;
};
```

示例：

```json
{
  "yaml_path": "/home/nvidia/ros2_DL/maps/my_map.yaml",
  "pgm_path": "/home/nvidia/ros2_DL/maps/my_map.pgm",
  "output": "..."
}
```

保存过程最多等待约 60 秒。

### POST `/api/debug/system/stop/mapping`

用途：停止由 bridge 启动的建图进程。

请求体：无。

行为：

- 停止 mapping 进程。
- 清空 bridge 中缓存的建图地图，APP 后续预览会得到 `no_map`。

兼容入口：`POST /api/debug/mapping/stop`，新 APP 建议使用
`/api/debug/system/stop/mapping`。

## 页面四：巡逻调试

巡逻页通过 `patrol_executor` 消费 `/patrol/command`。若 executor 未运行，
状态接口会明确返回不可用，APP 应提示先启动巡逻模式。

### GET `/api/debug/patrol/status`

用途：查看巡逻执行器状态。

请求体：无。

返回 `data`：

```ts
type PatrolDebugStatus = {
  state: "unavailable" | "idle" | "running" | "paused" | "succeeded" | "failed" | "canceled";
  executor_running: boolean;
  message?: string;
  active_route_id?: string;
  active_target_id?: string;
};
```

没有收到 `/patrol/status` 且 executor 未运行时：

```json
{
  "state": "unavailable",
  "executor_running": false,
  "message": "patrol executor is not running"
}
```

### POST `/api/debug/patrol/{command}`

用途：向 `/patrol/command` 发布巡逻控制命令。

支持的 `command`：

| command | 发布内容 |
|---|---|
| `start` | `start` |
| `pause` | `pause` |
| `resume` | `resume` |
| `cancel` | `cancel` |
| `reload` | `reload` |
| `initialize` | `initialize` |

请求体：无。

成功响应示例：

```json
{
  "ok": true,
  "message": "patrol command sent: start",
  "data": null,
  "error": null,
  "timestamp": 1710000000.0
}
```

## 地图文件管理

地图文件管理操作固定在 `/home/nvidia/ros2_DL/maps`，默认地图名称固定为
`my_map.yaml` 和 `my_map.pgm`。

修改地图文件前必须停止建图和外部导航。检测到 SLAM Toolbox、`map_server`
或 bridge 管理的 mapping 进程正在运行时，重命名、删除和确认默认地图接口返回
HTTP `409`、`error=map_in_use`。

### GET `/api/debug/maps`

用途：列出地图目录中的 `.yaml/.pgm` 地图对及有效性。

返回的每个地图包含 `name`、`yaml_file`、`pgm_file`、`valid`、`issues`、
`is_default`、`size_bytes`、`modified_at`、`resolution` 和 `origin`。

### GET `/api/debug/maps/{map_name}/preview?max_size_px=1024`

用途：预览已经保存到磁盘的地图。该接口不同于实时建图使用的
`/api/debug/mapping/map_snapshot`。

- `max_size_px` 范围为 `1..4096`，默认 `1024`。
- 地图必须是完整、有效、非符号链接的同名 `.yaml/.pgm` 文件对。
- 返回格式与实时地图预览保持一致，图片为 PNG base64。

```ts
type SavedMapPreview = {
  map_meta: {
    name: string;
    yaml_file: string;
    pgm_file: string;
    resolution: number | null;
    origin: number[] | null;
    size_bytes: number;
    modified_at: number | null;
    is_default: boolean;
  };
  png_base64: string;
};
```

### POST `/api/debug/maps/{map_name}/confirm_default`

用途：把指定地图确认为 Nav2 和本地巡逻默认地图，并为新默认地图创建平台上传任务。当前默认地图再次调用时只上传，不重复归档。

请求体：无。

成功时执行一个可回滚的成组操作：

1. 当前 `my_map.yaml/.pgm` 改名为
   `my_map_deprecated_YYYYMMDD_HHMMSS.yaml/.pgm`。
2. 被选地图改名为 `my_map.yaml/.pgm`。
3. 两个 YAML 的 `image` 字段分别更新为对应的新 PGM 文件名。
4. 所有 `route_patrol_*.json` 改名为
   `deprecated_route_patrol_<编号>_YYYYMMDD_HHMMSS.json`，避免新地图继续
   自动加载旧坐标路线。

成功返回：

```ts
type ConfirmDefaultMapResult = {
  changed: boolean;
  default_applied: true;
  default: MapInfo;
  archived_previous_map: {
    yaml_file: string;
    pgm_file: string;
  } | null;
  archived_routes: Array<{
    from: string;
    to: string;
  }>;
  upload: {
    task_created: boolean;
    task_id: string;
    status: 'PENDING' | 'FAILED_RETRYABLE' | 'FAILED_FINAL' | 'SUCCEEDED' | 'FAILED_TO_CREATE';
    map_asset_id: string;
    error: string;
    content_identity_sha256: string;
  };
};
```

对当前 `my_map` 再次调用时返回成功且 `changed=false`，不会重复归档。
默认地图切换成功后，即使快照或上传任务创建失败也不会回滚；此时 HTTP 仍返回成功，
`default_applied=true` 且 `upload.status=FAILED_TO_CREATE`。APP 只展示中文上传状态、
`map_asset_id` 和简短错误，不读取或上传 YAML/PGM，不保存设备 Token。

### POST `/api/debug/maps/{map_name}/rename`

请求体：`{"new_name":"新名称"}`。只能重命名非默认、完整有效的地图对，
同时更新 YAML 的 `image` 字段。

### DELETE `/api/debug/maps/{map_name}`

删除非默认地图。默认 `my_map` 受保护，返回
HTTP `409`、`error=default_map_protected`。

## 实时状态

### WS `/ws/status`

用途：实时推送 `RobotStatus`，默认约 2 Hz。

数据帧类型：`ApiResponse<RobotStatus>`。

WebSocket 断开或服务端处理异常时，bridge 会发布一次零速度。APP 仍应在以下场景
主动调用 `/api/stop`：

- 用户松开方向按钮
- APP 进入后台
- 离开底盘控制页
- 网络断开或重连
- WebSocket 收到异常或长时间无数据

建议自动重连使用有限退避，例如 1、2、5 秒，并在重连期间禁用方向按钮。

## 推荐调用流程

### 底盘页

1. `GET /api/status`，确认 bridge 可连接。
2. `GET /api/debug/system/status`，显示 bringup 进程状态。
3. 用户点击启动底盘：`POST /api/debug/system/start/bringup`。
4. 轮询 `GET /api/debug/status` 或订阅 `WS /ws/status`。
5. 满足底盘就绪条件后解锁方向按钮。
6. 方向按钮调用 `POST /api/cmd_vel`。
7. 松手、离开页面、异常时调用 `POST /api/stop`。

### 建图页

1. `GET /api/debug/mapping/status`。
2. 若 `recommended_next_action="start_bringup"`，引导用户先启动底盘。
3. 用户点击开始建图：`POST /api/debug/system/start/mapping`。
4. 使用 `WS /ws/map?downsample=1` 或
   `GET /api/debug/mapping/map_snapshot?downsample=1` 显示地图。
5. `map_available=true` 后允许保存：
   `POST /api/debug/mapping/save`。
6. 保存完成后停止建图：`POST /api/debug/system/stop/mapping`。

### 地图管理页

1. `GET /api/debug/maps` 获取地图列表。
2. 选择地图后调用 `GET /api/debug/maps/{map_name}/preview` 显示预览。
3. 用户二次确认后调用
   `POST /api/debug/maps/{map_name}/confirm_default`。
4. 成功后刷新列表，并提示旧路线已经废弃，需要重新创建巡逻路线。

## APP 最小接口清单

| 页面 | 方法 | 路径 | 请求体 |
|---|---|---|---|
| 连接 | GET | `/api/status` | 无 |
| 状态 | GET | `/api/debug/status` | 无 |
| 状态 | GET | `/api/debug/system/status` | 无 |
| 底盘 | POST | `/api/debug/system/start/bringup` | 无 |
| 底盘 | POST | `/api/debug/system/stop/bringup` | 无 |
| 底盘 | POST | `/api/cmd_vel` | `VelocityCommand` |
| 底盘 | POST | `/api/stop` | 无 |
| 底盘 | POST | `/api/debug/chassis/stop` | 无 |
| 建图 | GET | `/api/debug/mapping/status` | 无 |
| 建图 | POST | `/api/debug/system/start/mapping` | 无 |
| 建图 | GET | `/api/debug/mapping/map_snapshot?downsample=1` | 无 |
| 建图 | POST | `/api/debug/mapping/save` | `MappingSaveRequest` |
| 建图 | POST | `/api/debug/system/stop/mapping` | 无 |
| 地图 | GET | `/api/debug/maps` | 无 |
| 地图 | GET | `/api/debug/maps/{map_name}/preview` | 无 |
| 地图 | POST | `/api/debug/maps/{map_name}/confirm_default` | 无 |
| 地图 | POST | `/api/debug/maps/{map_name}/rename` | `MapRenameRequest` |
| 地图 | DELETE | `/api/debug/maps/{map_name}` | 无 |
| 实时 | WS | `/ws/status` | 无 |
| 实时 | WS | `/ws/map?downsample=1` | 无 |

兼容但不推荐新 APP 使用：

| 方法 | 路径 | 说明 |
|---|---|---|
| POST | `/api/debug/mapping/start` | 等同启动 mapping，会清空旧地图缓存 |
| POST | `/api/debug/mapping/stop` | 等同停止 mapping，会清空地图缓存 |
| POST | `/api/debug/chassis/test` | 等同 `/api/cmd_vel`，多 `mode` 字段 |

明确不支持给 APP 使用：

| 方法 | 路径 | 结果 |
|---|---|---|
| POST | `/api/debug/system/start/navigation` | HTTP 404, `error=not_found` |
| POST | `/api/debug/system/stop/navigation` | HTTP 404, `error=not_found` |

## 常见问题

- 手机连不上：先在 Jetson 本机执行
  `curl http://localhost:8000/api/status`，确认 bridge 是否启动。
- 底盘未就绪：检查 `/api/debug/status` 中 `/odom`、`/scan`、`/imu/data`、
  `nodes.tf` 和对应 age 字段。
- 启动失败：查看 `/api/debug/system/status` 中对应进程的 `returncode`、
  `log_path` 和 `log_tail`。
- APP 看到旧地图：新接口已在建图启动/停止时清空缓存，并且只接受
  SLAM Toolbox 的当前地图；若仍出现旧图，检查 APP 是否使用了本地图片缓存。
- 建图一直 `no_map` 且 `nodes.map_server=true`：先停止外部导航或静态地图
  服务，不能与 APP 建图调试同时运行。
- `no_map`：建图刚启动、SLAM 尚未发布地图、底盘数据缺失，或建图已停止。
- 保存失败：只有 `map_available=true` 后才能保存；保存时按钮需要 loading。
- 停止无效：`managed_by_bridge=false` 表示该进程不是本次 bridge 启动，应由
  原 SSH/终端会话管理。
- HTTP `422`：检查 `duration_ms`、`downsample`、`map_name` 和请求体类型。
