liaojingwu20041031/electric-power-inspection-robot/src/ylhb_mobile_bridge/config/mobile_bridge.yaml

mobile_bridge:
  ros__parameters:
    host: "0.0.0.0"
    port: 8000
    cmd_vel_topic: "/cmd_vel"
    text_command_topic: "/inspection_ai/text_command"
    odom_topic: "/odom"
    scan_topic: "/scan"
    map_topic: "/map"
    imu_topic: "/imu/data"
    gps_fix_topic: "/gps/fix"
    gps_status_topic: "/gps/rtk_status"
    gps_stale_timeout_sec: 3.0
    amcl_pose_topic: "/amcl_pose"
    zlac_status_topic: "/zlac8015d/status"
    zlac_fault_topic: "/zlac8015d/fault"
    system_mode_topic: "/inspection_ai/system_mode"
    system_command_topic: "/inspection_ai/system_command"
    system_status_topic: "/inspection_ai/system_status"
    patrol_command_topic: "/patrol/command"
    patrol_status_topic: "/patrol/status"
    patrol_event_topic: "/patrol/event"
    inspection_image_topic: "/zed/zed_node/rgb/color/rect/image/compressed"
    inspection_image_moving_interval_sec: 10.0
    inspection_image_moving_max_edge: 640
    inspection_image_moving_jpeg_quality: 70
    inspection_image_arrival_delay_sec: 1.0
    inspection_image_capture_timeout_sec: 5.0
    status_rate_hz: 2.0
    map_stream_rate_hz: 1.0
    map_max_size_px: 1024
    require_token: false
    api_token: ""
    robot_id: ""
    platform_api_token: ""
    platform_storage_dir: "~/.local/share/ylhb/platform"
    cloud_status_topic: "/mobile_bridge/cloud_status"
    set_cloud_enabled_service_name: "/mobile_bridge/set_cloud_enabled"
    local_app_status_topic: "/mobile_bridge/local_app_status"
    set_local_app_enabled_service_name: "/mobile_bridge/set_local_app_enabled"
    scene_asset_ready_topic: "/inspection_ai/scene_asset_ready"
    scene_upload_command_topic: "/inspection_ai/scene_upload_command"
    scene_upload_status_topic: "/inspection_ai/scene_upload_status"
    scene_upload_allowed_root: "/home/nvidia/ros2_DL/runs/3d_reconstruct"
    # Cloud pull configuration is environment-only: YLHB_CLOUD_*; never put tokens here.
    max_linear_speed: 0.30
    max_angular_speed: 0.55
    default_cmd_duration_ms: 300
    workspace_dir: "/home/nvidia/ros2_DL"
    default_map_path: "/home/nvidia/ros2_DL/maps/my_map"
