liaojingwu20041031/electric-power-inspection-robot/(commit log)

2026-05-11 Fix voice playback device contention
2026-05-12 Fix voice session TTS pause timing
    [llm.yaml]
2026-05-12 chore: 添加 git 发布脚本和中文提示
2026-05-20 docs: document mechanical CAD assets
2026-05-21 Revert "Add retail cart 3D model files under CAD"
    [小车底盘 - 万向轮-1 万向轮-1.STL, 小车底盘 - 万向轮-1 万向轮底座-1.STL, 小车底盘 - 万向轮-1 万向轮支架-1.STL, 小车底盘 - 上底盘-1.STL, 小车底盘 - 人工智能小车底盘-1.STL, 小车底盘 - 前半圆X-1.STL, 小车底盘 - 后半圆-3.STL, 小车底盘 - 后半圆X-2.STL]
2026-05-23 fix: persist hardware guard and stabilize IMU
    [imu_driver.cpp]
2026-06-11 Update and reorganize retail cart 3D models
    [万向轮.SLDASM, 万向轮.SLDPRT, 万向轮底座.SLDPRT, 万向轮支架.SLDPRT, 上底盘.SLDPRT, 人工智能小车底盘.SLDPRT, 伸缩杆.SLDPRT, 伸缩杆固定底座.3MF]
2026-06-19 docs: migrate project identity to power inspection
2026-06-19 refactor: reset llm layer for inspection robot
    [llm.yaml]
2026-06-21 feat: integrate IMU and update robot configuration
    [ylhb.urdf.xacro]
2026-06-21 fix(robot): improve mapping and IMU stability
    - lower SLAM keyframe motion thresholds and add config coverage
    - publish IMU covariance data from a ROS timer callback
    - refresh the saved map and document velocity tuning
2026-06-21 fix(nav2): align costmap footprint with urdf
2026-06-21 fix(nav2): reduce laser map transform skew
    Tighten Nav2 TF tolerances, reduce AMCL load, keep scan obstacles local, and update the current navigation map.
2026-06-23 fix: chamfer Nav2 footprint
2026-06-23 fix(nav2): improve stall recovery behavior
2026-06-23 fix(nav2): model eccentric cylinder footprint
    [ylhb.urdf.xacro]
2026-06-23 feat: add WTRTK980 RTK bringup
    [ylhb.urdf.xacro]
2026-06-30 fix: stabilize patrol UI startup flow
2026-06-30 fix: stabilize voice agent interaction
    [llm.yaml]
2026-07-05 feat: add dynamic inspection agent tools
    [robot_capabilities.yaml]
2026-07-05 fix: improve voice wake phrase matching
    [llm.yaml]
2026-07-10 fix: update keepout setup check for absolute topics and disabled local filter
2026-07-10 fix(nav2): restore stable patrol lifecycle and keepout navigation
    [rplidar_node.cpp]
2026-07-11 fix(nav2): keep inflation costs soft with footprint critic
2026-07-12 feat(agent): harden planner protocol and startup
    [robot_capabilities.yaml]
2026-07-12 fix(config): remove agent workspace and device hardcoding
    [llm.yaml]
2026-07-12 fix(agent): unify routes and provider configuration
    [llm.yaml]
2026-07-12 fix(agent): wire status and operation managers
2026-07-12 refactor(agent): add capability command metadata
    [robot_capabilities.yaml]
2026-07-13 feat(robot): add platform adapter and route auto fix
    [mobile_bridge.yaml]
2026-07-13 fix(robot): harden cloud commands and add UI connection control
    [mobile_bridge.yaml]
2026-07-14 docs: 完善并中文化项目文档
2026-07-15 fix(nav2,ui): restore dynamic safety and add bezel-safe shutdown
    [base_controller.cpp, llm.yaml]
2026-07-15 fix(safety): default collision monitor to driver-only mode
2026-07-15 fix(robot): restore navigation safety flow
    [zlac8015d.yaml]
2026-07-15 fix(nav2): save best turn-speed baseline
    [base_kinematics.yaml, zlac8015d.yaml]
2026-07-16 feat(robot): add closed-loop voice agent
    [robot_capabilities.yaml]
2026-07-17 fix: stabilize inspection robot runtime
    [robot_capabilities.yaml]
2026-07-20 fix(ai): support route-free startup and KWS aliases
    [llm.yaml]
2026-07-21 feat: add local-confirm patrol and robot diagnostics
    [robot_capabilities.yaml]
2026-07-22 feat: complete inspection agent patrol and 3d workflows
    [robot_capabilities.yaml]
2026-07-22 fix(agent): stabilize runtime tool protocol and voice UI
    [robot_capabilities.yaml]
